AjayaDahal/vtol-plane/README.md

<div align="center">

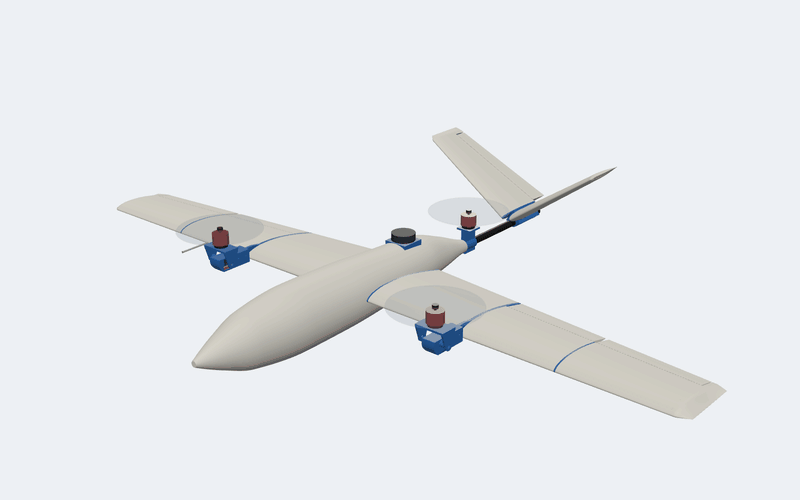
[picture p1: renders/anim_turntable.gif]
The VTOL plane on a turntable: a tilt-rotor tricopter with a V-tail, motors up for hover


# VTOL Plane

### A 3-D printed tilt-rotor tricopter: it takes off like a drone and flies like a plane









**[▶ Open the live 3-D viewer](https://ajayadahal.github.io/vtol-plane/)** ·
[Design](DESIGN.md) · [Bill of materials](BOM.md) · [Print tracker](tracker.md) ·
[PX4 setup](PX4_GUIDE.md) · [Simulation](SIMULATION.md) · [Review report](REPORT.md)

</div>

Two motors on tilting yokes lift the aircraft in hover and swing forward for cruise; a third,
fixed motor at the tail shares the hover load. In forward flight a Clark Y wing and a V-tail carry
it, under PX4 on a Pixhawk 6C. The airframe is a single-wall LW-PLA shell, printed in vase mode,
over PETG ribs and frames and carbon spars and boom.

Every part is generated by Python from one parameter file, laid out and sliced from the command
line, and checked by an automated gate (fits, flush joints, paths, clearances, balance, hover
margin and the G-code itself) before any filament is used. The gate runs on every push.

## At a glance

| | |
|---|---|
| **Configuration** | Tilt-rotor tricopter VTOL: two front motors tilting −20…90°, one fixed rear lift motor, V-tail |
| **Span · length** | 1478 mm · ~1.1 m |
| **All-up weight** | ~2.0 kg with a 4S 5000 mAh pack |
| **Wing** | Clark Y, flat bottom, straight leading edge, 220 → 150 mm chord, 0.27 m², Hoerner tips |
| **Tail** | V-tail, NACA 0012, 110° included angle, ruddervators |
| **Power** | 3 × Emax ECOII 2807 1700 KV, 7 × 4.5 props, 3 × 50 A DShot ESCs |
| **Avionics** | Pixhawk 6C (PX4), M10 GPS on an external saddle, digital airspeed sensor with pitot, ELRS |
| **Speeds** | cruise ~18 m/s, stall 10–11.5 m/s (estimates) |
| **Hover** | ~7 min pure hover (estimate); front motors kept under 60 % of their thrust |
| **Airframe** | LW-PLA vase-mode skins with fused internal webs, PETG structure, carbon tubes |
| **Printers** | Kobra X: every LW-PLA skin (~49 h, one spool) · Kobra S1: the PETG as 7 plates (~16 h) |

Exact numbers (from `scripts/mass_balance.py`): [`DESIGN.md`](DESIGN.md#key-numbers).

## See it move

<table>
<tr>
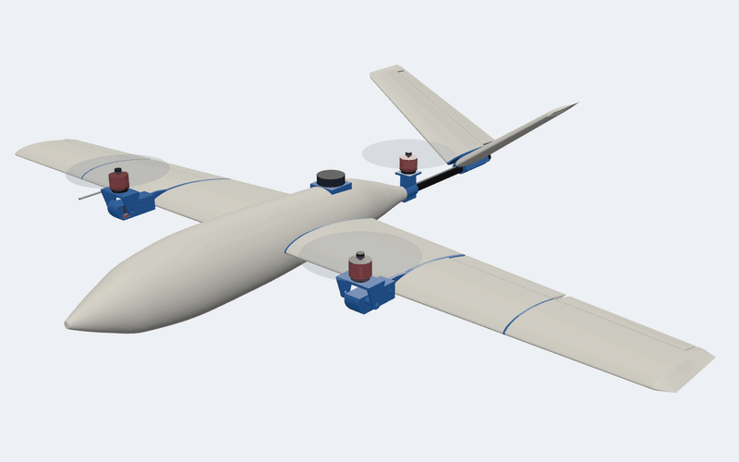
[picture p2: renders/anim_transition.gif]
The front motors tilt from straight up to straight ahead
<td width="50%"><br>
<b>Hover → cruise.</b> The yokes swing the front motors from straight up to straight ahead.</td>
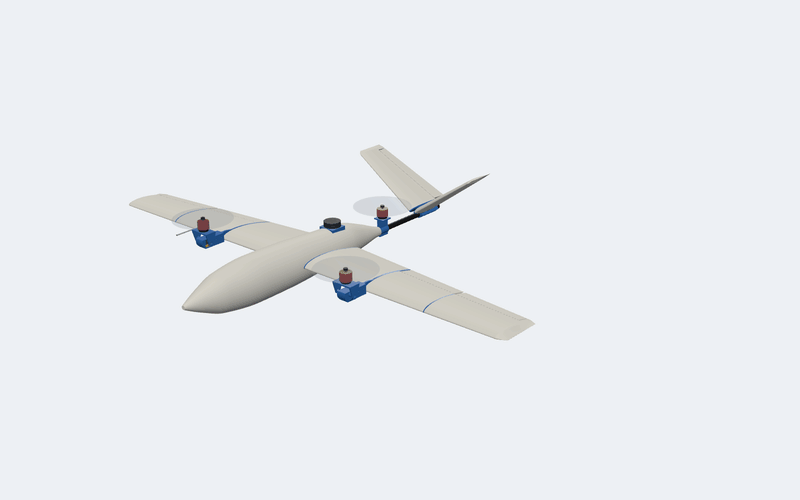
[picture p3: renders/anim_burst.gif]
Burst view: every part moves out along the way it goes together
<td width="50%"><br>
<b>Burst view.</b> Every part moves out along the way it goes together, electronics included.</td>
</tr>
<tr>
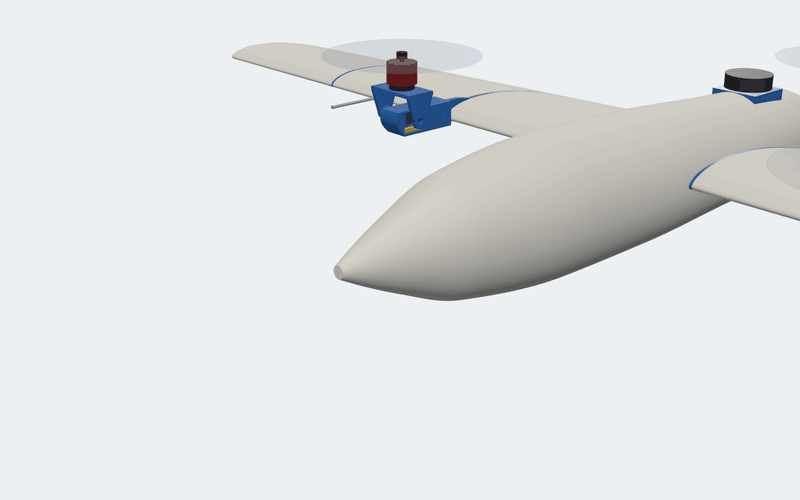
[picture p4: renders/anim_nose_battery.gif]
The nose slides off and the battery comes out forward
<td><br>
<b>Battery change.</b> One nylon screw holds the nose; the pack slides out through the coupler ring.</td>
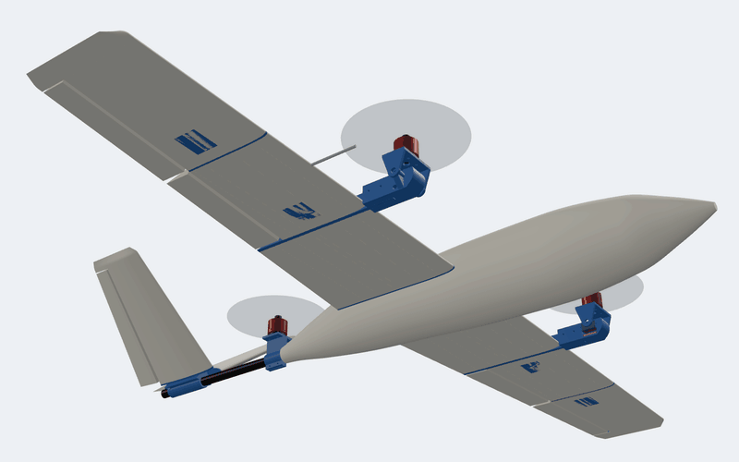
[picture p5: renders/anim_service.gif]
Servo hatches come out, the yokes lift off and the tilt servos slide out
<td><br>
<b>Servicing.</b> Every control servo sits on a screwed hatch, and the yokes lift off their pods.</td>
</tr>
</table>

## See it fly, in simulation

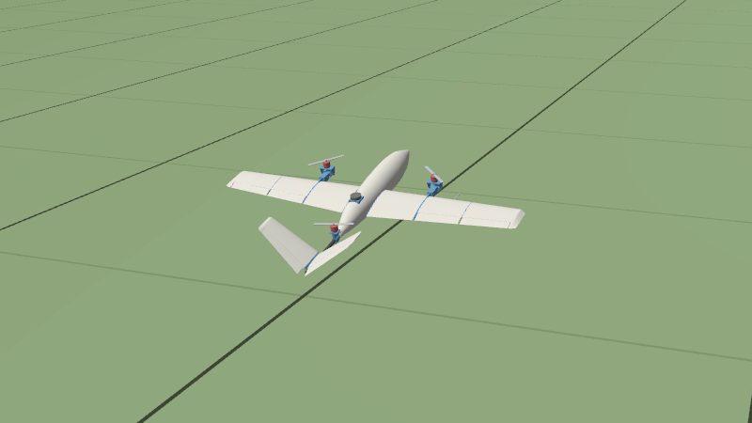
[picture p6: renders/52_sim_flight.png]
The check flight in Gazebo: the back transition, motors swinging up to hover


PX4 v1.17 flies a Gazebo model generated from the design through the whole mission: vertical
takeoff, transition, a circuit at 18 m/s, back transition and a landing on the pad
([video](renders/sim_flight.mp4), 3 min 42 s). It changed the transition: it ends at 14 m/s
and is flown 2° nose-down, because held level the aircraft never reaches 18. Its stress tests
(heavier, a near-empty pack, no airspeed sensor, a wing that lifts more) say to fit the 3S
plan's bigger motors before flying ([`SIMULATION.md`](SIMULATION.md)).

## Explore it in 3-D

| | |
|---|---|
| ✈️ **[Live viewer](https://ajayadahal.github.io/vtol-plane/)** | The full three.js viewer in your browser: orbit, burst view, battery and service animations, tilt slider, x-ray, section cuts, reflection stripes for checking smoothness, and every print file and PETG plate on its printer's bed with its sliced mass and time. |
| 🧊 **[`renders/vtol_plane.stl`](renders/vtol_plane.stl)** | The outside of the whole aircraft in GitHub's own 3-D viewer: drag to spin, scroll to zoom. |
| 💻 **`python scripts/serve_viewer.py`** | The same viewer from your clone, at <http://127.0.0.1:28765/viewer/>. |

The live viewer is this repository served by GitHub Pages (*Settings → Pages → Deploy from a
branch → `main`, `/ (root)`*); the root `index.html` opens `viewer/`.

## Gallery

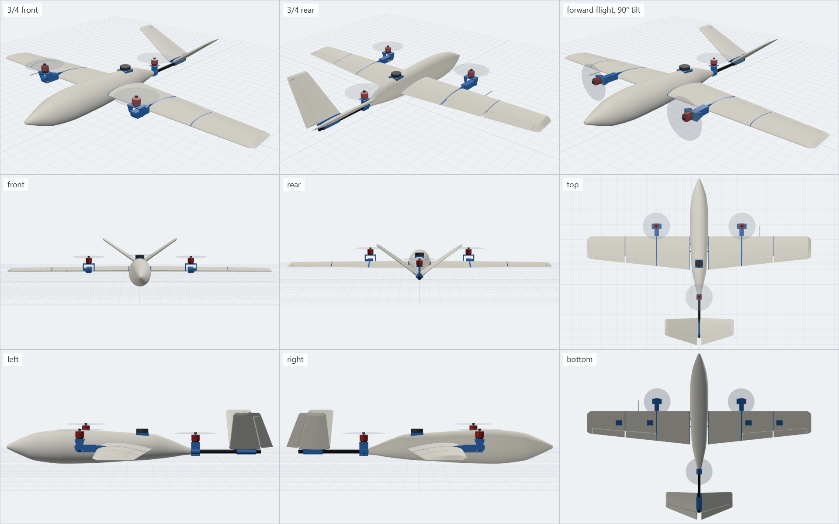
[picture p7: renders/00_all_sides.png]
The aircraft from every side


<details>
<summary><b>Wing smoothness</b>: one colour and reflection stripes across every glued joint</summary>
<br>
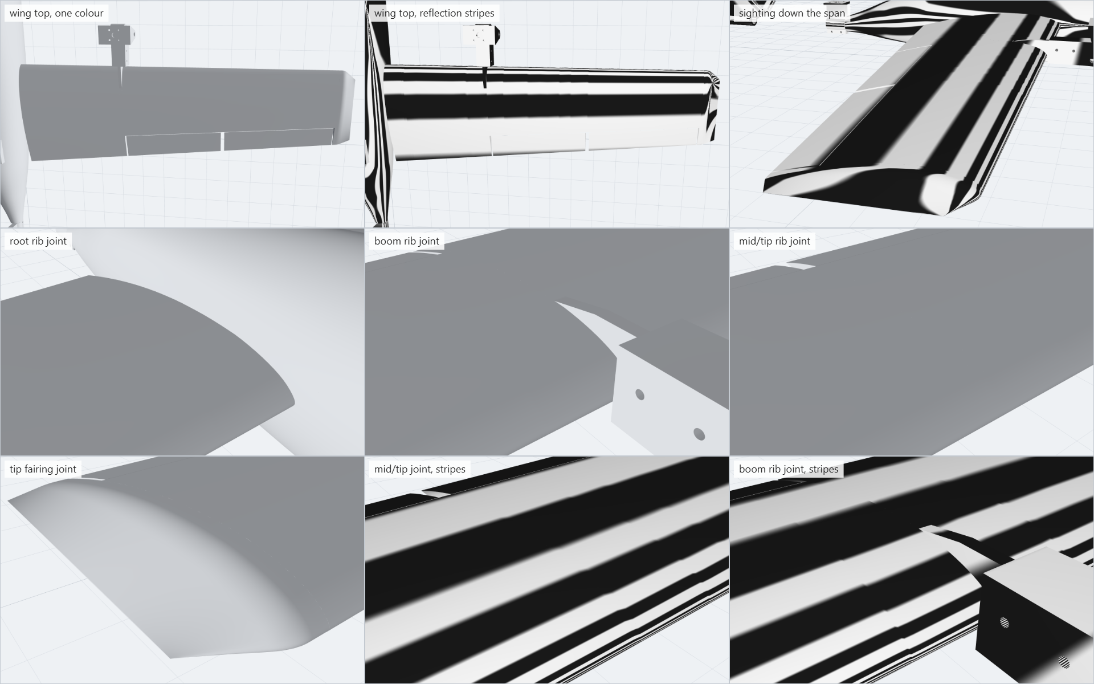
[picture p8: renders/00_wing_smoothness.png]
Wing joints in one colour and with reflection stripes


The stripes run straight across every seam: the rib flanges continue the skin's taper, and the gate
holds every glued joint flush to 0.15 mm ([DESIGN.md](DESIGN.md#finish-making-the-glued-wing-read-as-one-piece)).
</details>

<details>
<summary><b>Inside the airframe</b>: burst view, section cuts and the electronics bay</summary>
<br>
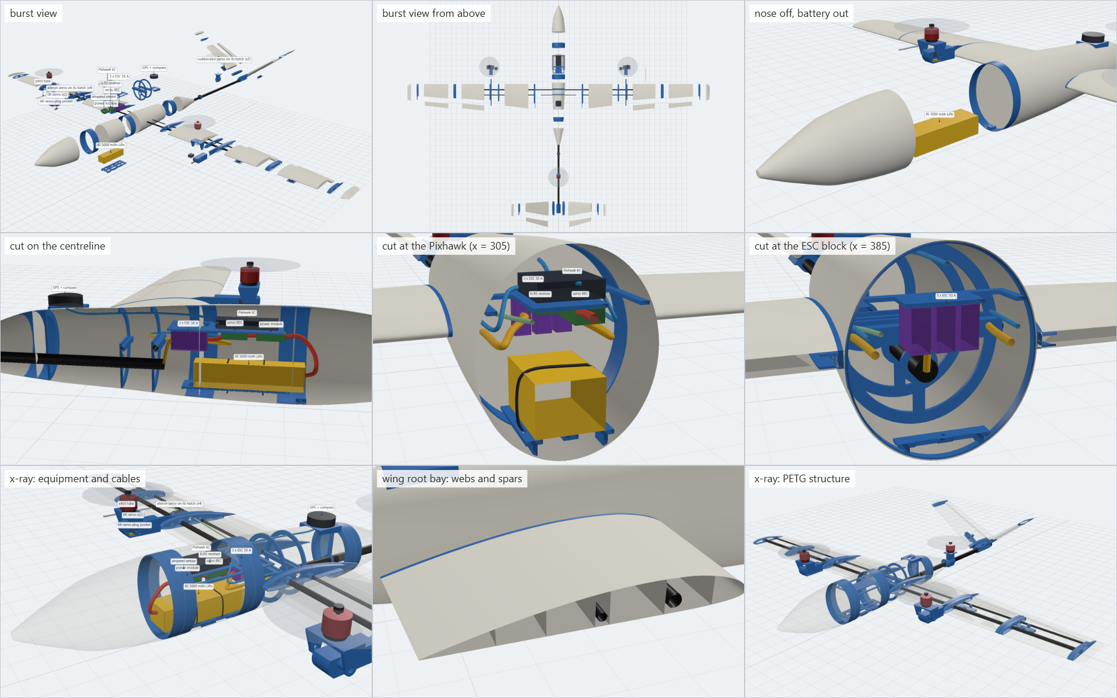
[picture p9: renders/00_inside_and_burst.png]
Burst view, cuts along the centreline, at the Pixhawk and at the ESC block, x-ray

</details>

<details>
<summary><b>Servicing</b>: battery, servo hatches, yokes and tilt servos</summary>
<br>
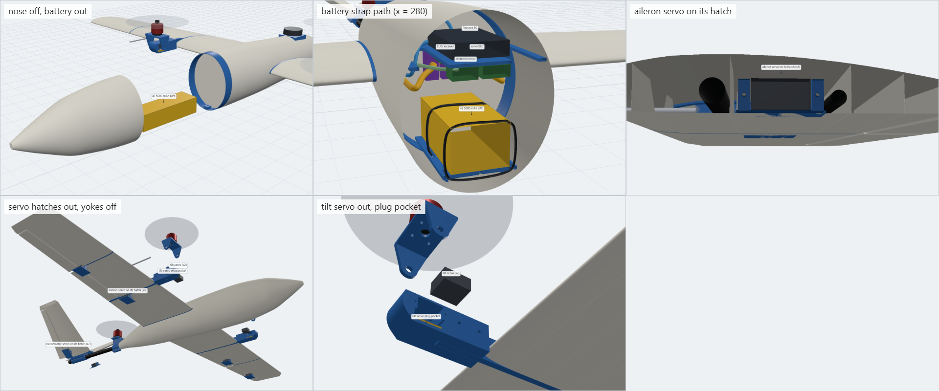
[picture p10: renders/00_servicing.png]
Battery out through the nose, servo hatches out, yokes off

</details>

<details>
<summary><b>Tips</b>: Hoerner wing tips and V-tail tip fairings</summary>
<br>
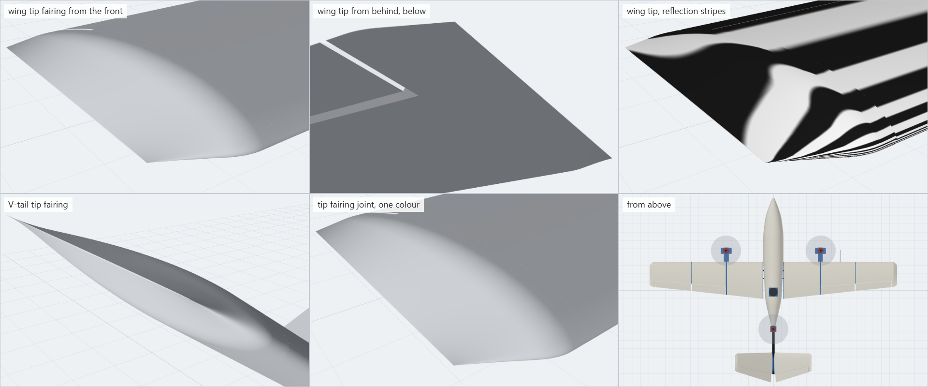
[picture p11: renders/00_tips.png]
Wing and V-tail tip fairings

</details>

<details>
<summary><b>Print files</b>: every part and the seven PETG plates on their beds</summary>
<br>
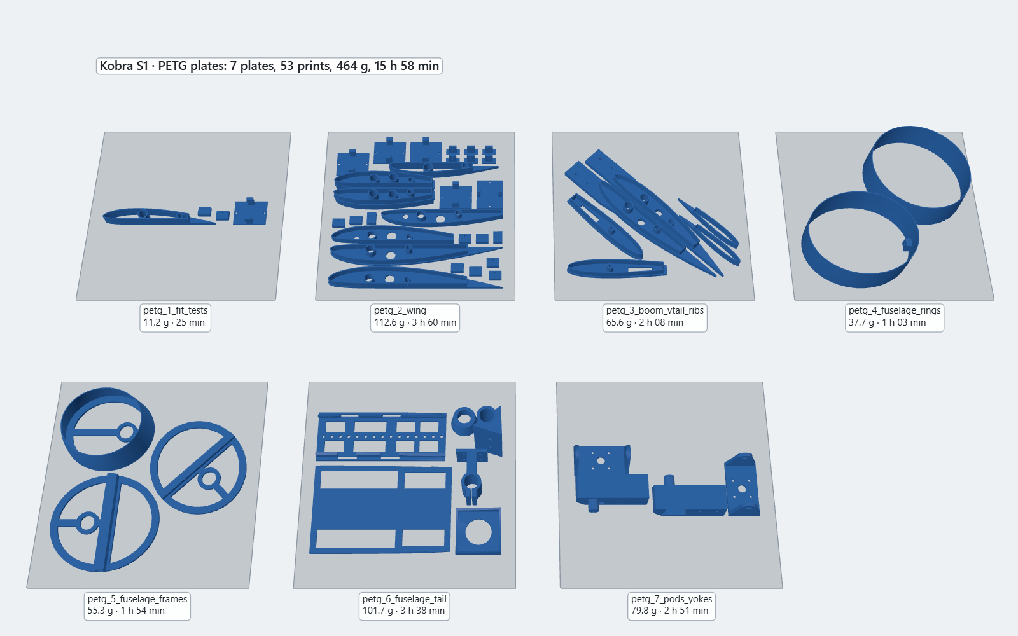
[picture p12: renders/47_print_plates_s1_petg.png]
The seven PETG plates on the Kobra S1

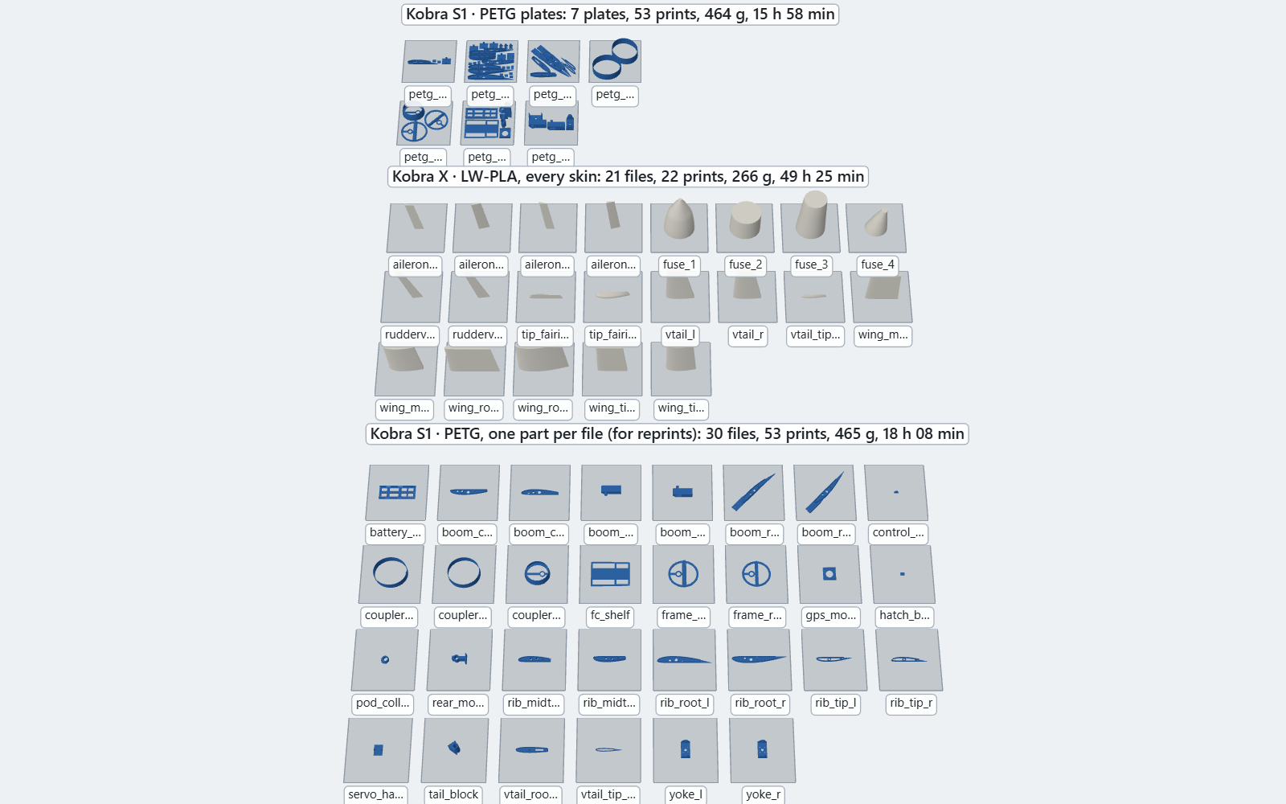
[picture p13: renders/35_print_files_all.png]
Every print file on its bed

</details>

<details>
<summary><b>Sliced</b>: every plate as the slicer prints it, first layers, and where supports would go</summary>
<br>
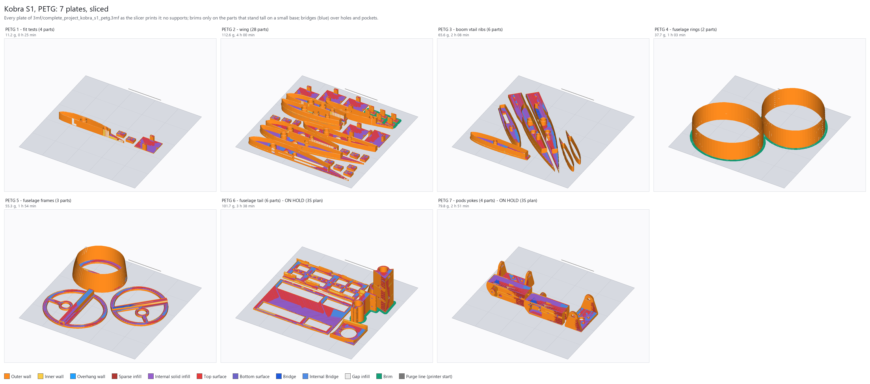
[picture p14: renders/49_sliced_plates_s1_petg.png]
The seven PETG plates sliced: walls, infill, bridges and brims, no supports

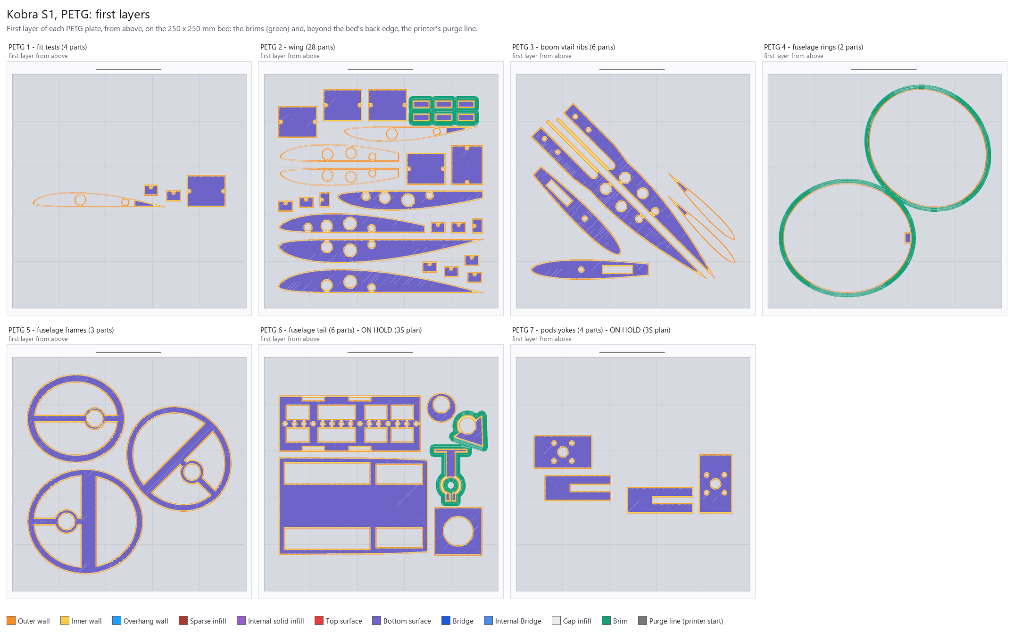
[picture p15: renders/50_first_layers_s1_petg.png]
The PETG plates' first layers from above, with brims and the purge line

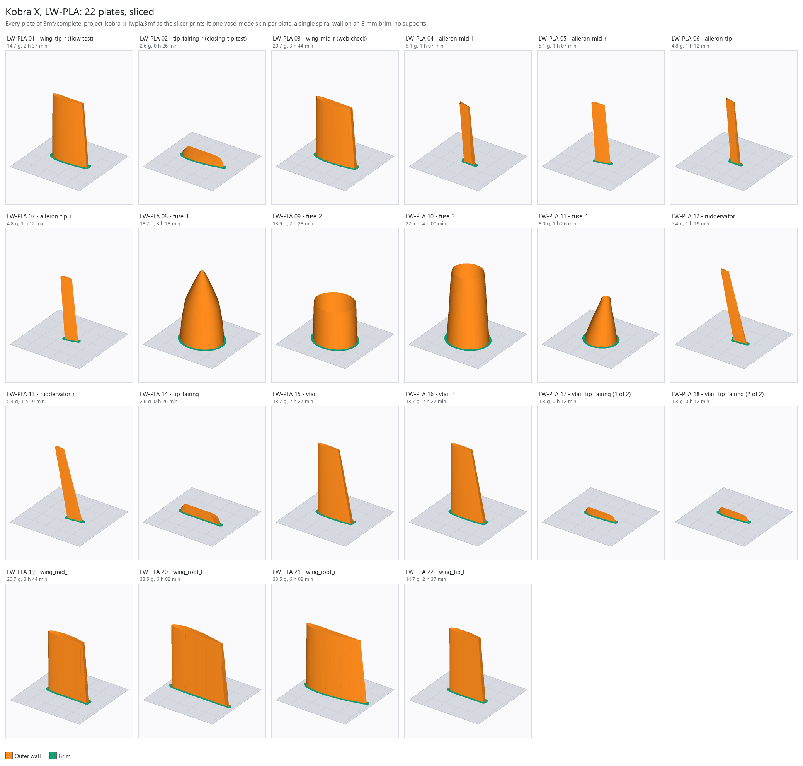
[picture p16: renders/48_sliced_plates_x_lwpla.png]
The Kobra X's 22 LW-PLA plates sliced: one vase skin each on its brim


Drawn from the G-code like the slicer's preview, coloured by feature. No part prints with
supports. Below, where the slicer would add them if it could: all inside holes or under spans
that bridge, which the gate measures in the G-code
([SLICING.md](SLICING.md#slice-previews-and-the-support-audit)).

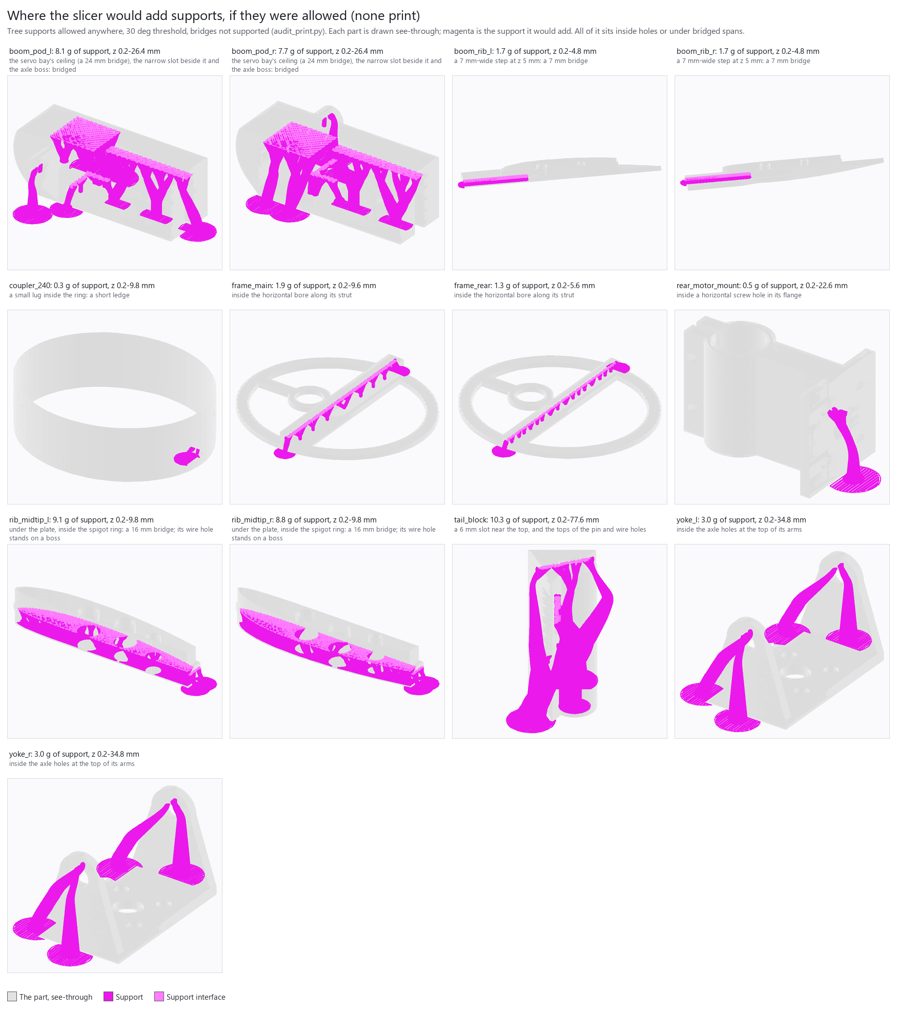
[picture p17: renders/51_support_audit_petg.png]
Where the slicer would add supports, drawn see-through in magenta

</details>

## How it is built

- **Skins** are LW-PLA printed in vase mode: one continuous ~0.5 mm wall, foamed to about half
  the density of PLA. The wing's root and mid sections carry spanwise webs that the single wall
  runs into and fuses to, so the skin does not oil-can
  ([inside the wing](DESIGN.md#inside-the-wing-ribs-spars-and-webs)).
- **Structure** is PETG: ribs whose spigots the skins slide over, fuselage couplers and frames,
  the tilt-servo pods and yokes, the tail block. Carbon tubes do the bending: 10 mm and 6 mm
  wing spars on joiners, a 16 mm tail boom.
- **Joints read as one piece.** Each rib flange continues the skin's taper; the tips close in
  vase-mode fairings over hidden rings ([tips](DESIGN.md#tips)).
- **Nothing replaceable is glued in.** The nose comes off for the battery and the electronics,
  every control servo is on a screwed hatch, and the tilt servos come out with the yokes
  ([servicing](DESIGN.md#servicing-battery-servos-and-motors)).

## From parameters to G-code

```mermaid
flowchart LR
    P["params.py<br/>every dimension"] --> SK["skins.py<br/>LW-PLA vase skins"]
    P --> ST["structure.py<br/>PETG parts, build123d"]
    SK & ST --> AS[("parts/assembly")]
    AS --> PR["make_print_ready.py<br/>print orientation, printer, copies"]
    PR --> PRS[("parts/print_ready")]
    PRS --> SL["slice_all.py + plates.py<br/>Anycubic Slicer Next CLI"]
    SL --> GC[("gcode/")]
    SL --> TM[("3mf/<br/>a project per job")]
    TM --> MP["make_projects.py<br/>a project per printer,<br/>a plate per job"]
    GC --> MV["make_viewer.py<br/>viewer manifest, vtol_plane.stl"]
    MV --> MT["make_tracker.py<br/>tracker tables, schedule chart"]
    GC --> MB["mass_balance.py<br/>mass, CG, hover, PX4 numbers"]
    PL["payload.py<br/>electronics and cable runs"] --> MB
    MB --> SIM["make_sim.py<br/>Gazebo model, PX4 airframe"]
    MT & MB & MP & SIM --> G{{"check_parts.py<br/>verification gate"}}
```

Change a number in `scripts/params.py` and run `python scripts/build_all.py`. It rebuilds every
part, re-slices every file and plate, assembles the two complete slicer projects (and slices each
of their plates again to check it), regenerates the viewer, the tracker, the schedule chart and
the flight simulation's model, and runs the gate.

<details>
<summary><b>What the gate checks</b></summary>
<br>

- **Meshes:** watertight, left and right parts true mirror images, parts printed from one file for
  both sides truly symmetric.
- **Fits:** every spigot, coupler, frame, ring and hatch, with its glue gap.
- **Finish:** every glued skin joint flush and crease-free.
- **Paths:** spars, joiners, the tail boom and every wire route are clear.
- **Mechanism:** motor screw holes with hex-key room, the tilt sweep, and the prop clearances.
- **Balance:** thrust split, CG band, static margin, and the hover margin (front motors at most
  60 % of their near-empty thrust).
- **Printability:** no part needs supports (overhangs are bridges or short ledges), and no vase
  wall leans more than 45°.
- **Equipment:** every item fits clear of the skin and the inserts, the battery slides out
  through the nose, the straps loop round it, and every servo comes out through its hatch.
- **G-code:**
  - every part and plate is present and sliced from the current STL (hash stamps), with no stray
    files;
  - every move is inside the printer's height and every extrusion inside its bed;
  - there are no support moves, and the vase walls print in one speed band;
  - the wing webs print fused, and every part is its own object where the script placed it;
  - brims only where the print table puts them: every vase skin, and the PETG parts that stand
    taller than the root of their first-layer contact area;
  - nothing far over air: every PETG bridge spans at most 30 mm, every wall lies within 3 mm of
    the layer below.
- **Slicer projects:** each job's 3MF carries the G-code's stamp and the right presets, and the
  two complete projects are what `make_projects.py` builds from them.
- **Docs:** the viewer manifest, `tracker.md`, the schedule chart and the slice previews match the
  sliced files.
- **Simulation:** the Gazebo model, world and PX4 airframe in `sim/` are what `make_sim.py` builds
  from the current design, and the model's static margin agrees with the mass balance.

The results and the reasoning behind every check: [`REPORT.md`](REPORT.md).
</details>

## Printing it

Print queue: the Kobra X prints every LW-PLA skin, the Kobra S1 seven PETG plates

One material per printer. The **Kobra X** prints every LW-PLA skin, from one spool with one flow
calibration. The skins print one per job: vase-mode parts can share a bed only by printing one
after another, and the skins stand taller than the print head's gantry clearance. The
**Kobra S1** prints all the PETG, laid out as seven plates in build order. Start with the test
prints (orange above): `wing_tip_r` checks the LW-PLA flow, and plate `petg_1_fit_tests` checks
the spigot and servo-hatch fits. The files are sliced for **active-foaming** LW-PLA
([`BOM.md`](BOM.md#filament)). Then work down [`tracker.md`](tracker.md), which also
carries the [reminders](tracker.md#reminders-for-print-time-agents-raise-these-with-the-user-when-printing-starts)
to tick off along the way. The chart is redrawn from the sliced files on every build.

Every job comes three ways:
- **a complete project per printer**, the easiest:
  [`3mf/complete_project_kobra_x_lwpla.3mf`](3mf/complete_project_kobra_x_lwpla.3mf) (22 plates)
  and [`3mf/complete_project_kobra_s1_petg.3mf`](3mf/complete_project_kobra_s1_petg.3mf)
  (7 plates). Each job is a named plate, in print order (`LW-PLA 01 - wing_tip_r (flow test)`,
  `PETG 6 - fuselage tail (6 parts) - ON HOLD (3S plan)`). Open it in Anycubic Slicer Next, pick
  a plate, slice it, check the preview and send it;
- a **3MF project per job** in [`3mf/`](3mf), in the same folders and under the same names as
  the G-code;
- **G-code** in [`gcode/`](gcode), the same job already sliced.

The projects hold the parts in place and every setting, and the G-code is sliced from them
([`SLICING.md`](SLICING.md#3mf-projects-sending-a-job-from-the-slicer)).

## Flight setup

```mermaid
flowchart LR
    BAT["4S 5000 mAh LiPo"] -- XT60 --> PM["Power module<br/>voltage + current"]
    PM -- power --> FC(["Pixhawk 6C · PX4"])
    PM --> ESC["3 × 50 A ESC block"]
    PM --> BEC["Servo BEC 5–6 V"]
    FC -- "AUX1–3 · DShot600" --> ESC
    ESC --> MR["Front right motor · CW"] & ML["Front left motor · CCW"] & MRR["Rear motor · CCW"]
    FC -- "MAIN1–2" --> TS["2 tilt servos"]
    FC -- "MAIN3–6" --> AI["4 aileron servos"]
    FC -- "MAIN7–8" --> RV["2 ruddervator servos"]
    BEC -. servo rail .-> TS & AI & RV
    GPS["M10 GPS + compass<br/>on the saddle"] --> FC
    ASP["Airspeed sensor<br/>pitot in the right wing"] --> FC
    RX["ELRS receiver"] --> FC
```

PX4 runs it as a *Generic Tiltrotor VTOL* with three rotors and two tilt servos.
[`PX4_GUIDE.md`](PX4_GUIDE.md) has:

- the rotor geometry and the [output mapping](PX4_GUIDE.md#output-mapping);
- tilt calibration, transition airspeeds and failsafes;
- the [first-flight sequence](PX4_GUIDE.md#first-flight-sequence).

[`SIMULATION.md`](SIMULATION.md) flies these settings in PX4's simulator, on a Gazebo model
generated from the design.

## Quick start

```bash
python -m venv .venv
.venv\Scripts\activate             # Windows; elsewhere: source .venv/bin/activate
pip install -r requirements.txt

python scripts/check_parts.py      # run the gate on the committed files
python scripts/serve_viewer.py     # the 3-D viewer at http://127.0.0.1:28765/viewer/
python scripts/build_all.py        # rebuild, re-slice and verify everything
```

`build_all.py` needs Anycubic Slicer Next 2.0.0.3: set `VTOL_SLICER` if it is not at the default
Windows path, or pass `--no-slice` to rebuild without slicing ([`SLICING.md`](SLICING.md)). To
re-render the pictures and animations after a change, open the viewer with `?capture=1` (or
`?capture=gif` for the animations only) while `serve_viewer.py` runs.

## Repository map

```text
scripts/            Python: generators, slicing pipeline, mass balance and the gate
  params.py           every dimension
  skins.py            LW-PLA vase skins: wing, fuselage, V-tail, control surfaces, tip fairings
  structure.py        PETG parts (build123d)
  payload.py          electronics: size, position and cable runs
  make_print_ready.py the print table: printer, orientation, copies
  plates.py           PETG plate layouts
  slice_all.py        slices every part and plate
  make_projects.py    the two complete slicer projects, a plate per job
  preview_slices.py   slice previews: every plate drawn from its G-code (renders/48-50)
  audit_print.py      support and stability audit in the slicer (not part of the gate; renders/51)
  mass_balance.py     mass, CG, hover thrust, PX4 numbers
  make_viewer.py      viewer manifest and renders/vtol_plane.stl
  make_tracker.py     tracker tables and renders/print_schedule.svg
  make_sim.py         the PX4 SITL model: Gazebo model, world and airframe in sim/
  check_parts.py      the verification gate
  build_all.py        all of the above, in order
  serve_viewer.py     local server for the viewer and its capture mode
sim/                PX4 + Gazebo flight simulation: install script, check flight, chase camera,
                      stress variants, and the generated model, world and airframe (SIMULATION.md)
parts/assembly/     every part where it sits in the aircraft (STL)
parts/print_ready/  every part as it lies on the bed (STL)
gcode/              x_lwpla, s1_petg (one part per file), s1_petg_plates
3mf/                slicer projects: complete_project_kobra_x_lwpla.3mf and complete_project_kobra_s1_petg.3mf
                      (a named plate per job), and one per job in the same folders as gcode/
slicer_profiles/    printer, process and filament profiles
viewer/             the three.js viewer and its manifest
renders/            pictures, animations, the exterior model and the print schedule
```

## Status

**v0.2: designed, sliced and verified; the test prints are next.** On the way to first flight
([`REPORT.md`](REPORT.md#current-status-v02-nov-5-2026)):

1. Test prints: LW-PLA flow, spigot and servo-hatch fit, the closing tips, the wing webs.
2. Measure the tilt servos against the pod bay before printing the pods and yokes.
3. Weigh the real parts and re-run the mass balance. The hover margin is thin.
4. Balance at the design CG, then glide-test.
5. Bench tests with the props off, then the first hover, then transitions at altitude.

**Simulated:** the whole mission flies in PX4 + Gazebo on `PX4_GUIDE.md`'s settings, which the
simulation and a premortem changed: the transition ends at 14 m/s and is flown 2° nose-down,
and the failsafes are set ([`SIMULATION.md`](SIMULATION.md)). The premortem's verdict: no
printed part changes, but fit the 3S plan's motors before flying (`REPORT.md`, round 13).

**Next design change: the 3S build** ([`PLAN_3S.md`](PLAN_3S.md), not built in yet). The
owner flies his own 3S packs and a Cube Black, with SunnySky X2814 900KV motors on 12 in
props. Modelled, the front motors hover at about half their thrust instead of ~59 %, for about
18 min of pure hover. Only PETG plates 6 and 7 change, so everything else prints now.

## Documentation

| File | What is in it |
|---|---|
| [`DESIGN.md`](DESIGN.md) | configuration, key numbers, parts map, assembly, servicing, hand-drilled holes |
| [`BOM.md`](BOM.md) | everything to buy, and every printed part |
| [`tracker.md`](tracker.md) | every print job and plate, print-time reminders, status |
| [`SLICING.md`](SLICING.md) | slicer profiles, the pipeline and the G-code checks |
| [`PX4_GUIDE.md`](PX4_GUIDE.md) | PX4 setup: geometry, outputs, tilt calibration, airspeeds, first flight |
| [`SIMULATION.md`](SIMULATION.md) | the PX4 + Gazebo flight simulation: the model, the results, how to run and film it |
| [`PLAN_3S.md`](PLAN_3S.md) | the planned 3S build with the owner's parts: motor choice, changes, what to buy |
| [`BOM_3S.csv`](BOM_3S.csv) | the 3S build's shopping list: every item, from the owner's parts or to buy (opens in Excel) |
| [`REPORT.md`](REPORT.md) | every design review and premortem, and the current status |
| [`AGENTS.md`](AGENTS.md) | working notes for AI coding agents on this repository |
