AjayaDahal/vtol-plane/renders/03_front.png

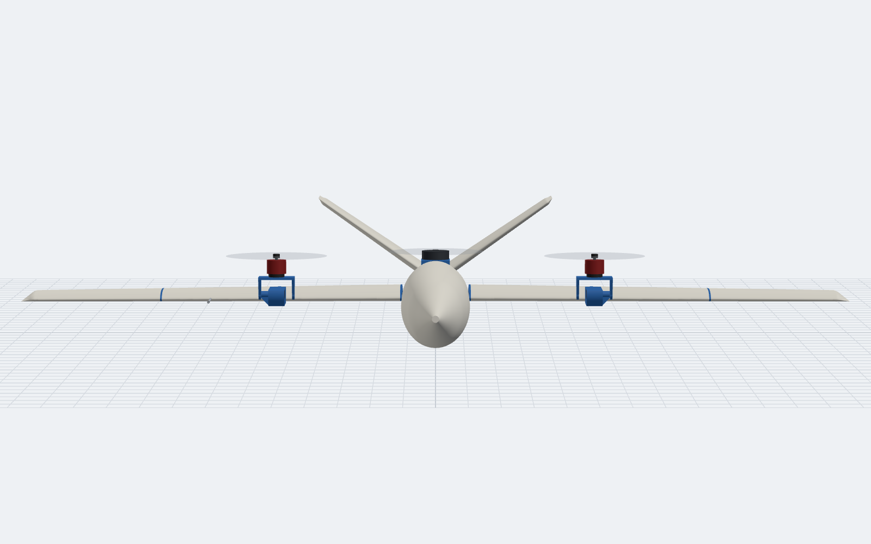
renders/03_front.png
