AjayaDahal/vtol-plane/renders/04_rear.png

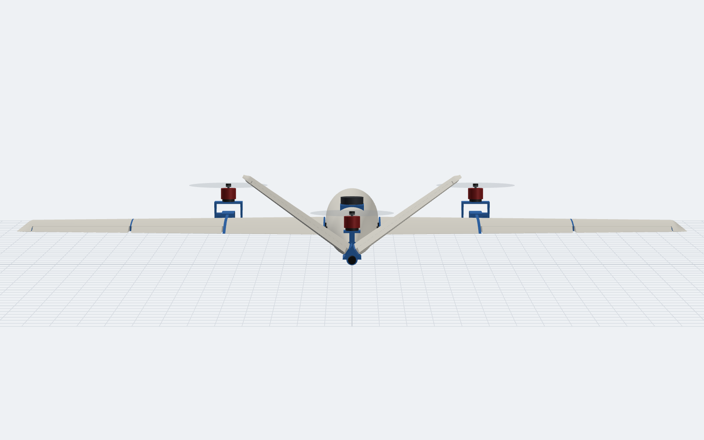
renders/04_rear.png
