AjayaDahal/vtol-plane/renders/05_left.png

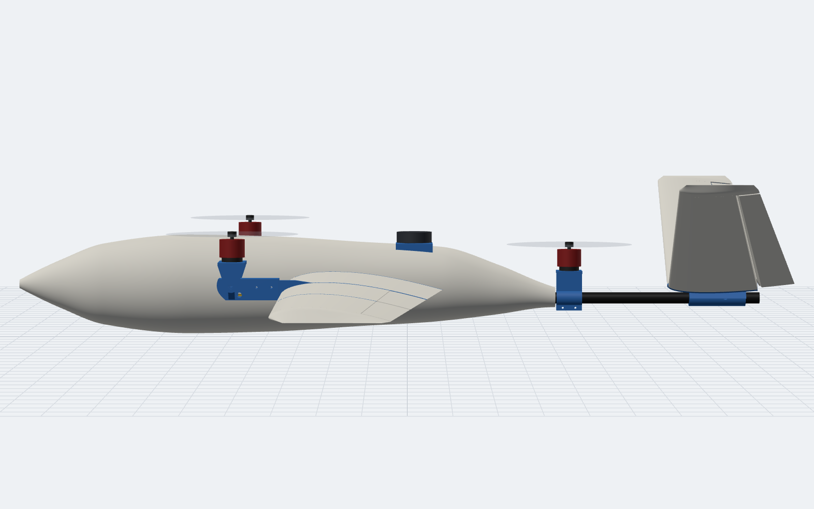
renders/05_left.png
