AjayaDahal/vtol-plane/renders/06_right.png

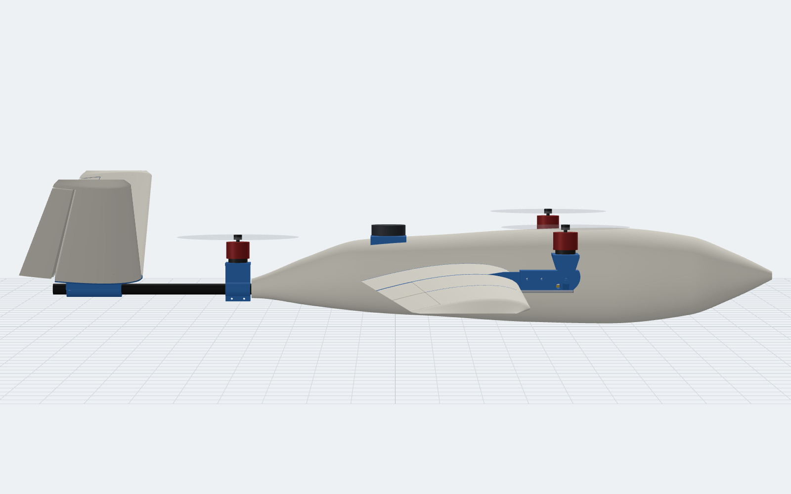
renders/06_right.png
