AjayaDahal/vtol-plane/renders/07_top.png

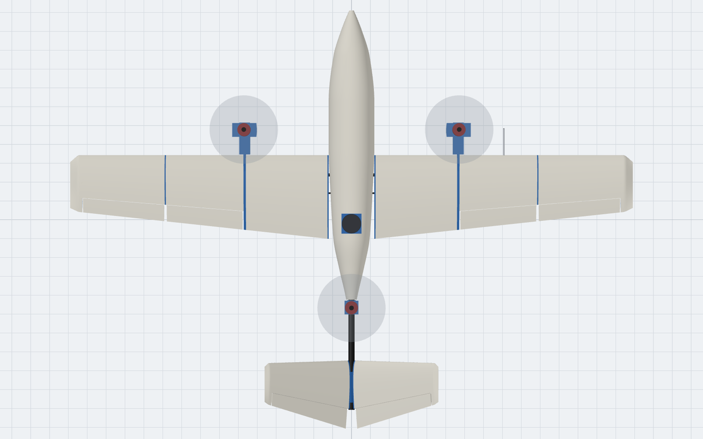
renders/07_top.png
