AjayaDahal/vtol-plane/renders/08_bottom.png

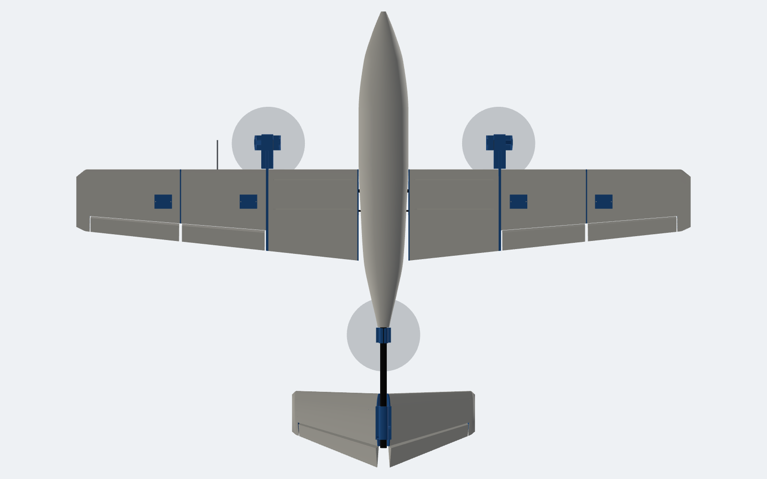
renders/08_bottom.png
