AjayaDahal/vtol-plane/renders/09_forward_flight.png

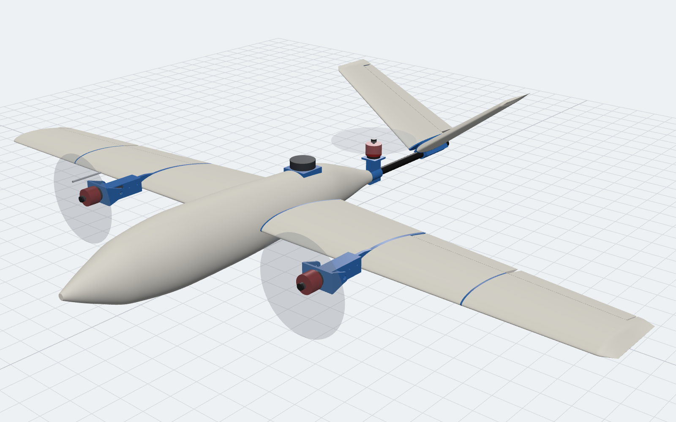
renders/09_forward_flight.png
