AjayaDahal/vtol-plane/renders/10_xray_structure.png

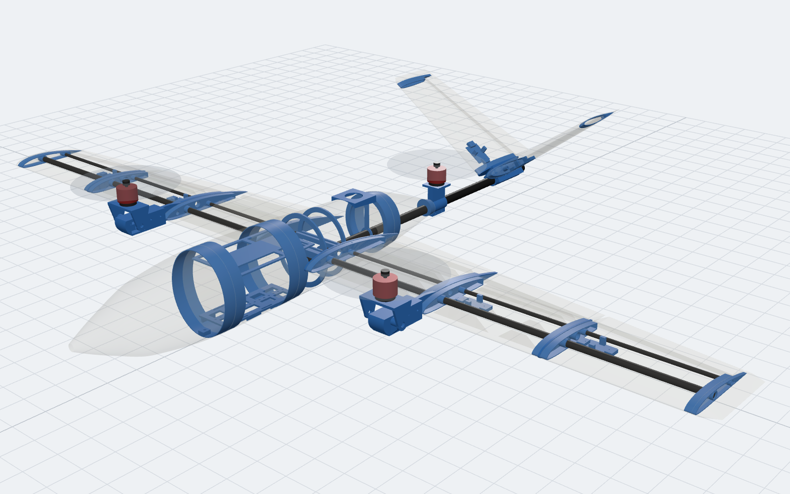
renders/10_xray_structure.png
