AjayaDahal/vtol-plane/renders/12_wing_top_one_colour.png

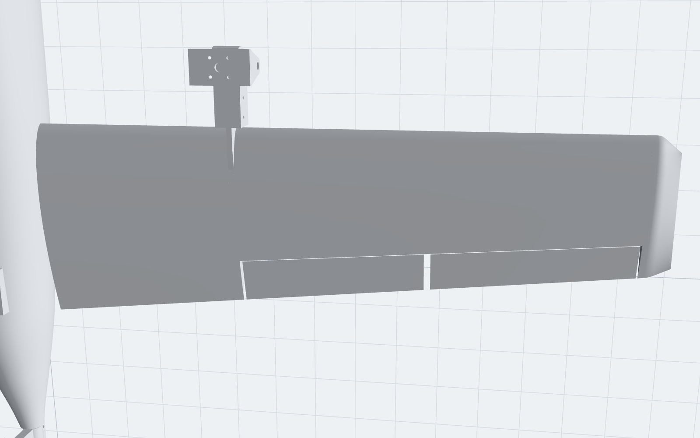
renders/12_wing_top_one_colour.png
