AjayaDahal/vtol-plane/renders/13_wing_leading_edge_one_colour.png

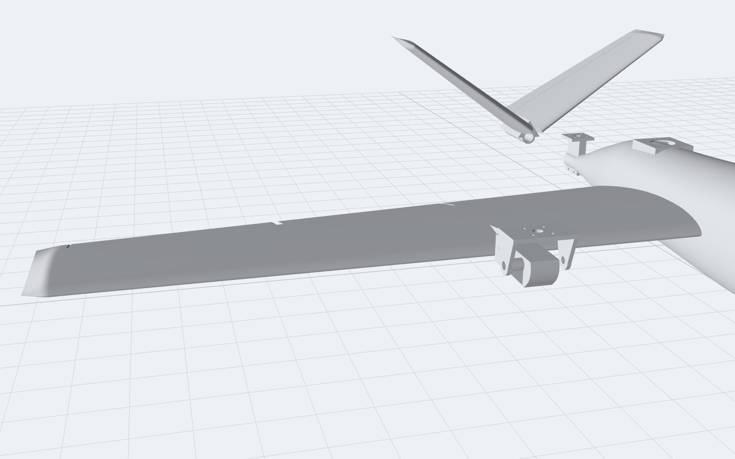
renders/13_wing_leading_edge_one_colour.png
