AjayaDahal/vtol-plane/renders/14_wing_sight_down_span_one_colour.png

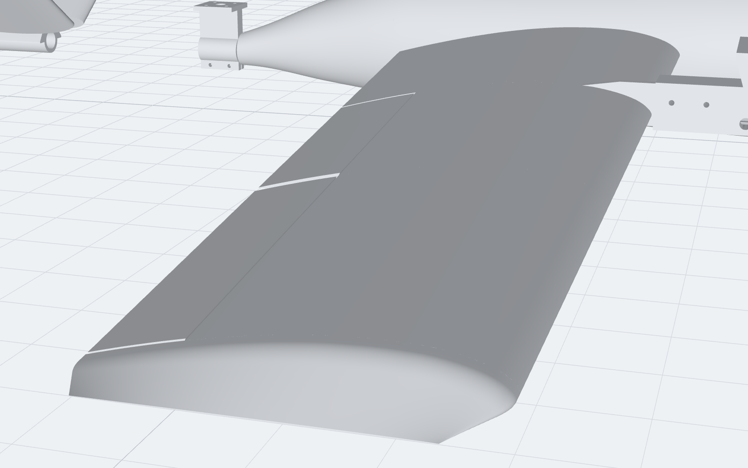
renders/14_wing_sight_down_span_one_colour.png
