AjayaDahal/vtol-plane/renders/15_wing_underside_one_colour.png

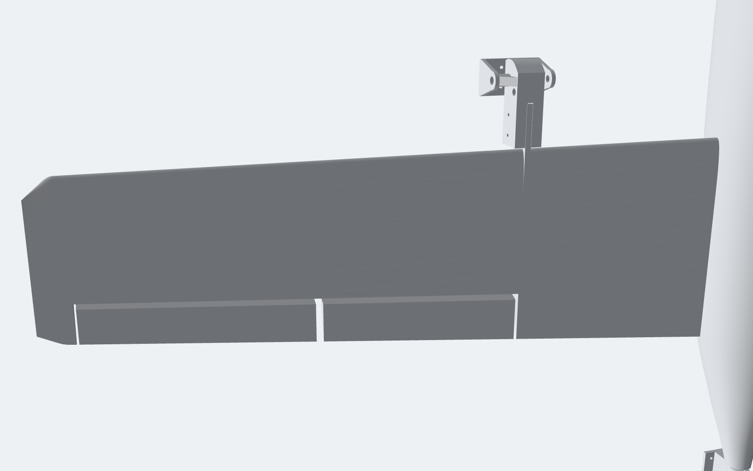
renders/15_wing_underside_one_colour.png
