AjayaDahal/vtol-plane/renders/16_wing_by_part.png

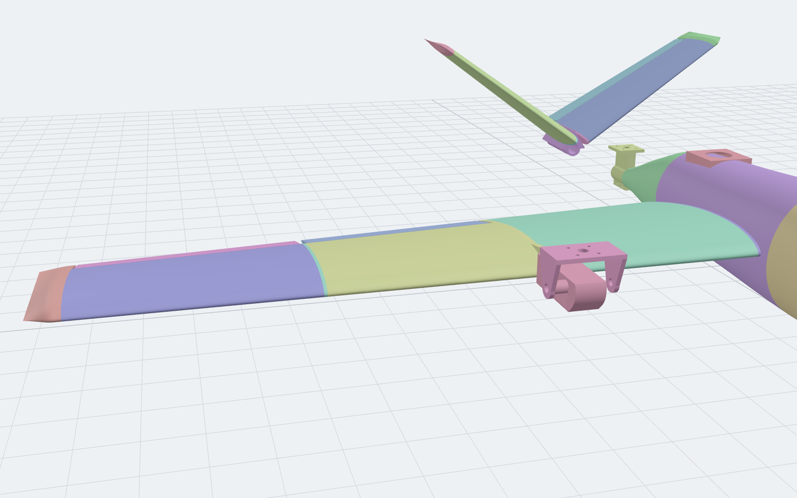
renders/16_wing_by_part.png
