AjayaDahal/vtol-plane/renders/17_joint_root.png

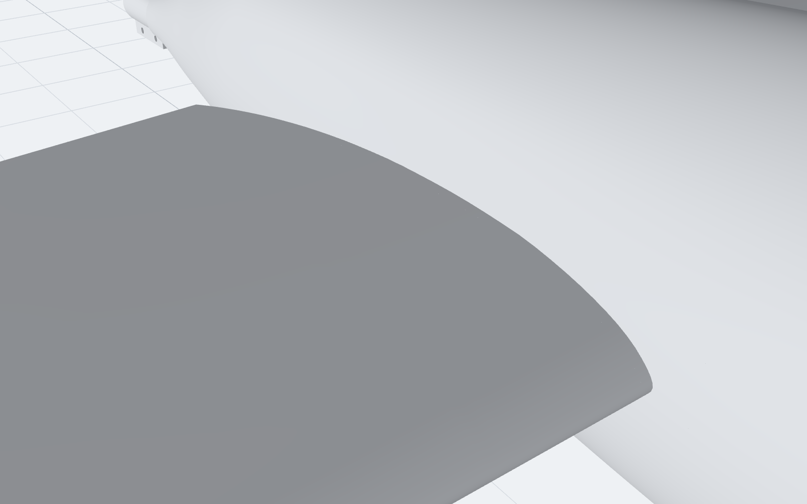
renders/17_joint_root.png
