AjayaDahal/vtol-plane/renders/18_joint_boom_rib.png

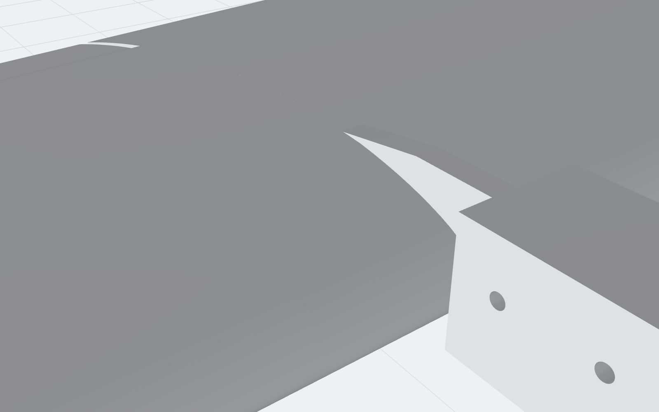
renders/18_joint_boom_rib.png
