AjayaDahal/vtol-plane/renders/19_joint_mid_tip.png

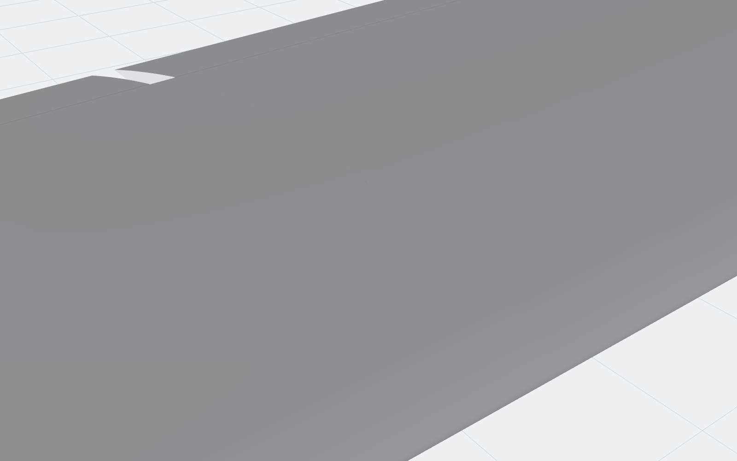
renders/19_joint_mid_tip.png
