AjayaDahal/vtol-plane/renders/20_joint_tip.png

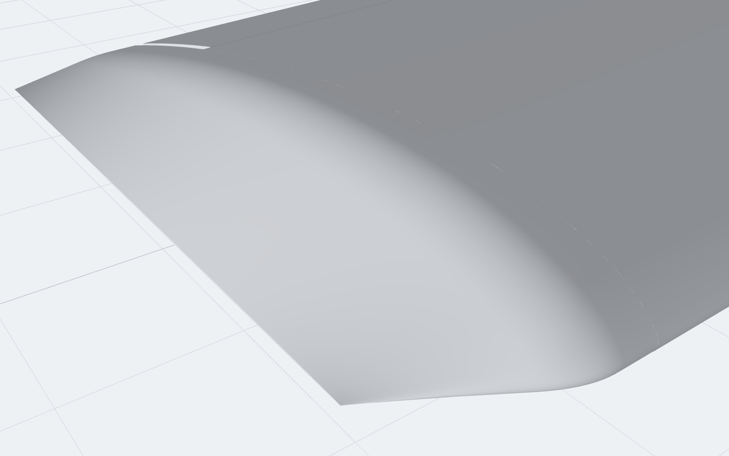
renders/20_joint_tip.png
