AjayaDahal/vtol-plane/renders/22_wing_top_reflection_stripes.png

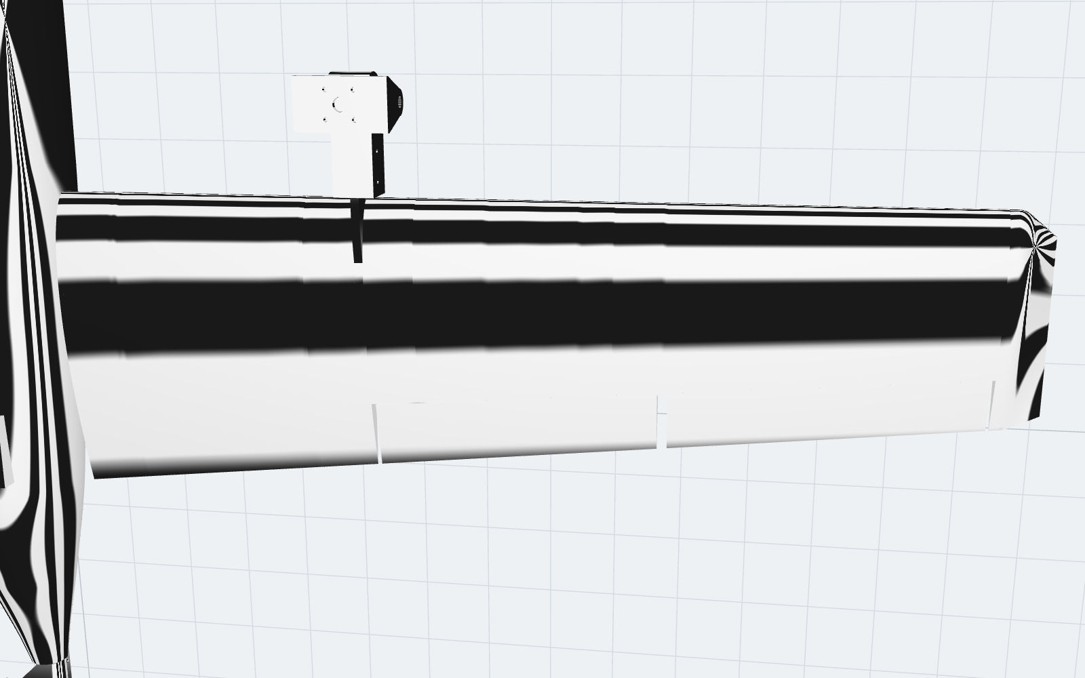
renders/22_wing_top_reflection_stripes.png
