AjayaDahal/vtol-plane/renders/23_wing_sight_down_span_reflection_stripes.png

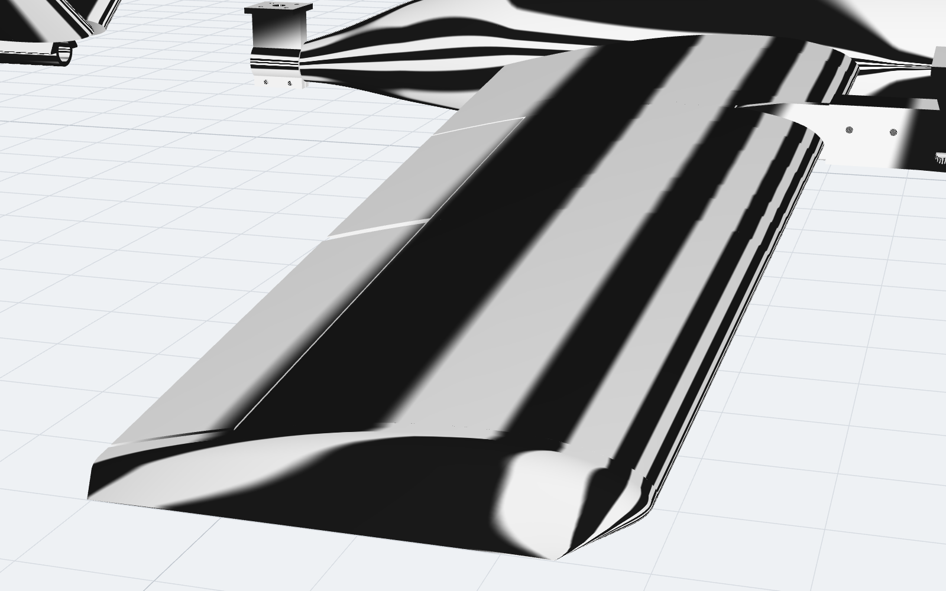
renders/23_wing_sight_down_span_reflection_stripes.png
