AjayaDahal/vtol-plane/renders/24_joint_mid_tip_reflection_stripes.png

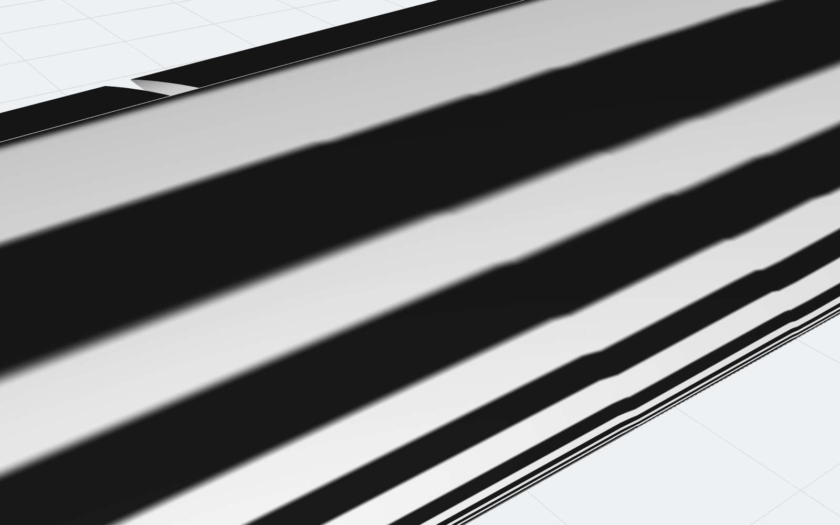
renders/24_joint_mid_tip_reflection_stripes.png
