AjayaDahal/vtol-plane/renders/25_joint_boom_rib_reflection_stripes.png

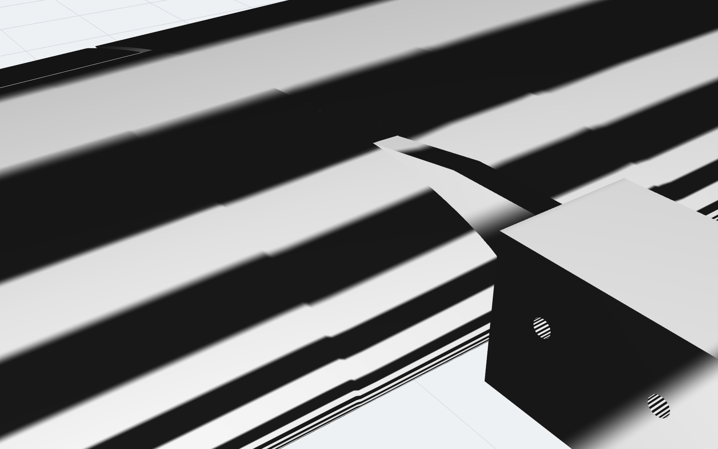
renders/25_joint_boom_rib_reflection_stripes.png
