AjayaDahal/vtol-plane/renders/27_burst_view.png

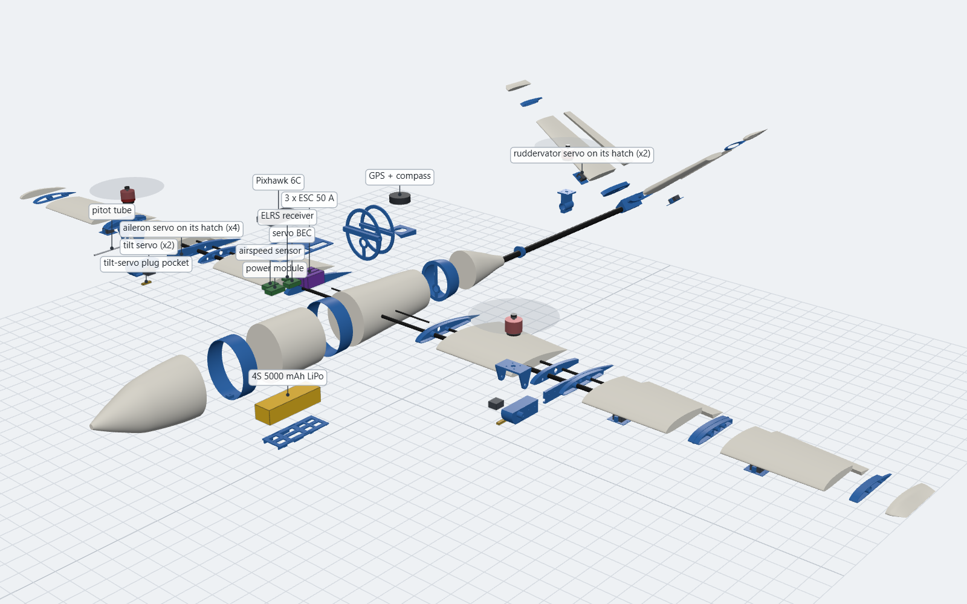
renders/27_burst_view.png
