AjayaDahal/vtol-plane/renders/28_burst_view_top.png

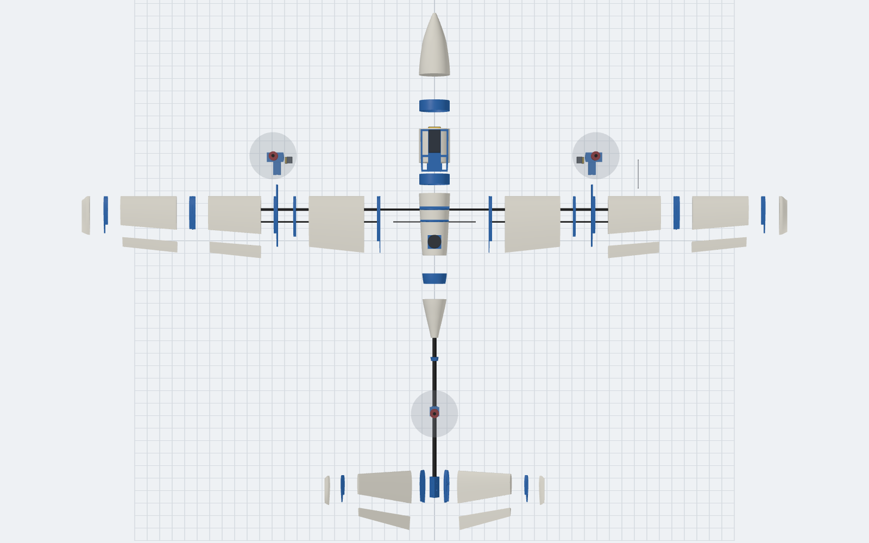
renders/28_burst_view_top.png
