AjayaDahal/vtol-plane/renders/29_cut_centreline.png

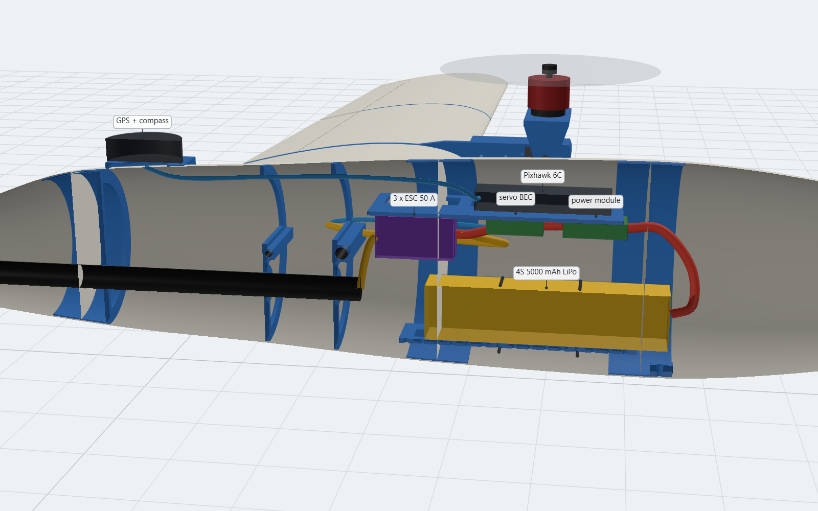
renders/29_cut_centreline.png
