AjayaDahal/vtol-plane/renders/30_cut_at_pixhawk.png

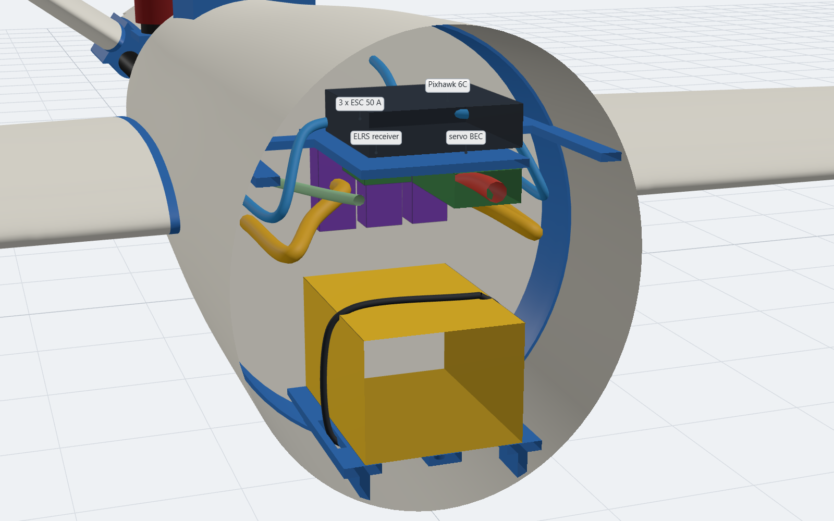
renders/30_cut_at_pixhawk.png
