AjayaDahal/vtol-plane/renders/31_cut_at_esc_block.png

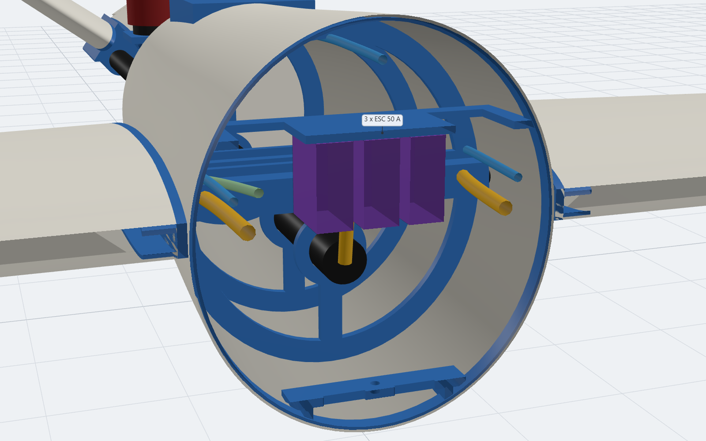
renders/31_cut_at_esc_block.png
