AjayaDahal/vtol-plane/renders/32_nose_open_battery_out.png

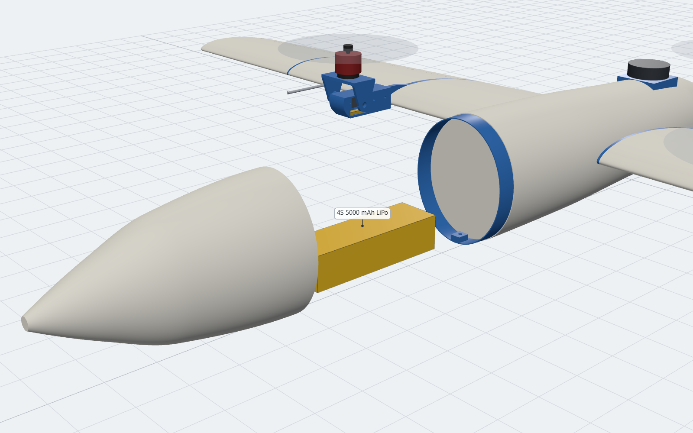
renders/32_nose_open_battery_out.png
