AjayaDahal/vtol-plane/renders/33_xray_equipment_and_cables.png

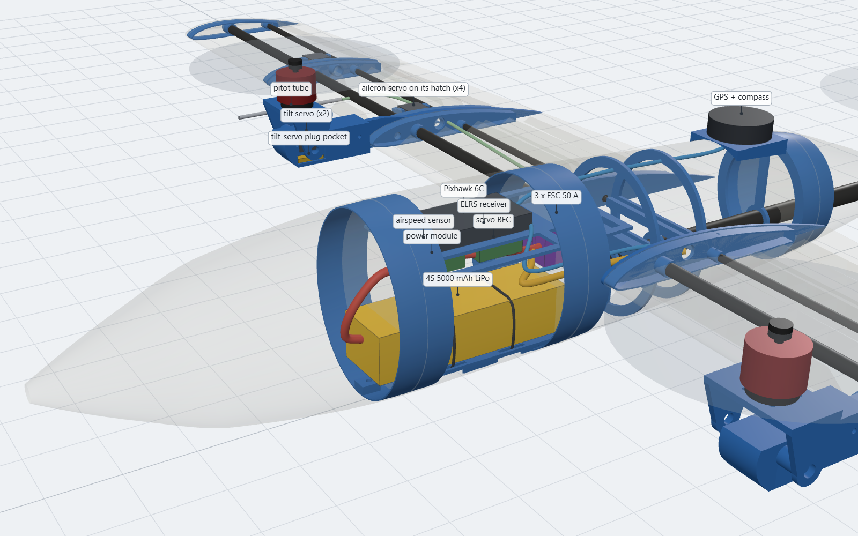
renders/33_xray_equipment_and_cables.png
