AjayaDahal/vtol-plane/renders/34_cut_wing_root_webs_and_spars.png

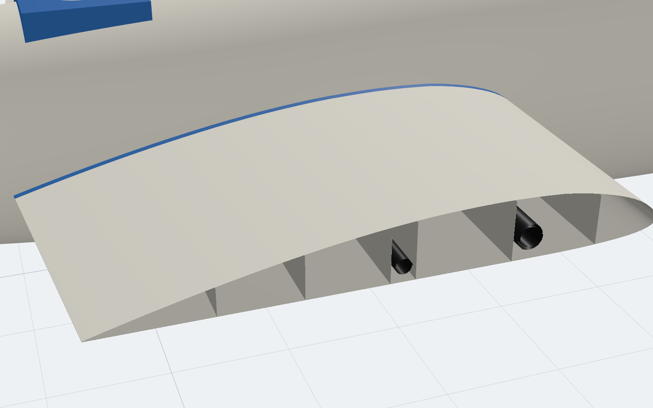
renders/34_cut_wing_root_webs_and_spars.png
