AjayaDahal/vtol-plane/renders/39_service_hatches_open_yokes_off.png

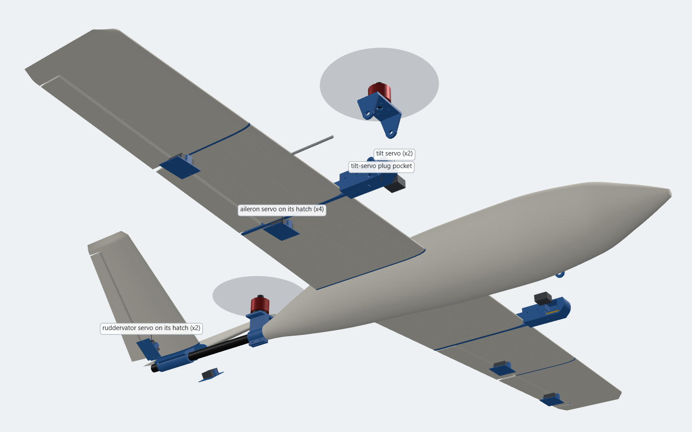
renders/39_service_hatches_open_yokes_off.png
