AjayaDahal/vtol-plane/renders/40_service_tilt_servo_and_plug_pocket.png

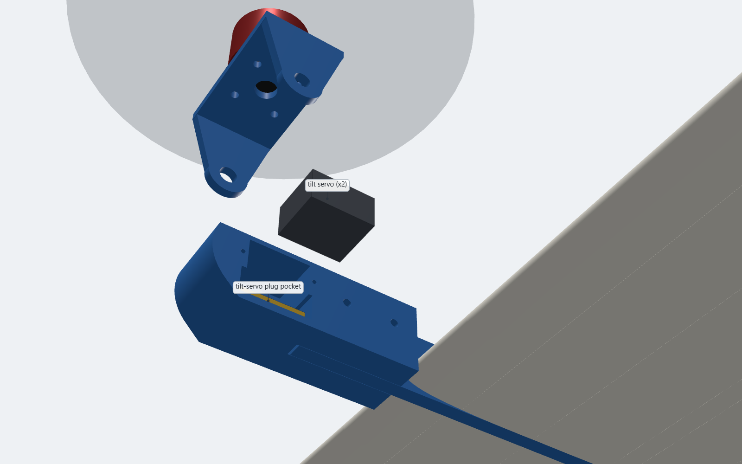
renders/40_service_tilt_servo_and_plug_pocket.png
