AjayaDahal/vtol-plane/renders/41_cut_at_battery_strap.png

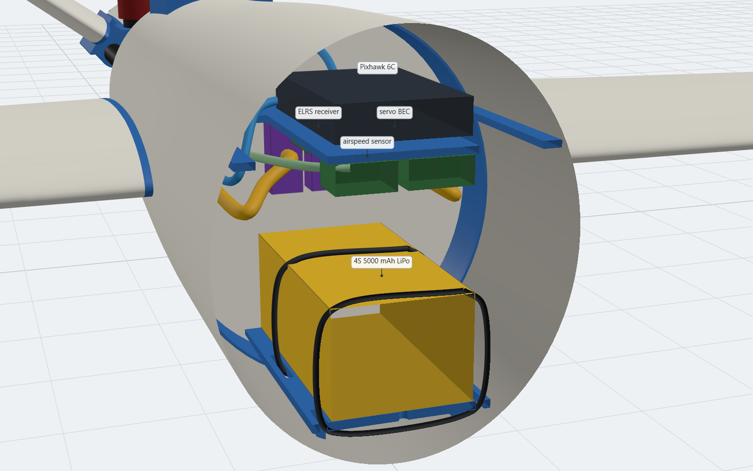
renders/41_cut_at_battery_strap.png
