AjayaDahal/vtol-plane/renders/42_cut_through_aileron_hatch.png

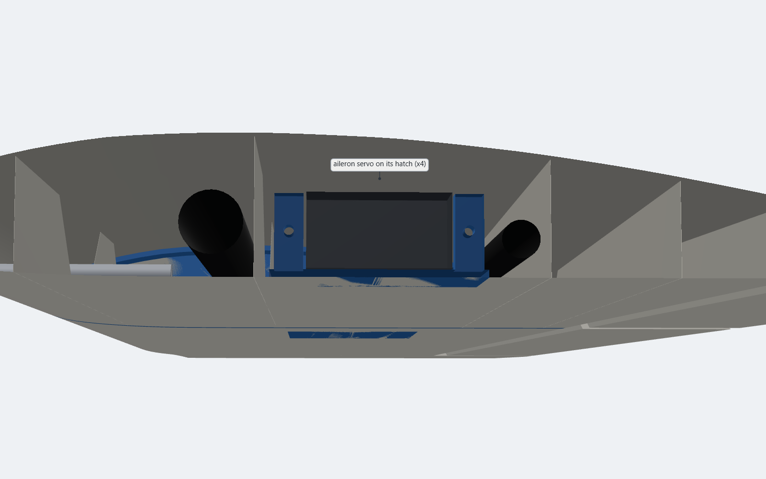
renders/42_cut_through_aileron_hatch.png
