AjayaDahal/vtol-plane/renders/43_wing_tip_fairing_front.png

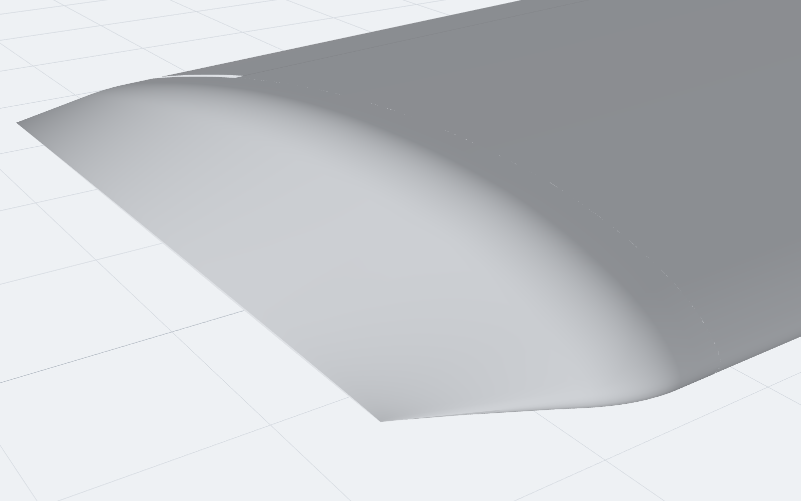
renders/43_wing_tip_fairing_front.png
