AjayaDahal/vtol-plane/renders/44_wing_tip_fairing_rear_below.png

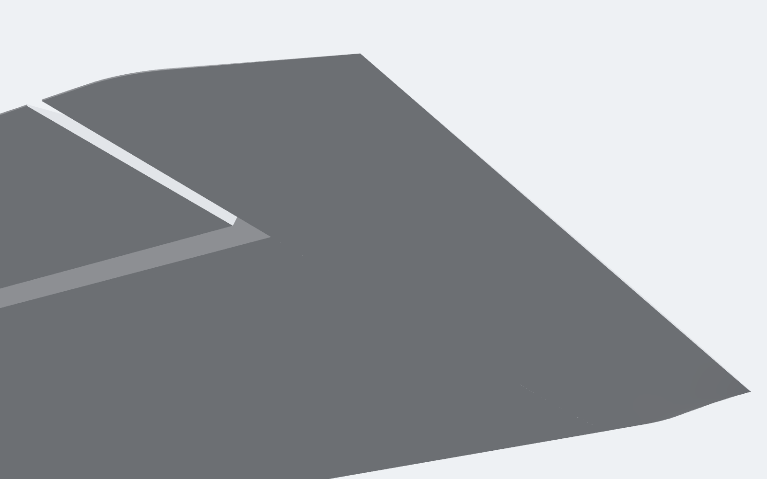
renders/44_wing_tip_fairing_rear_below.png
