AjayaDahal/vtol-plane/renders/45_wing_tip_fairing_reflection_stripes.png

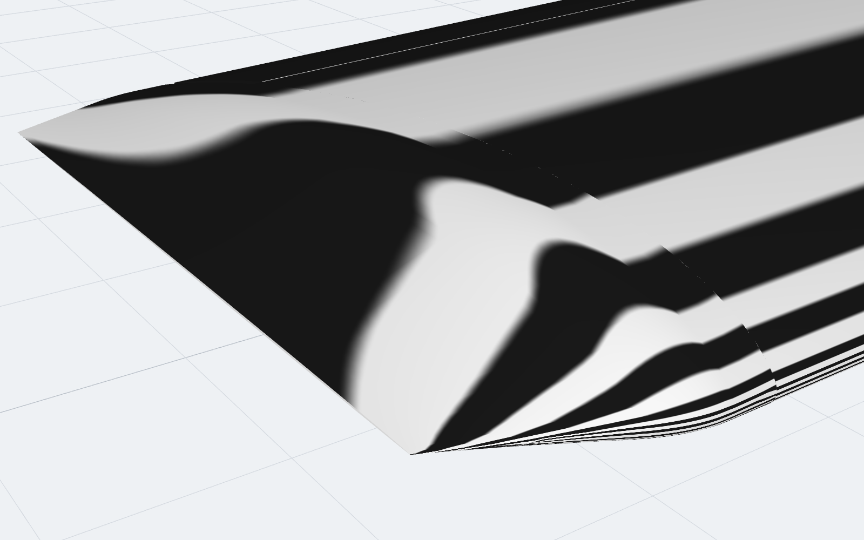
renders/45_wing_tip_fairing_reflection_stripes.png
