AjayaDahal/vtol-plane/renders/46_vtail_tip_fairing.png

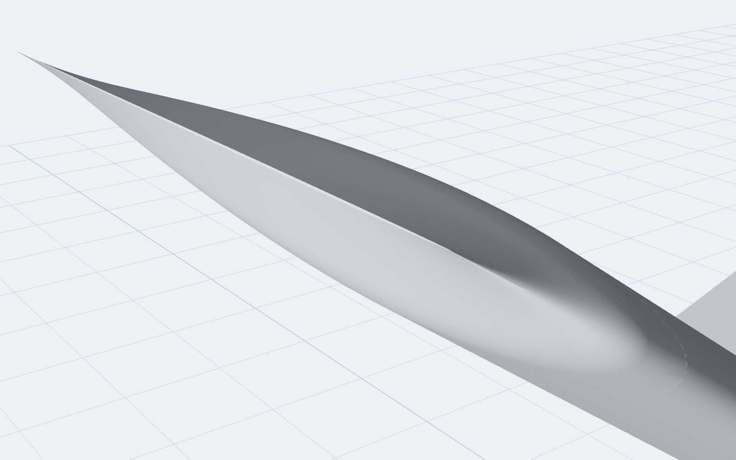
renders/46_vtail_tip_fairing.png
