AjayaDahal/vtol-plane/BOM_3S.csv

Category | Item | Qty | Source | Your part / what to buy | Notes | Price each (USD) | Total (USD) | Link
Propulsion | Motor | 4 | BUY | SunnySky X2814 900KV, standard version (NOT the 1000 or 1100KV) | 3 + 1 spare. 1880 g at 11.0 V on an APC 12x6 (SunnySky's table). Thrust-test one first: it must reach 1.5 kg at 10.6 V. Measure its mounting holes before PETG plates 6-7 are re-made. | 29.99 | 119.96 | https://sunnyskyusa.com/products/sunnysky-x2814-brushless-motors
Propulsion | Propeller, counter-clockwise | 6 | BUY | APC 12x6E (LP12060E) | 2 + 4 spares: front left and rear (counter-clockwise seen from above) | 4.87 | 29.22 | https://www.apcprop.com/product/12x6e/
Propulsion | Propeller, clockwise (reverse rotation) | 3 | BUY | APC 12x6EP (LP12060EP) | 1 + 2 spares: front right (clockwise seen from above). Use the APC adapter ring that fits the motor's prop adapter | 4.87 | 14.61 | https://www.apcprop.com/product/12x6ep/
Propulsion | Prop nut lock | 1 | BUY | Nyloc nut for the prop adapter's thread, or medium thread-lock | front right motor: its rotation tends to undo a right-hand nut
Propulsion | ESC | 4 | HAVE | Your Readytosky 40A 2-4S ESCs (5V/3A BEC) | 3 + 1 spare: confirm you have 4. ~31 A at full throttle per motor on a full pack. PWM only: calibrate in QGC with the props off. Pull the red wire out of each signal plug (the servo rail has its own BEC).
Propulsion | Motor wire | 1 | BUY | Silicone wire 16 AWG, 3 colours, ~5 m | front motor leads extended ~550 mm to the fuselage plugs, rear ~450 mm inside the boom
Propulsion | Bullet connectors | 1 | BUY | 3.5 mm bullet connectors, 6 pairs + spares | the wing motor-lead plugs, reachable through the nose
Power | Main battery | 1 | HAVE | Your Zeee 3S 8000 mAh 100C hard case | 138 x 47 x 36 mm, 493 g: fits the tray and its straps. ~18 min of pure hover (model). Re-terminate EC5 to XT60.
Power | Second battery | 1 | HAVE | Your IPO Power 3S 6200 mAh | measure its size and mass (estimated 150 x 45 x 32 mm, 450 g). ~14 min of pure hover; its stop-pin hole is one forward (x = 370)
Power | XT60 connectors | 2 | BUY | XT60 pairs | re-terminate the Zeee pack (it ships with EC5)
Power | Power module | 1 | HAVE | Your Hex/CubePilot Power Brick Mini | 30 A continuous, 100 A burst; hover draws ~22 A. Plugs straight into the Cube's POWER1. Calibrate voltage and current in QGC against a meter.
Power | ESC power harness | 1 | BUY | 1 x XT60 to 3 ESCs (or make one: 14 AWG wire + XT60) | replaces the PDB: lighter, and fits where the ESC block is
Power | Servo BEC | 1 | BUY | 5-6 V, at least 5 A | powers the servo rail (8 servos incl. two 20 g tilt servos); the Cube does not power it
Power | LiPo charger | 1 | HAVE? | Your charger | confirm it charges 3S packs
Avionics | Flight controller | 1 | HAVE | Your CubePilot Cube Black on the standard carrier | PX4 firmware px4_fmu-v3. The front of fc_shelf steps down 13 mm for it (PLAN_3S.md). Disable its internal compasses.
Avionics | GPS + compass | 1 | HAVE | Your 3DR uBlox LEA-6H + HMC5883L | on the GPS saddle (38 mm puck on the 52 mm pad). GPS only: fine to start; an M10 holds position better later
Avionics | GPS adapter cable | 1 | BUY | DF13 6-pin GPS + 4-pin I2C to JST-GH 8-pin (Cube GPS1) | check the pinout against the Cube carrier before plugging in
Avionics | Airspeed sensor | 1 | BUY | Digital airspeed sensor, MS4525DO class, I2C with a JST-GH lead | PX4 uses airspeed to end the transition
Avionics | Pitot tube and tubing | 1 | BUY | Pitot tube + silicone tubing (often in the sensor kit) | in the right wing tip section at y ~ 505 mm, out of the 12 in props' wash (hand-drilled hole)
Avionics | RC receiver | 1 | BUY | ELRS 2.4 GHz receiver | skip if you already have one for your radio
Avionics | Radio transmitter | 1 | HAVE? | Your ELRS-compatible radio | confirm the model
Servos | Tilt servo | 3 | BUY | Kingmax KM1203MD (12 mm mini, 20 g, ~9 kg-cm, metal gear) | 2 + 1 spare. Pod bay: 24 x 13 mm body, 21 mm deep, tab holes 28 mm apart. Measure before printing plate 7
Servos | Aileron and ruddervator servo | 7 | BUY | 9 g metal-gear servo (MG90S class) | 6 + 1 spare (4 ailerons, 2 ruddervators). Body up to 23 x 12.2 mm, tab holes 28 mm apart
Servos | Servo extension leads | 1 | BUY | 500 mm x2, 600 mm x2, 650 mm x2, 800 mm x2 | mid ailerons, tilt servos, ruddervators (through the boom), tip ailerons
Servos | Pushrods | 6 | BUY | 1.2 mm steel, with snap clevis or EZ connector | ailerons and ruddervators
Airframe | Carbon tube 10 x 8 mm (main spar) | 2 | BUY | 650 mm each | sand and epoxy into every rib
Airframe | Carbon tube 6 x 4 mm (rear spar) | 2 | BUY | 650 mm each
Airframe | Carbon tube 8 x 6 mm (main joiner) | 1 | BUY | 420 mm | slides 150 mm into both main spars
Airframe | Carbon rod 4 mm | 1 | BUY | 360 mm or longer | rear joiner (320 mm) and the two V-tail pins (20 mm each)
Airframe | Carbon tube 16 x 14 mm (tail boom) | 1 | BUY | 630 mm | the motor and servo wires run inside it
Airframe | Carbon rod 3 mm (battery stop pin) | 1 | BUY | 25 mm
Airframe | Flanged bearing | 2 | BUY | F693ZZ, 3 x 8 x 4 mm | one per tilt yoke
Airframe | M3 shim washer | 4 | BUY | 0.5 mm thick, OD up to 5 mm | 2 + spares: between each bearing and its axle boss (without it the yoke binds)
Airframe | M3 heat-set insert | 4 | BUY | M3 | 2 tilt axles, 1 nose screw, 1 spare
Airframe | M3 x 12 socket screw + washer | 2 | BUY |  | tilt axles
Airframe | M3 x 35 bolt + nyloc nut | 4 | BUY |  | boom pods to the boom-rib tongues (with epoxy)
Airframe | Motor screws | 12 | BUY | M3, long enough for a 4 mm plate plus the X2814's thread | check by hand that none touches the windings; the screws that come with the motor may do
Airframe | M3 x 16 bolt + nut + washer | 2 | BUY |  | rear motor clamp
Airframe | M3 x 12 nylon screw + 12 mm nylon washer | 2 | BUY |  | 1 + spare: holds the removable nose (a nylon thumb screw makes battery changes tool-free)
Airframe | M2.5 nylon screw or pin | 2 | BUY |  | locks each rear spar to the rear joiner
Airframe | M2 x 6 screw | 16 | BUY |  | 12 + spares: two per servo hatch
Airframe | M2 x 6 self-tapping screw | 4 | BUY |  | two per tilt yoke, into the servo's disc horn
Airframe | Hinge tape | 1 | BUY | Blenderm or similar, 1 roll | top-surface hinges
Airframe | Velcro one-wrap strap, 20 mm | 1 | BUY | 2 x 300 mm + 2 x 200 mm | the battery (thread it through the tray before gluing the tray in) and the ESC block
Airframe | Epoxy and CA | 1 | BUY | 30 min epoxy + microballoons, CA | epoxy for every carbon bond
Airframe | Foam | 1 | BUY | 3 mm foam sheet, 1 mm double-sided foam tape | between the ESCs, under the Cube and the GPS
Airframe | EVA foam strip | 1 | BUY | 5-10 mm thick, ~250 x 40 mm | belly landing pad
Airframe | Heat shrink / braid | 1 | BUY |  | wherever wires cross carbon (carbon conducts)
Airframe | Fish tape and pull cord | 1 | BUY | 1 mm stiff wire ~1 m, thin nylon cord ~1 m | pull the leads through the boom; lay the GPS cable through fuse_3
Airframe | Nylon mesh (optional) | 1 | BUY | scrap | inside the nose-tip air inlet
Filament | LW-PLA, ACTIVE-FOAMING, 1.75 mm | 1 | BUY | SainSmart LW-PLA (active foaming), White, 1 kg | the Kobra X prints every skin: 266 g, plus the test prints and reprints. Free delivery on Amazon, no Prime needed. Foams above 210 C, down to 0.54 g/cm3. Cheaper: Bambu Lab PLA Aero, 1 kg, white or grey, $26.99 at us.store.bambulab.com ($6.99 shipping under $59; with the PETG in the same order both cost ~$48 delivered). NOT pre-foamed LW-PLA (Polymaker PolyLite LW-PLA, SUNLU LW-PLA, Overture Air PLA): these files would under-extrude it. Light colour: LW-PLA softens at 55-60 C and dark skins get that hot in summer sun | 47.49 | 47.49 | https://www.amazon.com/dp/B0B1PS6MMP
Filament | PETG, 1.75 mm | 1 | BUY | any brand, 1 kg spool | the Kobra S1 prints every PETG part as 7 plates: 464 g. Normal PETG, not a foaming PETG
Printed | LW-PLA skins | 22 | PRINT | 21 files on the Kobra X (22 prints) | 266 g, ~49 h: wings, ailerons, tip fairings, fuselage, V-tail, ruddervators (tracker.md)
Printed | PETG parts | 53 | PRINT | 7 plates on the Kobra S1 | 464 g, ~16 h. Hold plates 6 and 7 until the 3S changes are built in (PLAN_3S.md)
Tools | Watt meter, XT60 inline | 1 | BUY |  | for the motor thrust test and current checks; skip if you have one
Tools | Kitchen scale and luggage scale | 1 | HAVE? |  | motor thrust test (kitchen scale) and yoke load test (4.5 kg pull)
Tools | Soldering iron with a heat-set insert tip | 1 | HAVE? |  | inserts, motor leads, XT60s
Tools | 3D printers | 2 | HAVE | Your Anycubic Kobra X and Kobra S1 | X: every LW-PLA skin; S1: all the PETG
Your parts not used | Flight controller (spare) | 1 | SPARE | Your cased Pixhawk 1 | use only if QGC shows 2 MB of flash (then it runs fmu-v3); it fits the shelf; DF13 plugs
Your parts not used | Flight controller board | 1 | NOT USED | Your bare YKRC PX4FMU v2.4.8
Your parts not used | Motors | 2 | NOT USED | Your Readytosky RS2212 920KV | about 1 kg at most each: too weak for this plane on 3S
Your parts not used | Motor | 1 | NOT USED | Your 4108 380KV | made for 15 in props on 4-6S; a 15 in prop does not fit
Your parts not used | Power distribution board | 1 | NOT USED | Your blue multirotor PDB | a 1-to-3 harness is lighter and fits where the ESC block is
Not needed for 3S | 4S design items | 0 | DO NOT BUY | Emax ECOII 2807 1700KV motors, 50 A DShot ESCs, Pixhawk 6C, 4S 5000 mAh pack, M10 GPS, PM02, 7x4.5 props | BOM.md lists them for the 4S design; the 3S build uses the motors above and your parts
Total | Priced rows only |  |  | motors, props, LW-PLA | the other BUY rows are not priced here: check prices when ordering |  | 211.28
