AjayaDahal/vtol-plane/3mf/complete_project_kobra_s1_petg.3mf

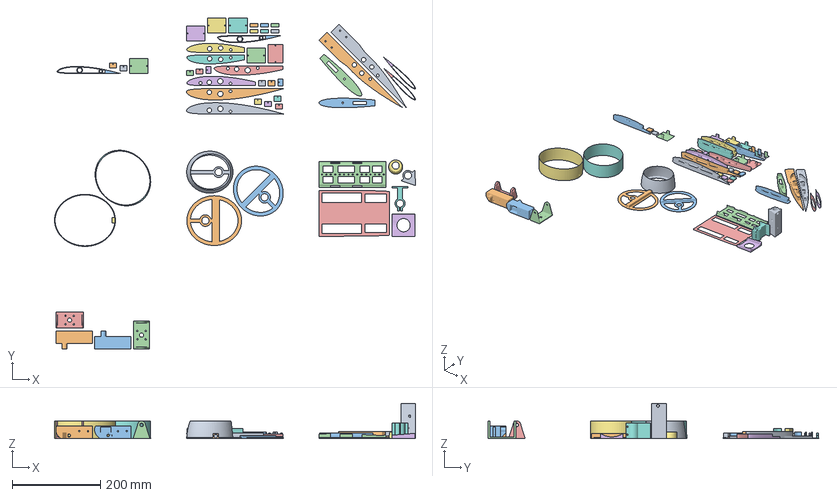
[picture p57: CAD file, 2026-11-04]
3mf/complete_project_kobra_s1_petg.3mf
818.7 x 750.7 x 80.0 mm
hatch_block_1.stl x 2
hatch_block_2.stl x 2
rib_tip_r.stl
servo_hatch.stl
boom_cup_l.stl
boom_cup_r.stl
control_horn_1.stl
control_horn_2.stl
control_horn_3.stl
control_horn_4.stl
control_horn_5.stl
control_horn_6.stl
hatch_block_3.stl
hatch_block_4.stl
hatch_block_5.stl
hatch_block_6.stl
hatch_block_7.stl
hatch_block_8.stl
hatch_block_9.stl
hatch_block_10.stl
rib_midtip_l.stl
rib_midtip_r.stl
rib_root_l.stl
rib_root_r.stl
rib_tip_l.stl
servo_hatch_1.stl
servo_hatch_2.stl
servo_hatch_3.stl
servo_hatch_4.stl
servo_hatch_5.stl
boom_rib_l.stl
boom_rib_r.stl
vtail_root_rib_1.stl
vtail_root_rib_2.stl
vtail_tip_cap_1.stl
vtail_tip_cap_2.stl
coupler_240.stl
coupler_370.stl
coupler_610.stl
frame_main.stl
frame_rear.stl
battery_tray.stl
fc_shelf.stl
gps_mount.stl
pod_collar.stl
rear_motor_mount.stl
tail_block.stl
boom_pod_l.stl
boom_pod_r.stl
yoke_l.stl
yoke_r.stl
