AjayaDahal/vtol-plane/3mf/complete_project_kobra_x_lwpla.3mf

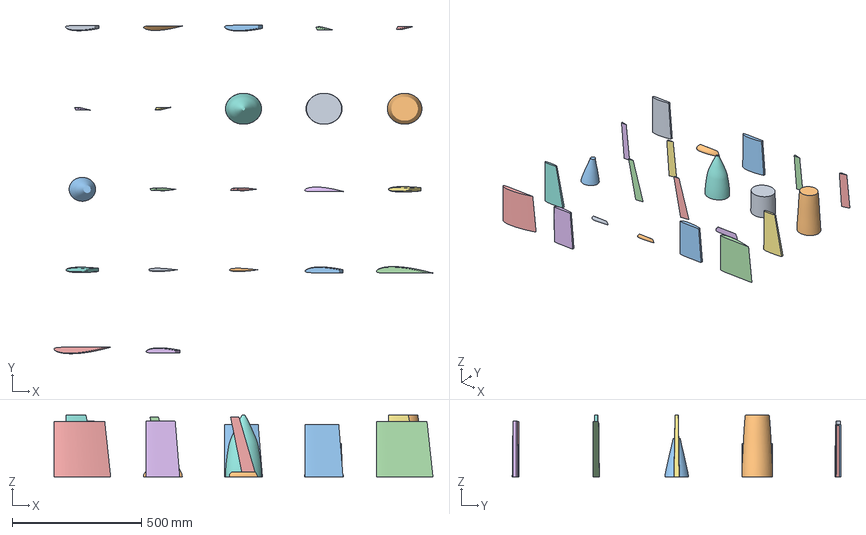
[picture p58: CAD file, 2026-11-04]
3mf/complete_project_kobra_x_lwpla.3mf
1467.7 x 1272.3 x 240.0 mm
wing_tip_r.stl
tip_fairing_r.stl
wing_mid_r.stl
aileron_mid_l.stl
aileron_mid_r.stl
aileron_tip_l.stl
aileron_tip_r.stl
fuse_1.stl
fuse_2.stl
fuse_3.stl
fuse_4.stl
ruddervator_l.stl
ruddervator_r.stl
tip_fairing_l.stl
vtail_l.stl
vtail_r.stl
vtail_tip_fairing.stl x 2
wing_mid_l.stl
wing_root_l.stl
wing_root_r.stl
wing_tip_l.stl
