AjayaDahal/vtol-plane/3mf/s1_petg/frame_main.3mf

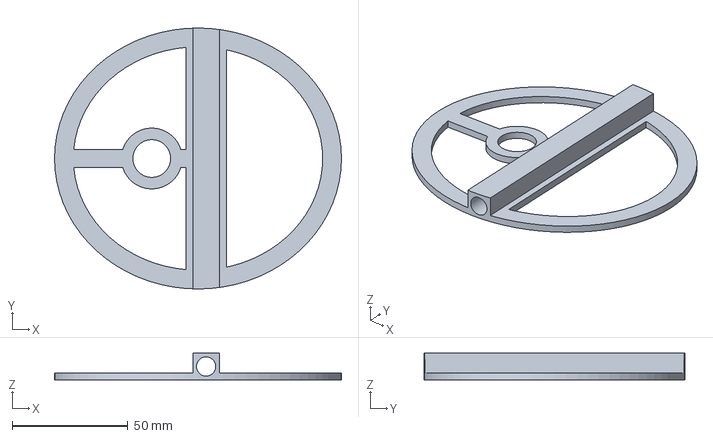
[picture p59: CAD file, 2026-11-04]
3mf/s1_petg/frame_main.3mf
124.2 x 112.9 x 11.5 mm
