AjayaDahal/vtol-plane/3mf/s1_petg/rib_root_r.3mf

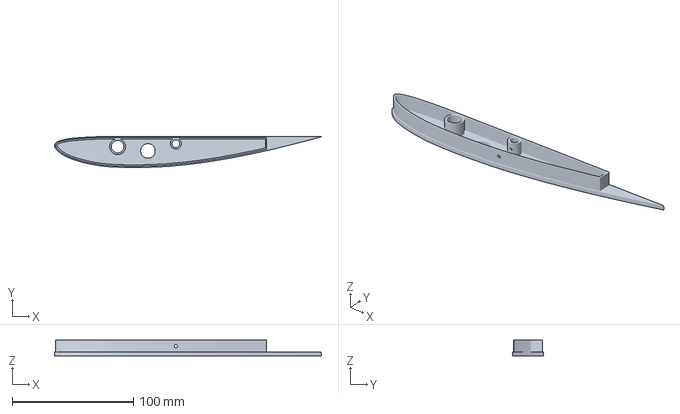
[picture p60: CAD file, 2026-11-04]
3mf/s1_petg/rib_root_r.3mf
220.0 x 25.7 x 13.0 mm
