AjayaDahal/vtol-plane/3mf/s1_petg_plates/petg_3_boom_vtail_ribs.3mf

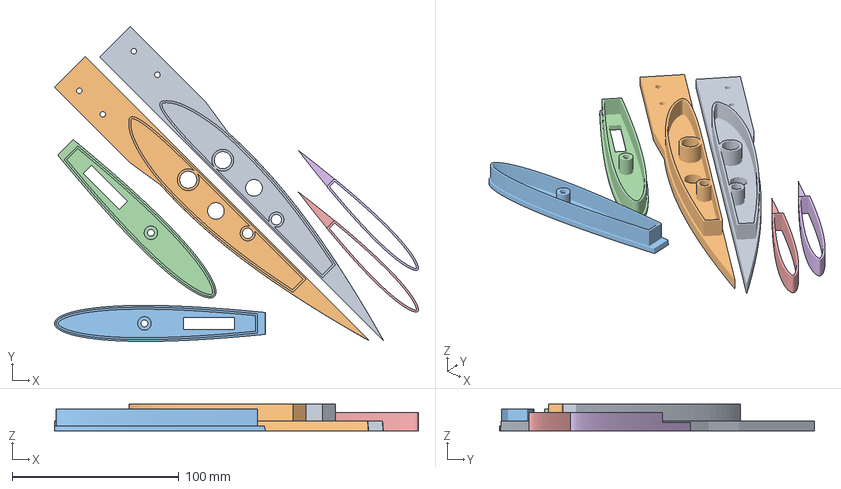
[picture p61: CAD file, 2026-11-04]
3mf/s1_petg_plates/petg_3_boom_vtail_ribs.3mf
218.5 x 189.1 x 16.0 mm
boom_rib_l.stl
boom_rib_r.stl
vtail_root_rib_1.stl
vtail_root_rib_2.stl
vtail_tip_cap_1.stl
vtail_tip_cap_2.stl
