AjayaDahal/vtol-plane/3mf/x_lwpla/tip_fairing_r.3mf

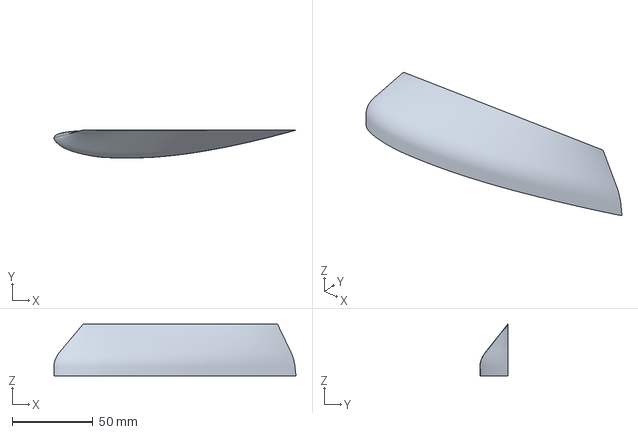
[picture p62: CAD file, 2026-11-04]
3mf/x_lwpla/tip_fairing_r.3mf
150.3 x 17.6 x 32.0 mm
