AjayaDahal/vtol-plane/parts/assembly/rib_midtip_r.stl

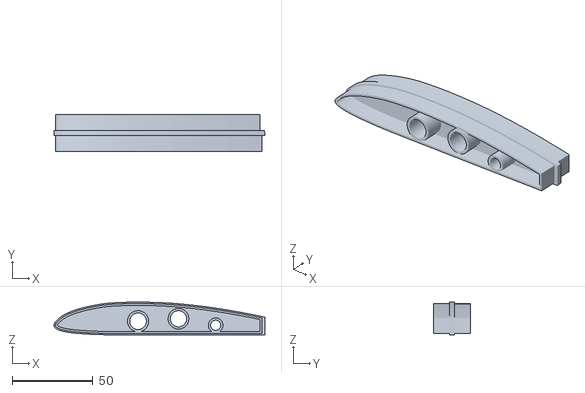
[picture p63: CAD file, 2026-11-04]
parts/assembly/rib_midtip_r.stl
130.5 x 23.0 x 20.4
