AjayaDahal/vtol-plane/renders/vtol_plane.stl

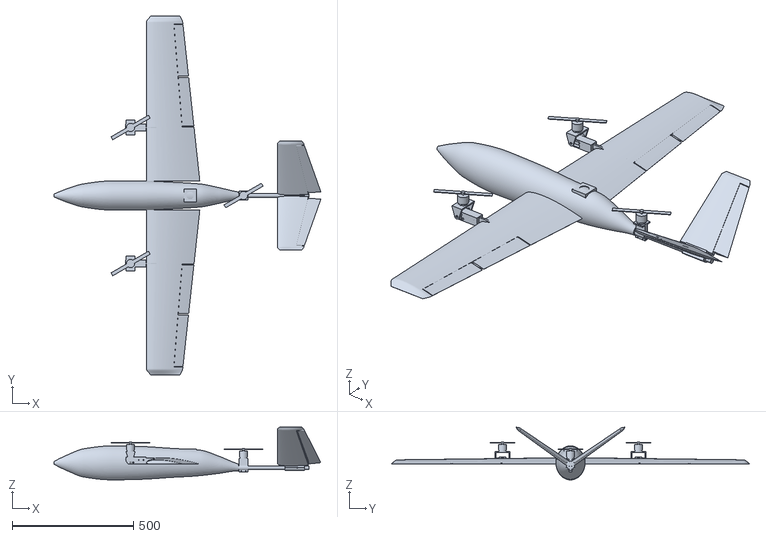
[picture p64: CAD file, 2026-11-04]
renders/vtol_plane.stl
1098.5 x 1478.0 x 217.2
