AjayaDahal/vtol-plane/sim/models/vtol_plane/meshes/aileron_tip_r_lwpla.stl

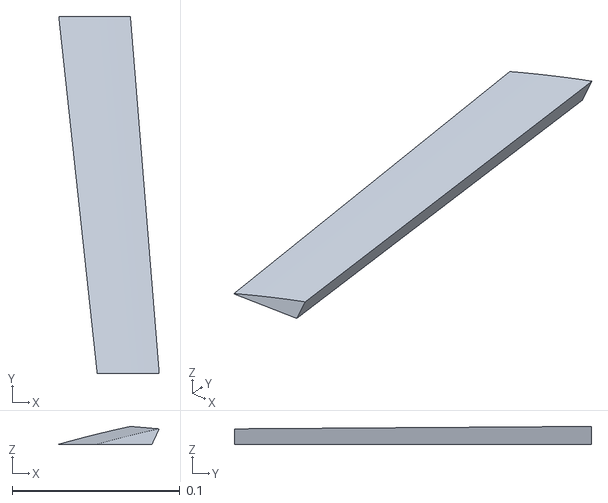
[picture p65: CAD file, 2026-11-05]
sim/models/vtol_plane/meshes/aileron_tip_r_lwpla.stl
0.06 x 0.213 x 0.0108
