AjayaDahal/vtol-plane/3mf/s1_petg/hatch_block.3mf

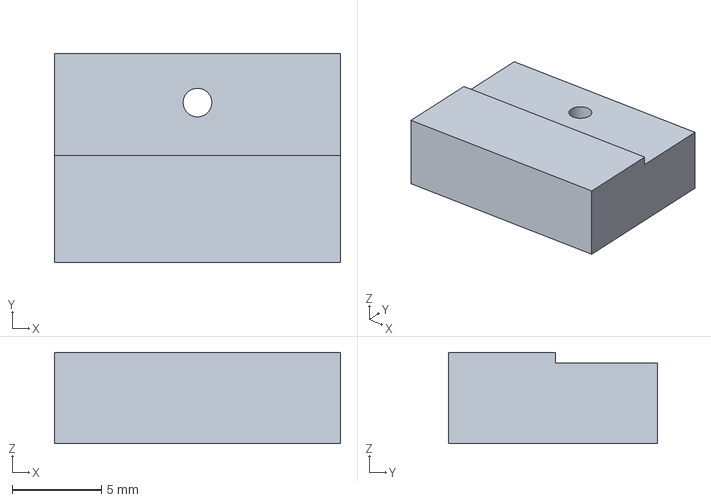
[picture p66: CAD file, 2026-11-04]
3mf/s1_petg/hatch_block.3mf
16.0 x 11.7 x 5.10 mm
