AjayaDahal/vtol-plane/3mf/s1_petg_plates/petg_1_fit_tests.3mf

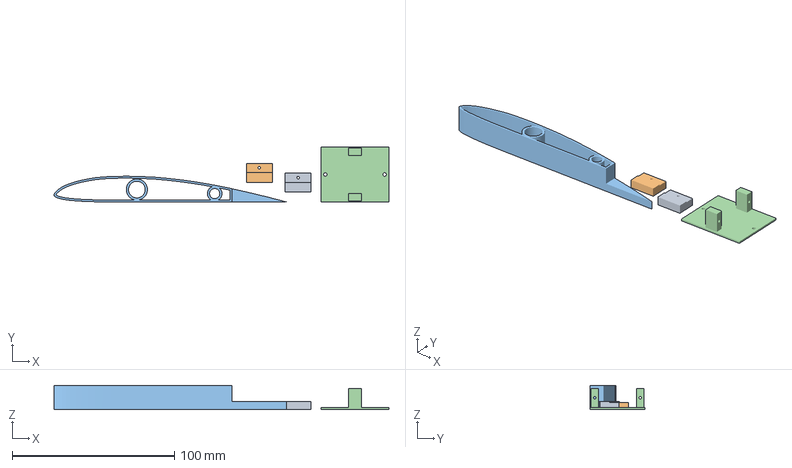
[picture p67: CAD file, 2026-11-04]
3mf/s1_petg_plates/petg_1_fit_tests.3mf
206.6 x 34.0 x 15.0 mm
hatch_block_1.stl
hatch_block_2.stl
rib_tip_r.stl
servo_hatch.stl
