AjayaDahal/vtol-plane/3mf/x_lwpla/fuse_4.3mf

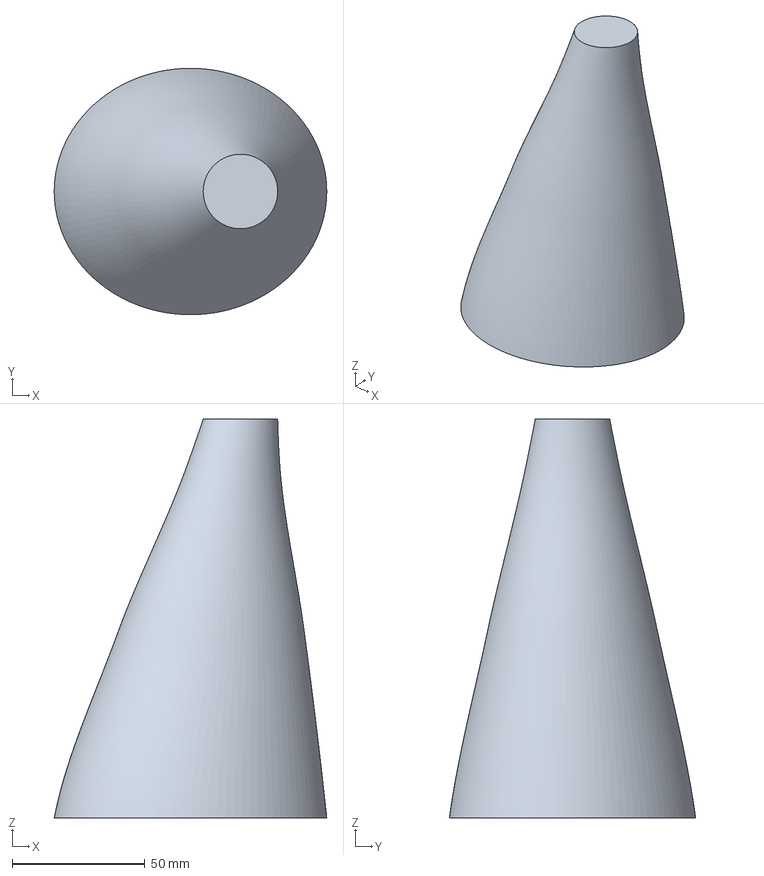
[picture p68: CAD file, 2026-11-04]
3mf/x_lwpla/fuse_4.3mf
102.5 x 92.6 x 150.0 mm
