AjayaDahal/vtol-plane/sim/models/vtol_plane/meshes/rotor_0_prop.stl

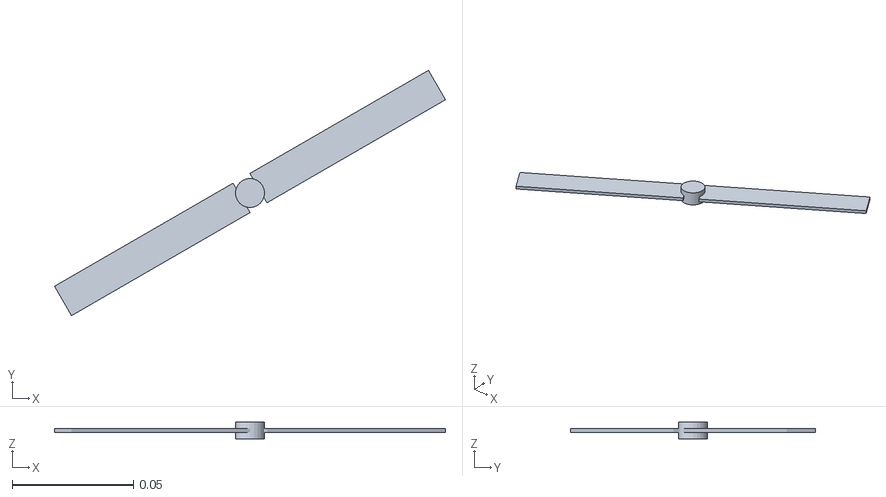
[picture p69: CAD file, 2026-11-05]
sim/models/vtol_plane/meshes/rotor_0_prop.stl
0.161 x 0.101 x 0.007
