AjayaDahal/vtol-plane/3mf/s1_petg/vtail_root_rib.3mf

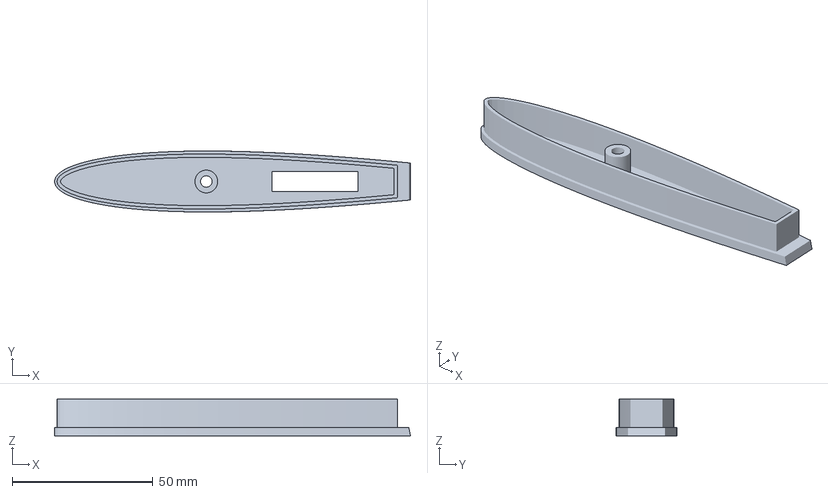
[picture p70: CAD file, 2026-11-04]
3mf/s1_petg/vtail_root_rib.3mf
126.6 x 21.7 x 13.0 mm
