AjayaDahal/vtol-plane/3mf/s1_petg_plates/petg_5_fuselage_frames.3mf

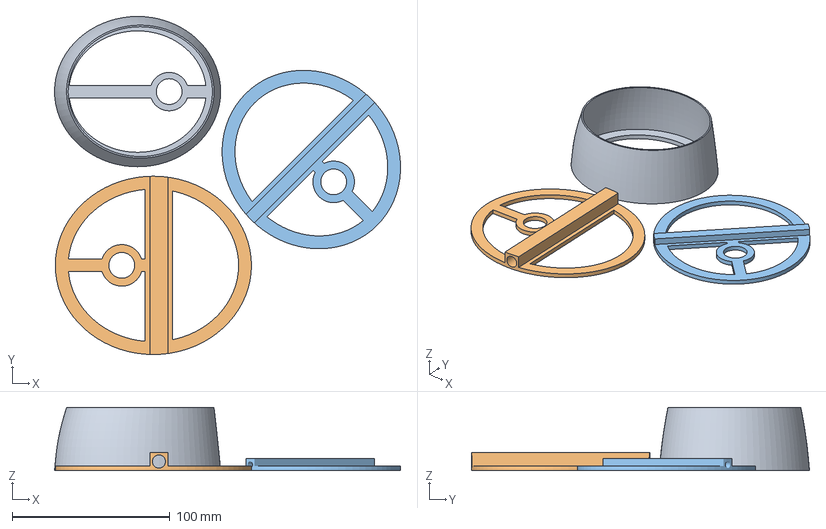
[picture p71: CAD file, 2026-11-04]
3mf/s1_petg_plates/petg_5_fuselage_frames.3mf
219.0 x 214.0 x 40.0 mm
coupler_610.stl
frame_main.stl
frame_rear.stl
