AjayaDahal/vtol-plane/3mf/x_lwpla/aileron_mid_r.3mf

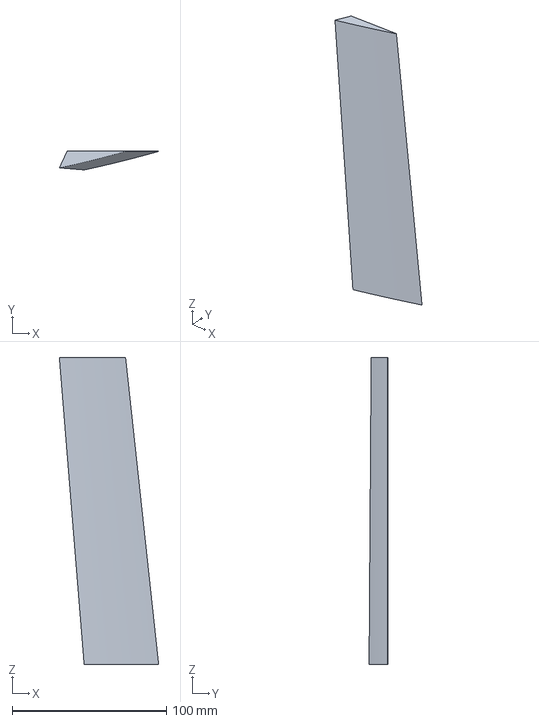
[picture p72: CAD file, 2026-11-04]
3mf/x_lwpla/aileron_mid_r.3mf
64.4 x 12.2 x 199.0 mm
