AjayaDahal/vtol-plane/parts/assembly/vtail_tip_cap_l.stl

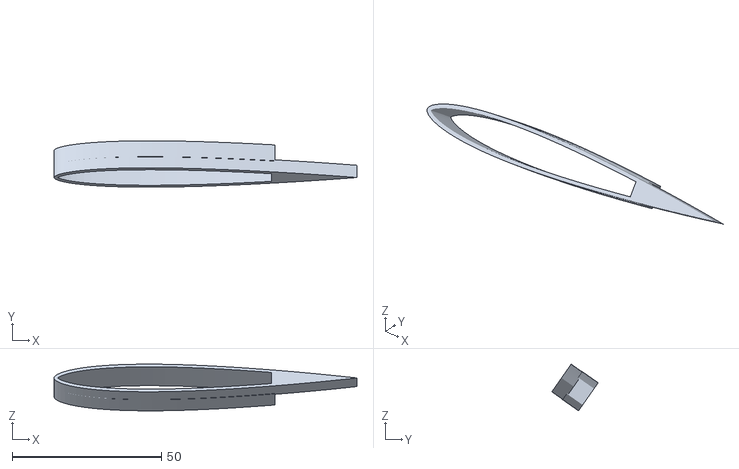
[picture p73: CAD file, 2026-11-02]
parts/assembly/vtail_tip_cap_l.stl
101.6 x 15.6 x 15.7
