AjayaDahal/vtol-plane/sim/models/vtol_plane/meshes/ruddervator_r_lwpla.stl

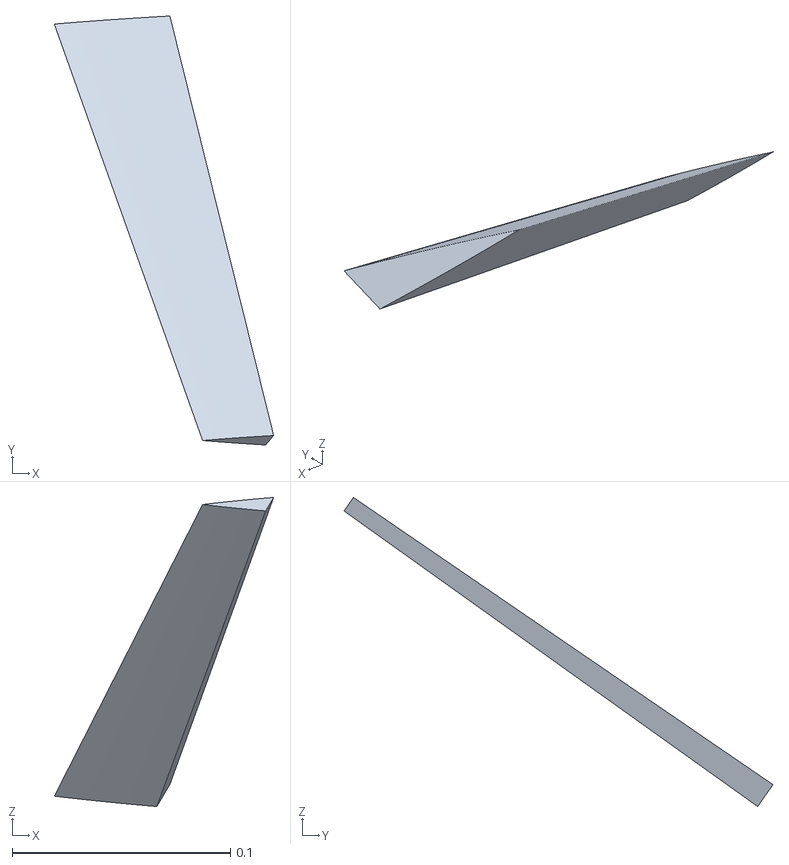
[picture p74: CAD file, 2026-11-05]
sim/models/vtol_plane/meshes/ruddervator_r_lwpla.stl
0.101 x 0.197 x 0.142
