AjayaDahal/vtol-plane/3mf/s1_petg_plates/petg_6_fuselage_tail.3mf

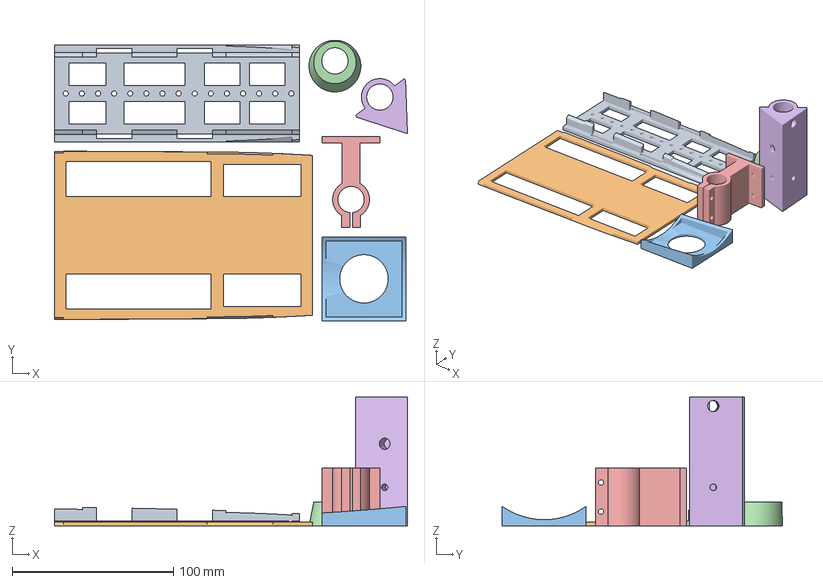
[picture p75: CAD file, 2026-11-04]
3mf/s1_petg_plates/petg_6_fuselage_tail.3mf
219.0 x 174.1 x 80.0 mm
battery_tray.stl
fc_shelf.stl
gps_mount.stl
pod_collar.stl
rear_motor_mount.stl
tail_block.stl
