AjayaDahal/vtol-plane/parts/assembly/rib_tip_r.stl

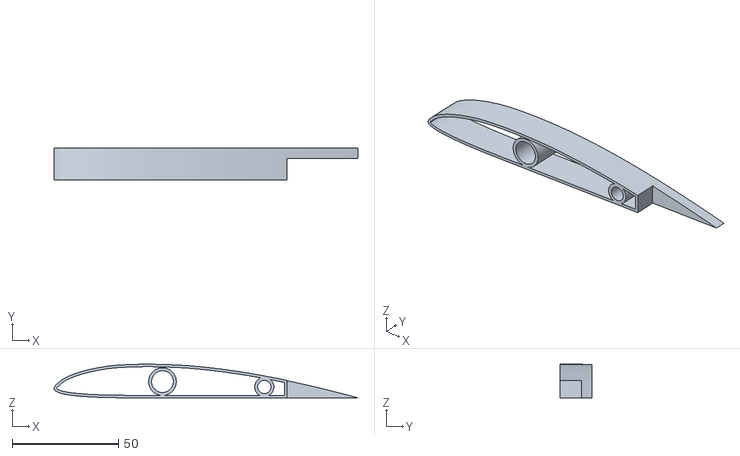
[picture p76: CAD file, 2026-11-02]
parts/assembly/rib_tip_r.stl
143.3 x 15.0 x 15.9
