AjayaDahal/vtol-plane/parts/print_ready/ruddervator_l.stl

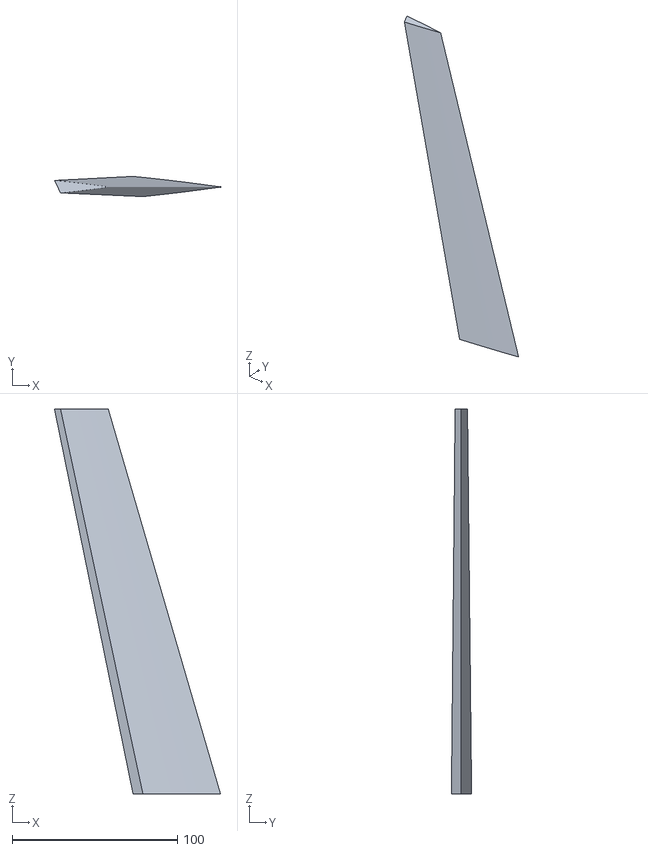
[picture p77: CAD file, 2026-11-02]
parts/print_ready/ruddervator_l.stl
100.5 x 12.2 x 233.0
