AjayaDahal/vtol-plane/sim/models/vtol_plane/meshes/tilt_r_motor.stl

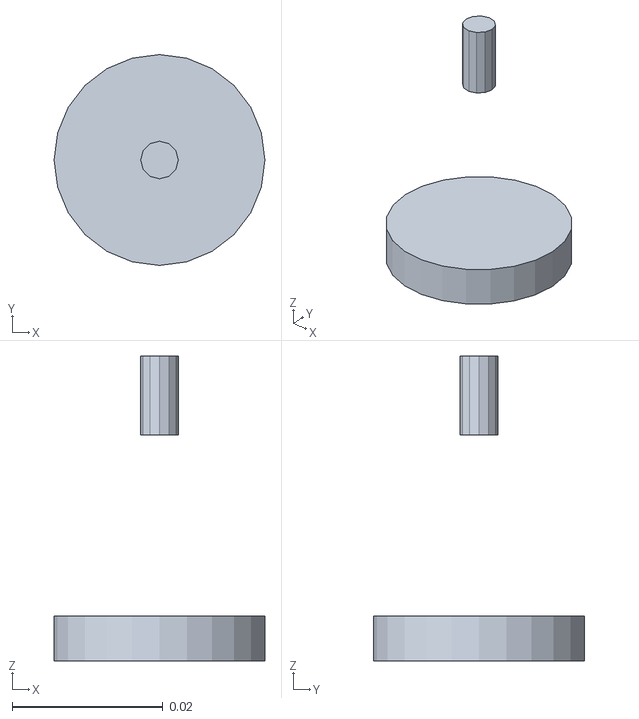
[picture p78: CAD file, 2026-11-05]
sim/models/vtol_plane/meshes/tilt_r_motor.stl
0.028 x 0.028 x 0.0405
