AjayaDahal/vtol-plane/3mf/s1_petg/yoke_l.3mf

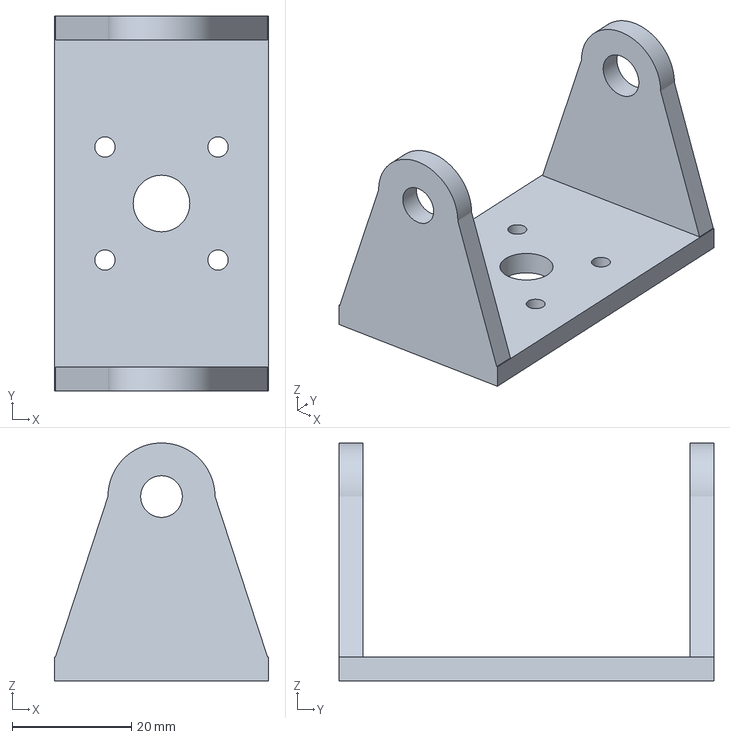
[picture p79: CAD file, 2026-11-04]
3mf/s1_petg/yoke_l.3mf
36.0 x 63.0 x 40.0 mm
