AjayaDahal/vtol-plane/3mf/s1_petg_plates/petg_2_wing.3mf

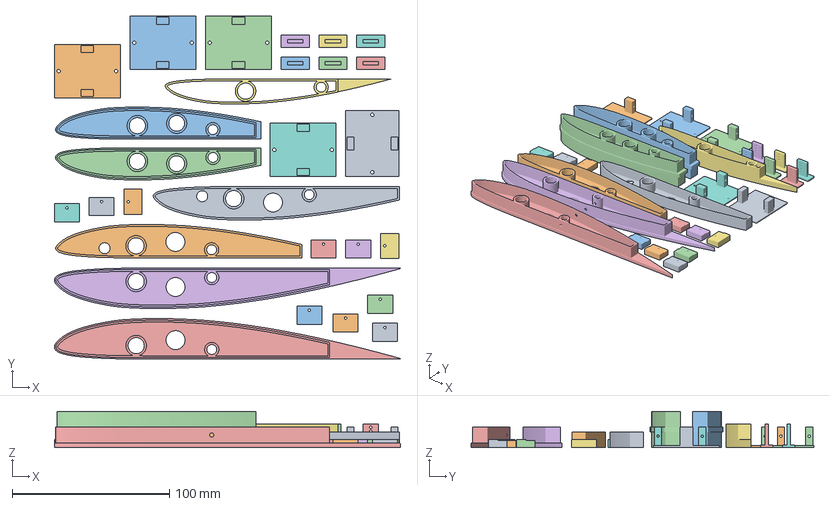
[picture p80: CAD file, 2026-11-04]
3mf/s1_petg_plates/petg_2_wing.3mf
220.0 x 217.9 x 23.0 mm
boom_cup_l.stl
boom_cup_r.stl
control_horn_1.stl
control_horn_2.stl
control_horn_3.stl
control_horn_4.stl
control_horn_5.stl
control_horn_6.stl
hatch_block_1.stl
hatch_block_2.stl
hatch_block_3.stl
hatch_block_4.stl
hatch_block_5.stl
hatch_block_6.stl
hatch_block_7.stl
hatch_block_8.stl
hatch_block_9.stl
hatch_block_10.stl
rib_midtip_l.stl
rib_midtip_r.stl
rib_root_l.stl
rib_root_r.stl
rib_tip_l.stl
servo_hatch_1.stl
servo_hatch_2.stl
servo_hatch_3.stl
servo_hatch_4.stl
servo_hatch_5.stl
