AjayaDahal/vtol-plane/3mf/x_lwpla/aileron_tip_r.3mf

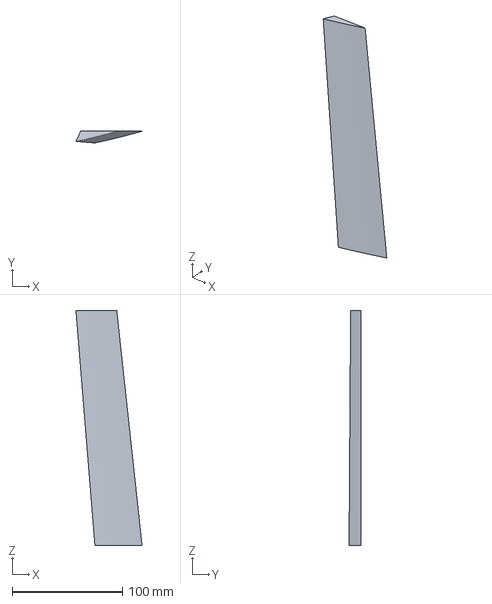
[picture p81: CAD file, 2026-11-04]
3mf/x_lwpla/aileron_tip_r.3mf
60.0 x 10.8 x 213.0 mm
