AjayaDahal/vtol-plane/parts/assembly/ruddervator_l.stl

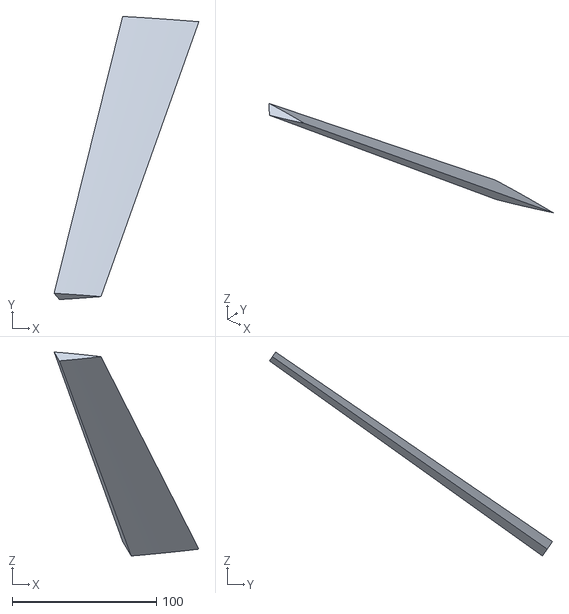
[picture p82: CAD file, 2026-11-02]
parts/assembly/ruddervator_l.stl
100.5 x 196.6 x 141.7
