AjayaDahal/vtol-plane/sim/models/vtol_plane/meshes/tilt_l_bell.stl

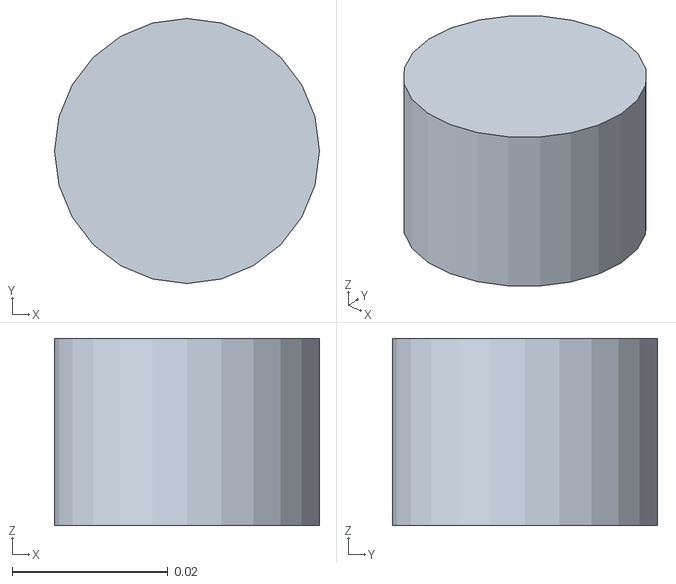
[picture p83: CAD file, 2026-11-05]
sim/models/vtol_plane/meshes/tilt_l_bell.stl
0.034 x 0.034 x 0.024
