AjayaDahal/vtol-plane/3mf/s1_petg/frame_rear.3mf

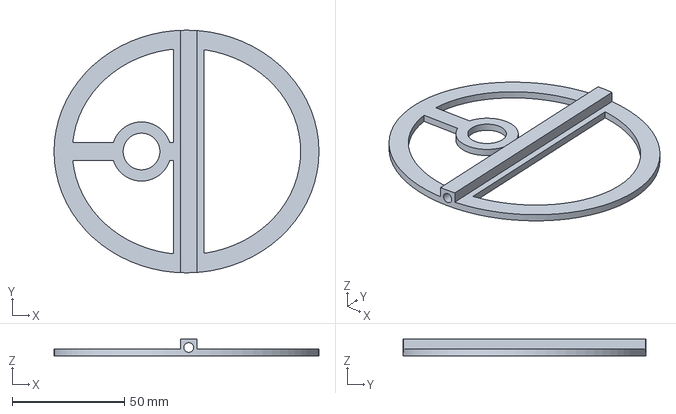
[picture p84: CAD file, 2026-11-04]
3mf/s1_petg/frame_rear.3mf
117.8 x 107.9 x 7.50 mm
