AjayaDahal/vtol-plane/3mf/s1_petg_plates/petg_4_fuselage_rings.3mf

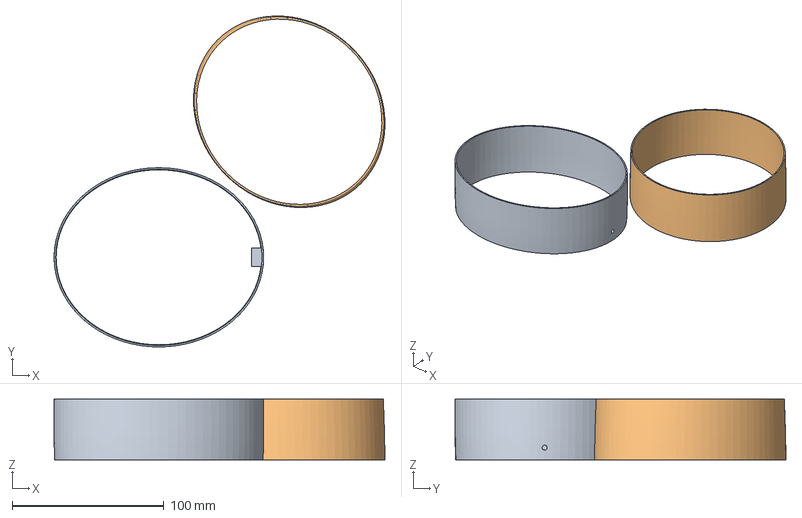
[picture p85: CAD file, 2026-11-04]
3mf/s1_petg_plates/petg_4_fuselage_rings.3mf
218.3 x 218.3 x 40.0 mm
coupler_240.stl
coupler_370.stl
