AjayaDahal/vtol-plane/3mf/x_lwpla/fuse_3.3mf

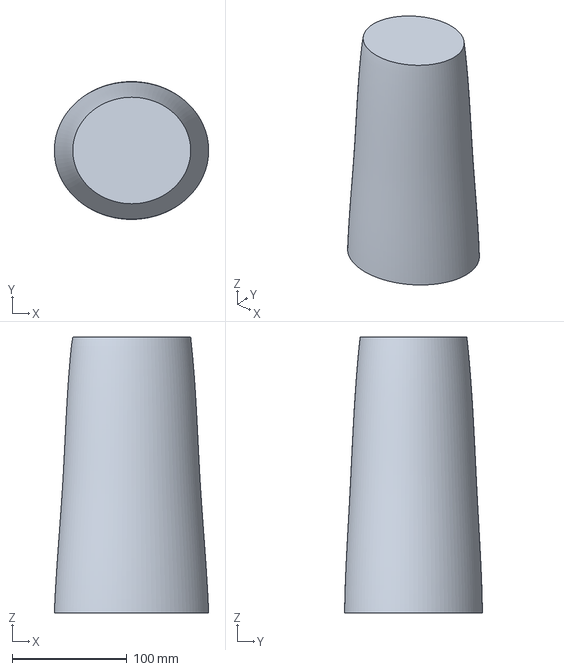
[picture p86: CAD file, 2026-11-04]
3mf/x_lwpla/fuse_3.3mf
134.3 x 119.9 x 240.0 mm
