AjayaDahal/vtol-plane/parts/assembly/vtail_tip_fairing_r.stl

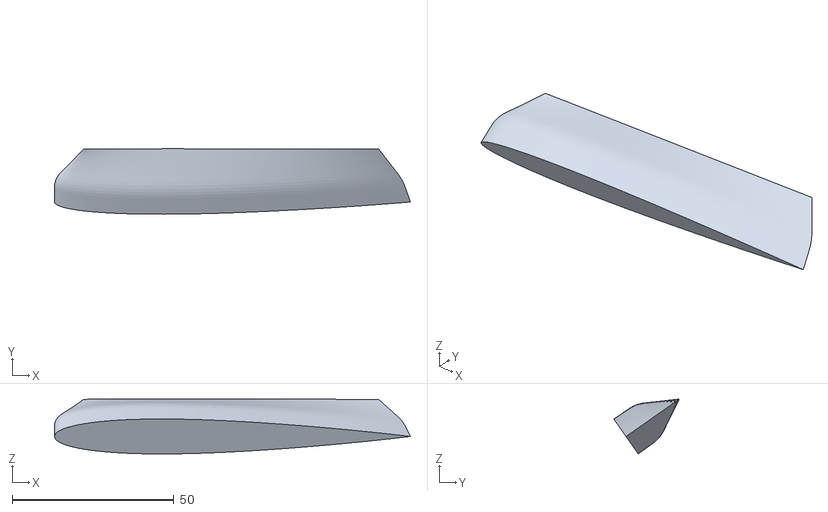
[picture p87: CAD file, 2026-11-02]
parts/assembly/vtail_tip_fairing_r.stl
110.0 x 20.2 x 17.0
