AjayaDahal/vtol-plane/parts/print_ready/rear_motor_mount.stl

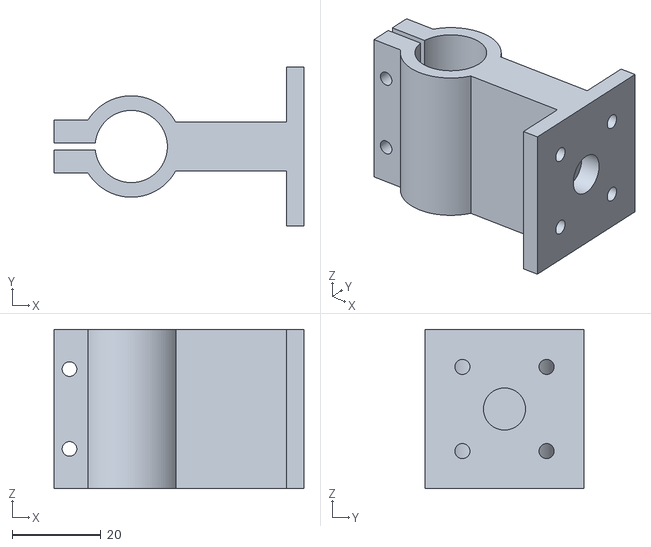
[picture p88: CAD file, 2026-11-02]
parts/print_ready/rear_motor_mount.stl
56.5 x 36.0 x 36.0
