AjayaDahal/vtol-plane/3mf/s1_petg/coupler_370.3mf

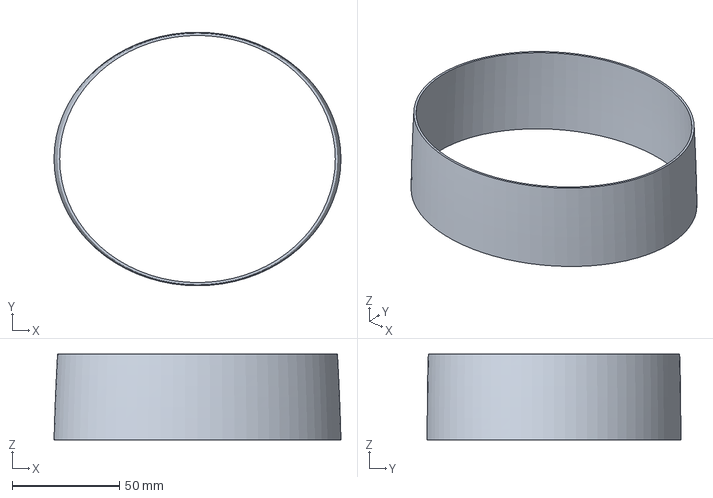
[picture p89: CAD file, 2026-11-04]
3mf/s1_petg/coupler_370.3mf
133.9 x 118.3 x 40.0 mm
