AjayaDahal/vtol-plane/3mf/s1_petg_plates/petg_7_pods_yokes.3mf

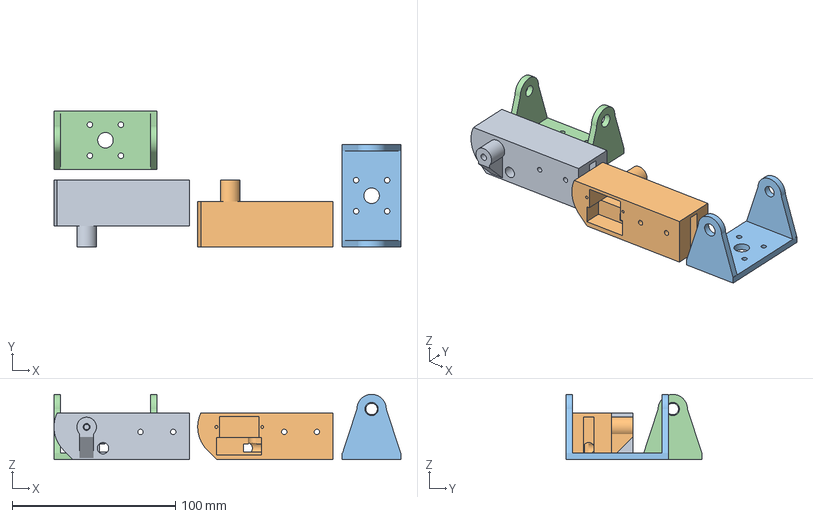
[picture p90: CAD file, 2026-11-04]
3mf/s1_petg_plates/petg_7_pods_yokes.3mf
212.5 x 83.5 x 40.0 mm
boom_pod_l.stl
boom_pod_r.stl
yoke_l.stl
yoke_r.stl
