AjayaDahal/vtol-plane/parts/print_ready/vtail_tip_cap.stl

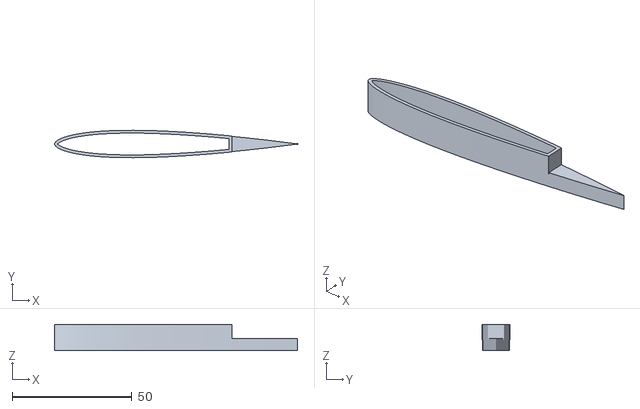
[picture p91: CAD file, 2026-11-02]
parts/print_ready/vtail_tip_cap.stl
101.6 x 11.5 x 11.0
