AjayaDahal/vtol-plane/sim/models/vtol_plane/meshes/base_link_petg.stl

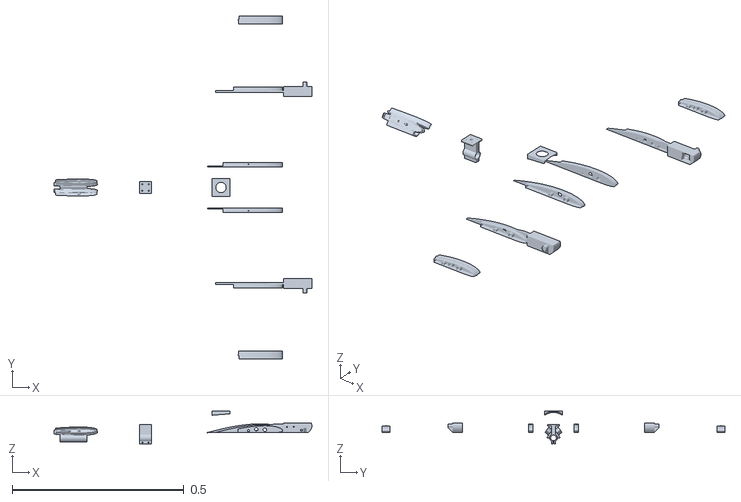
[picture p92: CAD file, 2026-11-05]
sim/models/vtol_plane/meshes/base_link_petg.stl
0.752 x 1.00 x 0.0953
