AjayaDahal/vtol-plane/3mf/s1_petg/fc_shelf.3mf

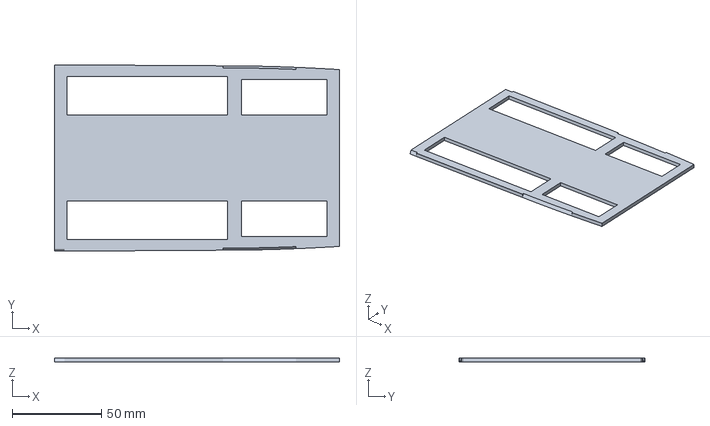
[picture p93: CAD file, 2026-11-04]
3mf/s1_petg/fc_shelf.3mf
160.0 x 104.4 x 2.50 mm
