AjayaDahal/vtol-plane/sim/models/vtol_plane/meshes/base_link_lwpla.stl

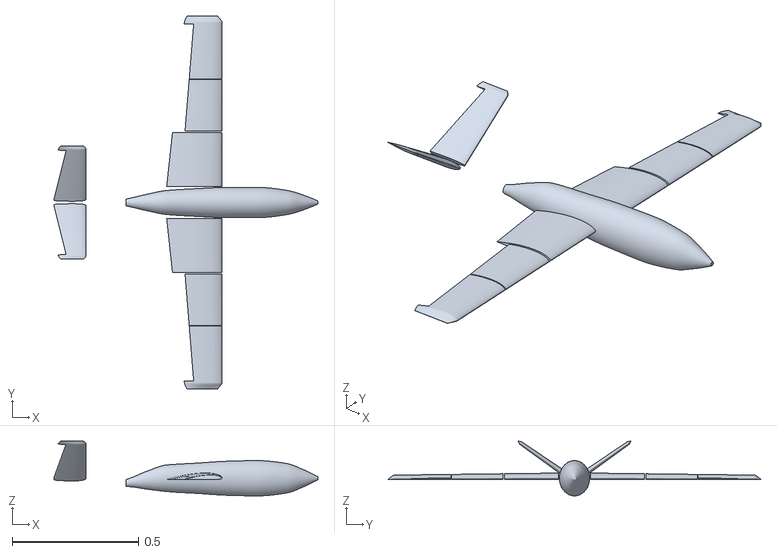
[picture p94: CAD file, 2026-11-05]
sim/models/vtol_plane/meshes/base_link_lwpla.stl
1.05 x 1.48 x 0.217
