AjayaDahal/vtol-plane/3mf/s1_petg/boom_rib_l.3mf

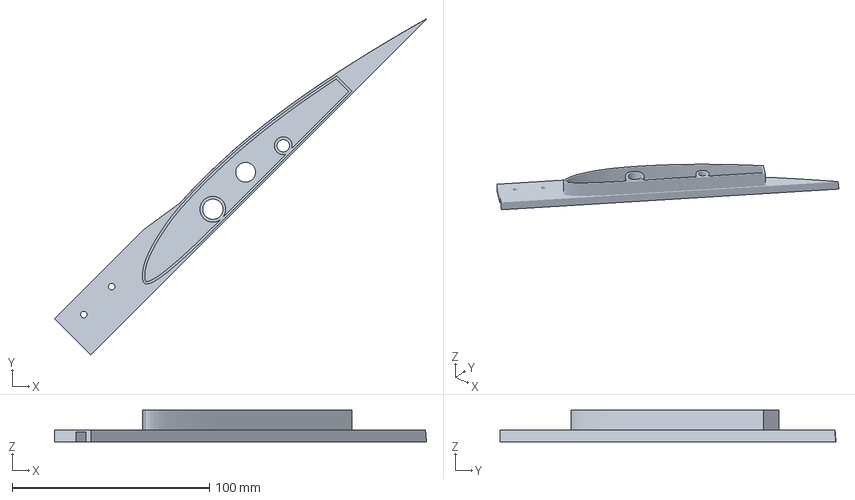
[picture p95: CAD file, 2026-11-04]
3mf/s1_petg/boom_rib_l.3mf
188.5 x 170.3 x 16.0 mm
