AjayaDahal/vtol-plane/3mf/x_lwpla/vtail_r.3mf

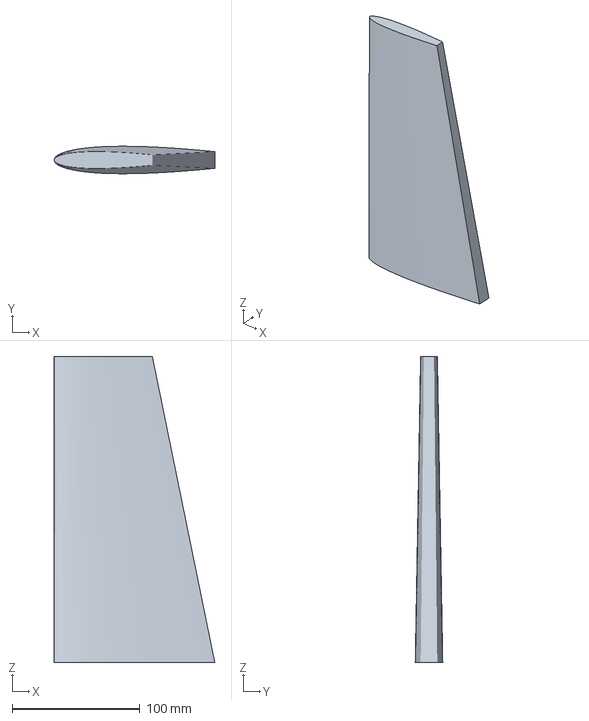
[picture p96: CAD file, 2026-11-04]
3mf/x_lwpla/vtail_r.3mf
126.0 x 21.6 x 240.0 mm
