AjayaDahal/vtol-plane/3mf/x_lwpla/wing_root_l.3mf

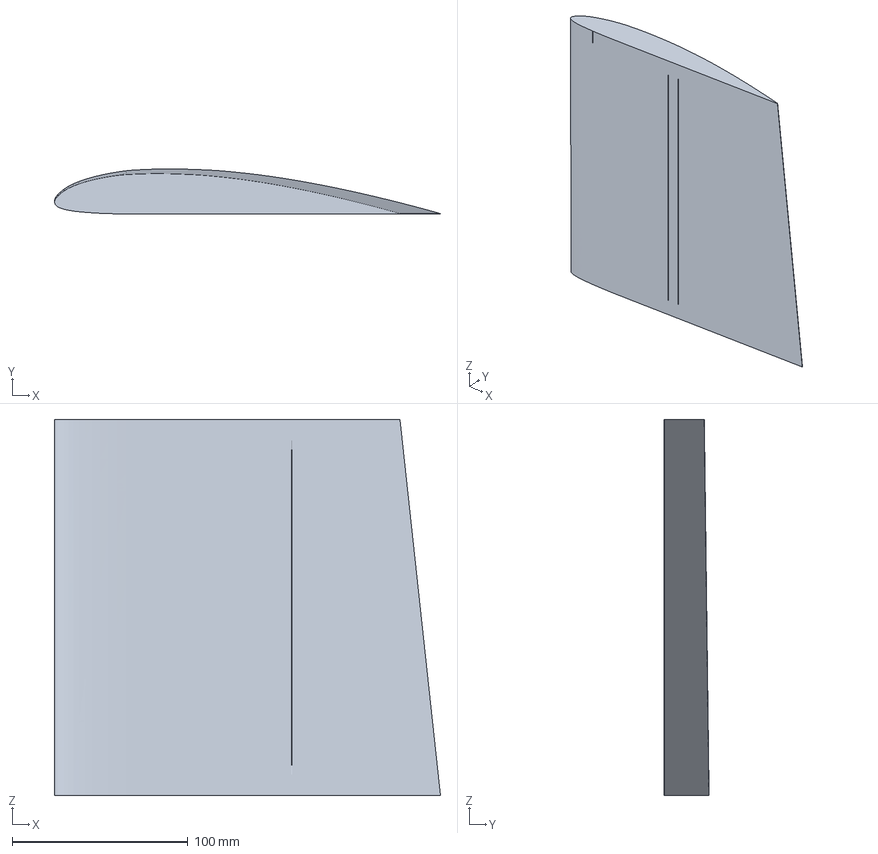
[picture p97: CAD file, 2026-11-04]
3mf/x_lwpla/wing_root_l.3mf
219.7 x 25.7 x 214.0 mm
