AjayaDahal/vtol-plane/parts/print_ready/vtail_tip_fairing.stl

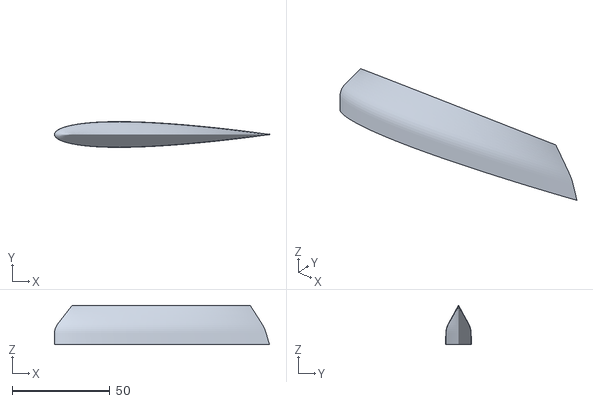
[picture p98: CAD file, 2026-11-02]
parts/print_ready/vtail_tip_fairing.stl
110.0 x 13.2 x 20.0
