AjayaDahal/vtol-plane/3mf/s1_petg/boom_pod_r.3mf

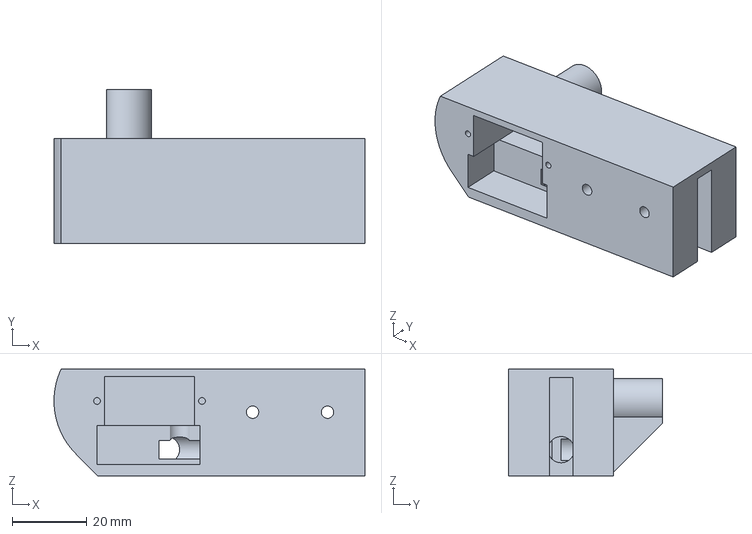
[picture p99: CAD file, 2026-11-04]
3mf/s1_petg/boom_pod_r.3mf
83.0 x 41.0 x 28.5 mm
