AjayaDahal/vtol-plane/3mf/x_lwpla/wing_tip_r.3mf

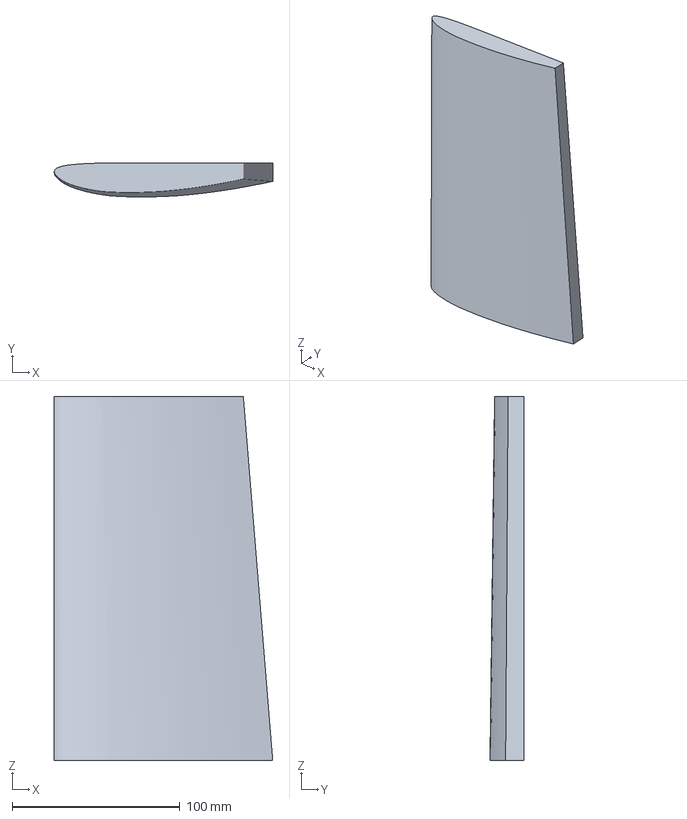
[picture p100: CAD file, 2026-11-04]
3mf/x_lwpla/wing_tip_r.3mf
130.3 x 20.3 x 217.0 mm
