AjayaDahal/vtol-plane/3mf/s1_petg/coupler_610.3mf

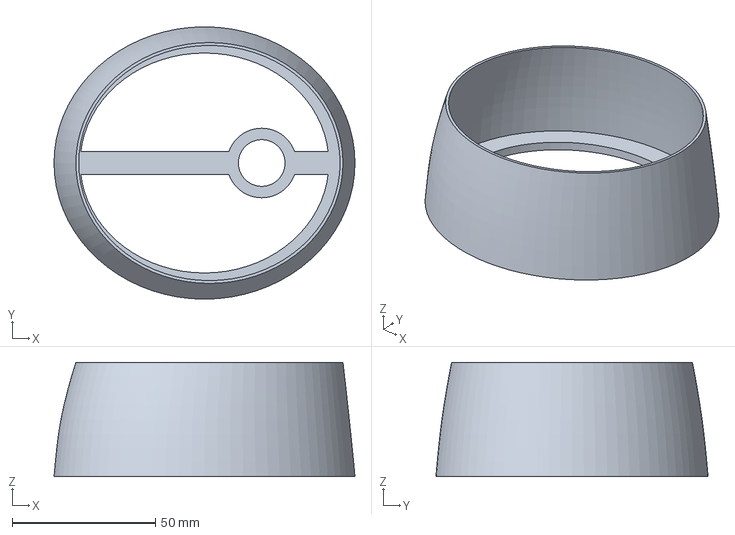
[picture p101: CAD file, 2026-11-04]
3mf/s1_petg/coupler_610.3mf
105.2 x 95.2 x 40.0 mm
