AjayaDahal/vtol-plane/3mf/x_lwpla/wing_mid_r.3mf

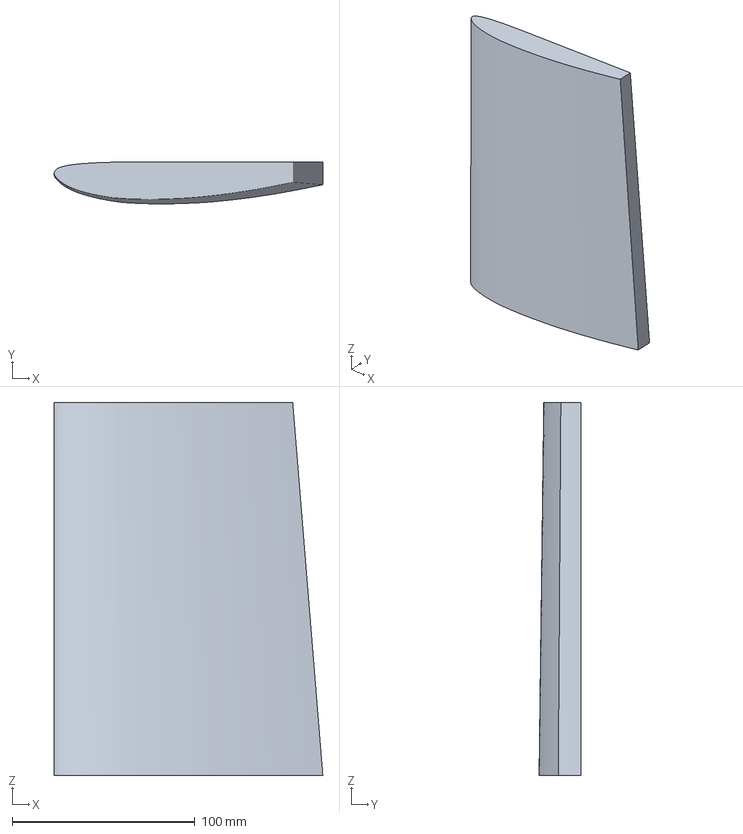
[picture p102: CAD file, 2026-11-04]
3mf/x_lwpla/wing_mid_r.3mf
147.0 x 22.9 x 204.0 mm
