AjayaDahal/vtol-plane/parts/print_ready/battery_tray.stl

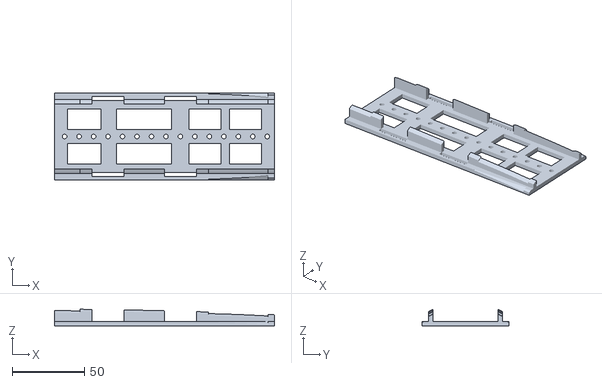
[picture p103: CAD file, 2026-11-02]
parts/print_ready/battery_tray.stl
152.0 x 60.0 x 11.5
