AjayaDahal/vtol-plane/sim/models/vtol_plane/meshes/aileron_mid_r_lwpla.stl

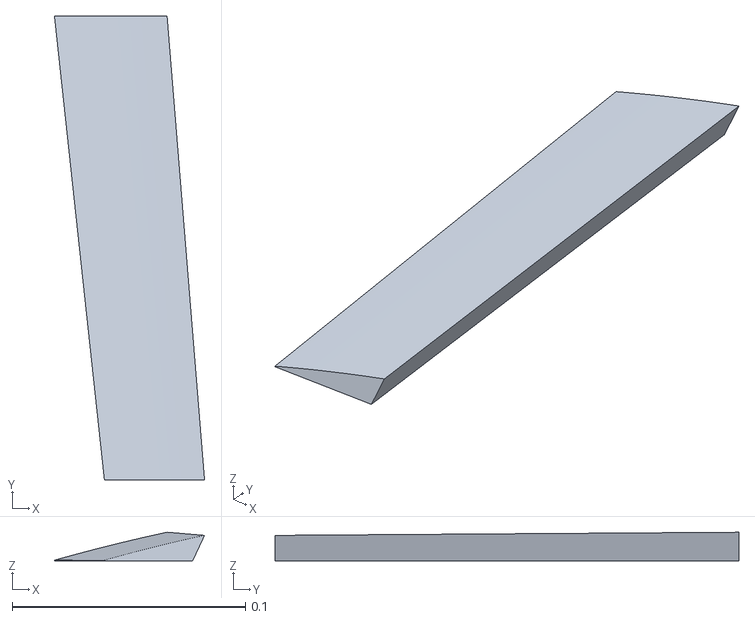
[picture p104: CAD file, 2026-11-05]
sim/models/vtol_plane/meshes/aileron_mid_r_lwpla.stl
0.0644 x 0.199 x 0.0122
