AjayaDahal/vtol-plane/3mf/s1_petg/boom_cup_r.3mf

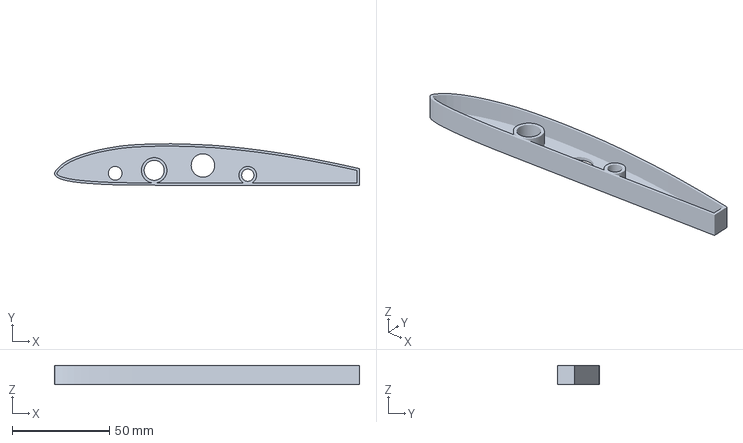
[picture p105: CAD file, 2026-11-04]
3mf/s1_petg/boom_cup_r.3mf
156.4 x 21.3 x 10.0 mm
