AjayaDahal/vtol-plane/parts/print_ready/servo_hatch.stl

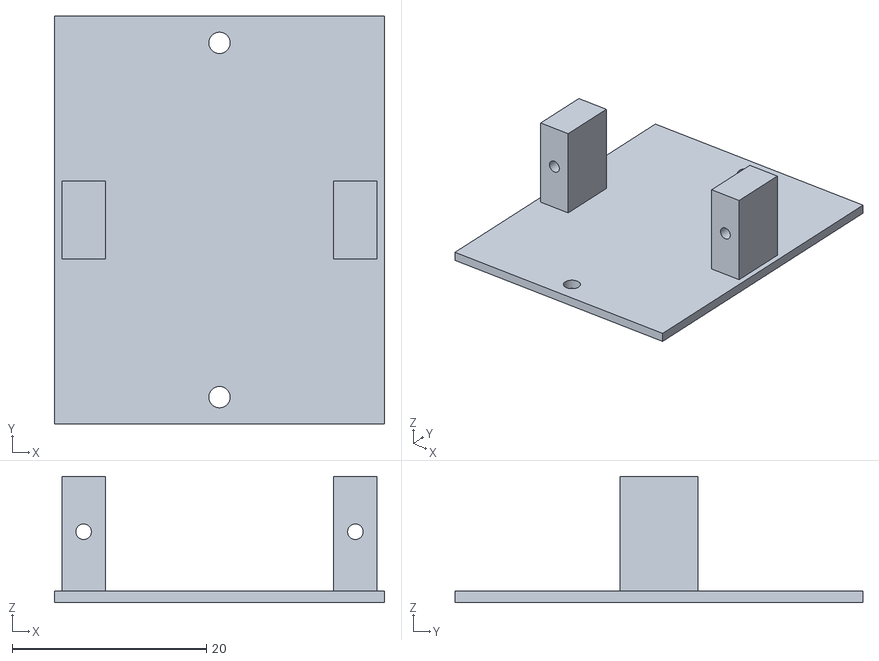
[picture p106: CAD file, 2026-11-02]
parts/print_ready/servo_hatch.stl
34.0 x 42.0 x 13.0
