AjayaDahal/vtol-plane/sim/models/vtol_plane/meshes/base_link_prop.stl

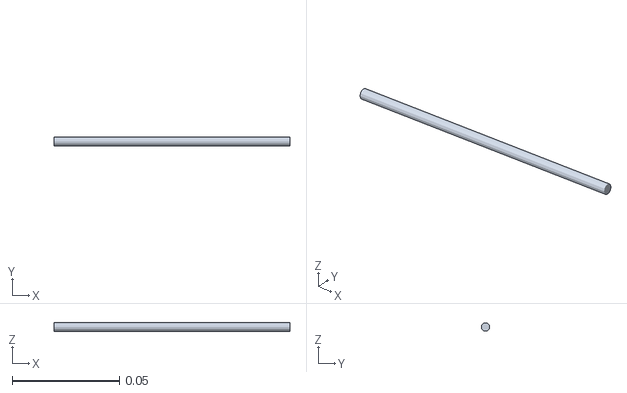
[picture p107: CAD file, 2026-11-05]
sim/models/vtol_plane/meshes/base_link_prop.stl
0.11 x 0.004 x 0.004
