AjayaDahal/vtol-plane/3mf/x_lwpla/fuse_1.3mf

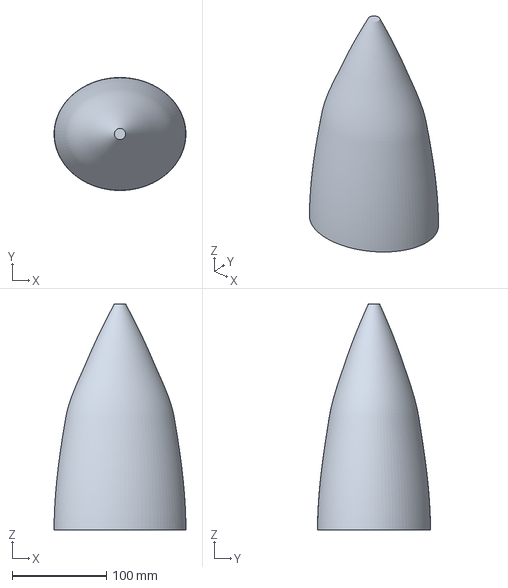
[picture p108: CAD file, 2026-11-04]
3mf/x_lwpla/fuse_1.3mf
140.0 x 120.0 x 240.0 mm
