AjayaDahal/vtol-plane/sim/models/vtol_plane/meshes/tilt_r_petg.stl

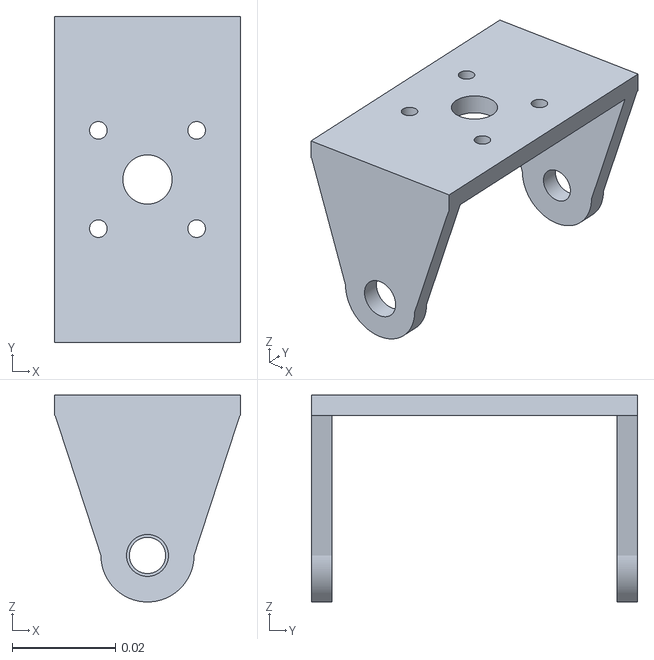
[picture p109: CAD file, 2026-11-05]
sim/models/vtol_plane/meshes/tilt_r_petg.stl
0.036 x 0.063 x 0.04
