AjayaDahal/vtol-plane/3mf/s1_petg/pod_collar.3mf

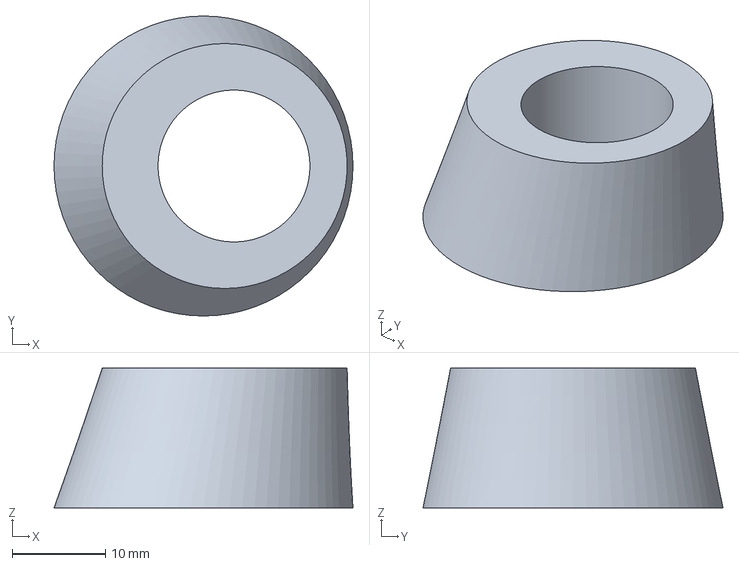
[picture p110: CAD file, 2026-11-04]
3mf/s1_petg/pod_collar.3mf
32.1 x 32.2 x 15.0 mm
