AjayaDahal/vtol-plane/3mf/s1_petg/tail_block.3mf

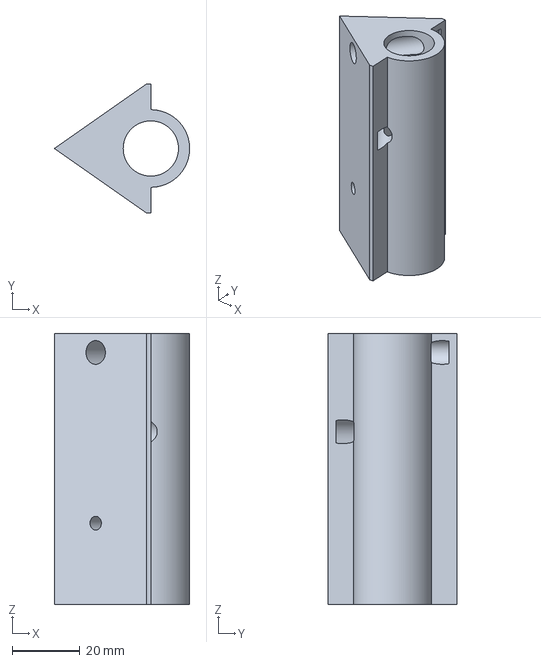
[picture p111: CAD file, 2026-11-04]
3mf/s1_petg/tail_block.3mf
39.9 x 38.0 x 80.0 mm
