AjayaDahal/vtol-plane/sim/models/vtol_plane/meshes/base_link_motor.stl

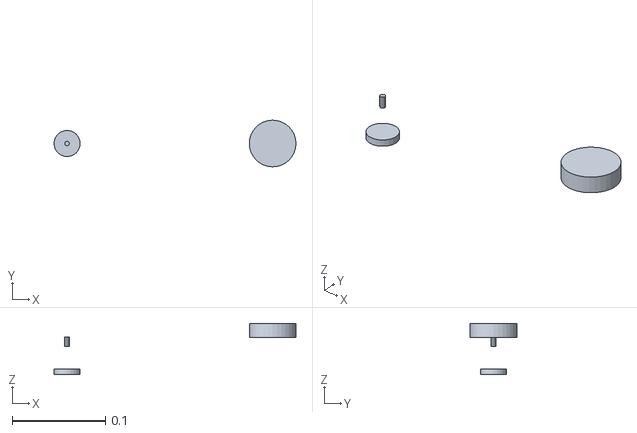
[picture p112: CAD file, 2026-11-05]
sim/models/vtol_plane/meshes/base_link_motor.stl
0.259 x 0.05 x 0.0549
