AjayaDahal/vtol-plane/parts/print_ready/gps_mount.stl

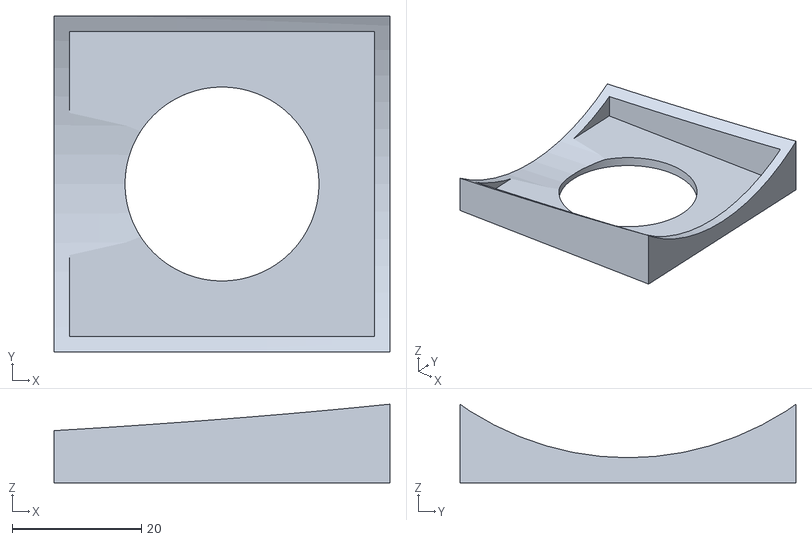
[picture p113: CAD file, 2026-11-02]
parts/print_ready/gps_mount.stl
52.0 x 52.0 x 12.2
