AjayaDahal/vtol-plane/3mf/s1_petg/coupler_240.3mf

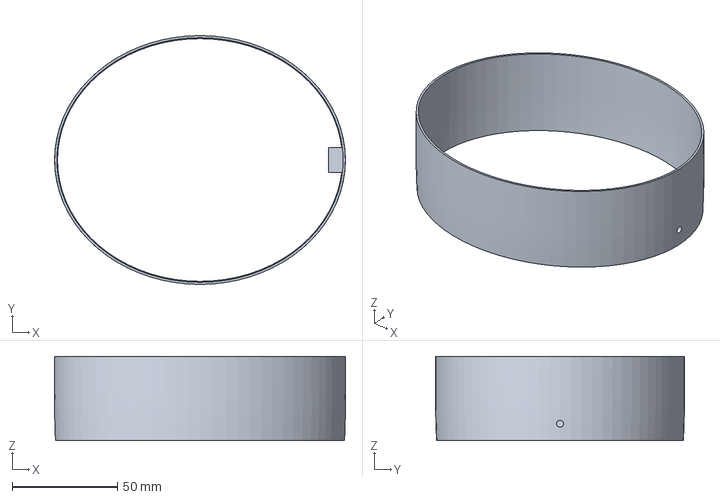
[picture p114: CAD file, 2026-11-04]
3mf/s1_petg/coupler_240.3mf
138.3 x 118.3 x 40.0 mm
