AjayaDahal/vtol-plane/3mf/x_lwpla/fuse_2.3mf

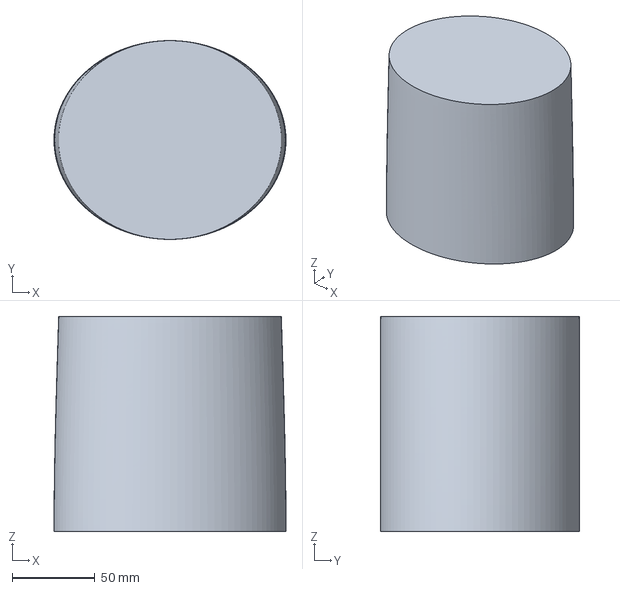
[picture p115: CAD file, 2026-11-04]
3mf/x_lwpla/fuse_2.3mf
140.0 x 120.0 x 130.0 mm
