AjayaDahal/vtol-plane/sim/models/vtol_plane/meshes/base_link_carbon.stl

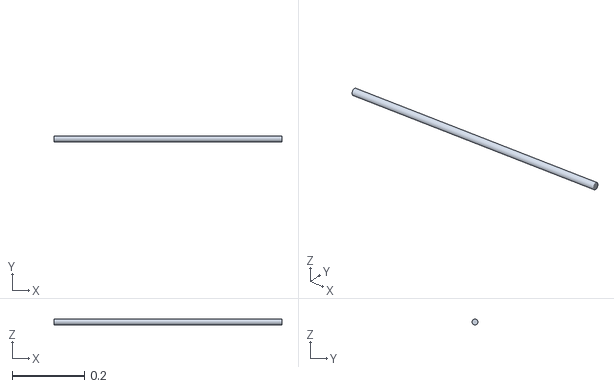
[picture p116: CAD file, 2026-11-05]
sim/models/vtol_plane/meshes/base_link_carbon.stl
0.63 x 0.016 x 0.016
