AjayaDahal/vtol-plane/3mf/s1_petg/control_horn.3mf

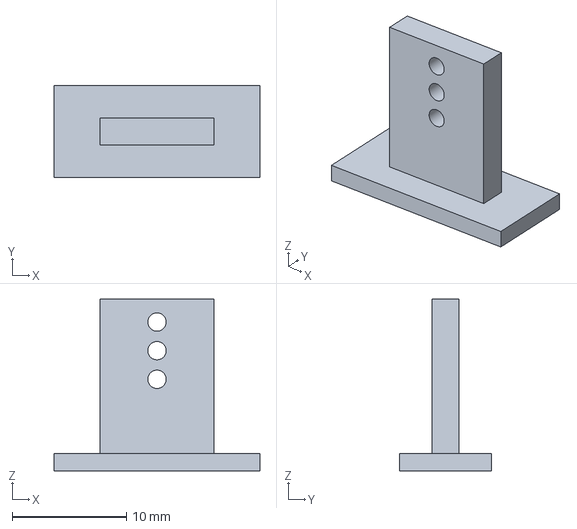
[picture p117: CAD file, 2026-11-04]
3mf/s1_petg/control_horn.3mf
18.0 x 8.00 x 15.0 mm
