AjayaDahal/vtol-plane/parts/assembly/boom_rib_r.stl

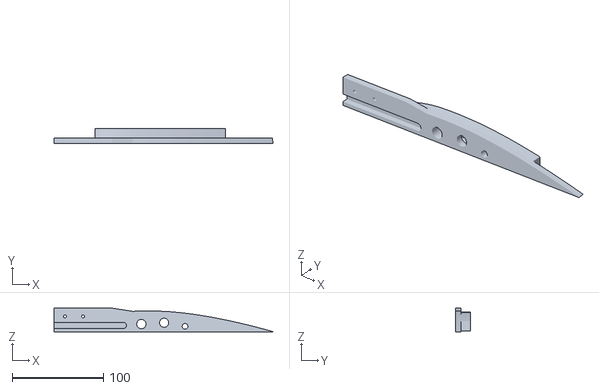
[picture p118: CAD file, 2026-11-02]
parts/assembly/boom_rib_r.stl
240.6 x 16.0 x 26.0
