AjayaDahal/vtol-plane/parts/assembly/vtail_root_rib_l.stl

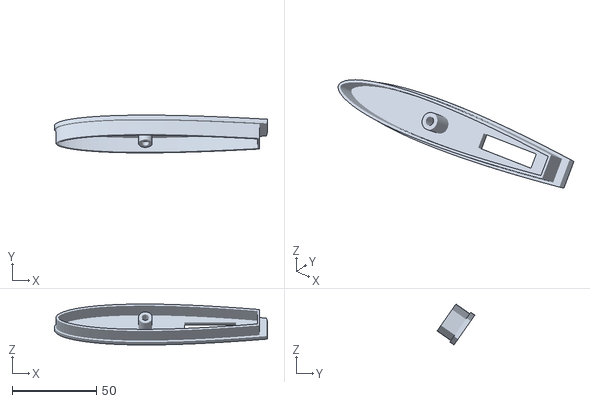
[picture p119: CAD file, 2026-11-02]
parts/assembly/vtail_root_rib_l.stl
126.6 x 22.5 x 24.4
