AjayaDahal/vtol-plane/(list of files, cad)

Other CAD files:
parts/assembly/frame_main.stl
parts/print_ready/frame_main.stl
parts/print_ready/rib_midtip_l.stl
parts/assembly/rib_midtip_l.stl
parts/print_ready/rib_midtip_r.stl
parts/print_ready/tip_fairing_r.stl
3mf/s1_petg/rib_midtip_r.3mf
3mf/x_lwpla/aileron_mid_l.3mf
parts/print_ready/rib_tip_r.stl
sim/models/vtol_plane/meshes/aileron_tip_l_lwpla.stl
3mf/x_lwpla/ruddervator_l.3mf
parts/assembly/ruddervator_r.stl
3mf/x_lwpla/tip_fairing_l.3mf
parts/assembly/vtail_tip_cap_r.stl
parts/print_ready/ruddervator_r.stl
parts/assembly/tip_fairing_l.stl
parts/print_ready/rib_tip_l.stl
3mf/s1_petg/rib_root_l.3mf
parts/assembly/rear_motor_mount.stl
parts/assembly/tip_fairing_r.stl
parts/print_ready/tip_fairing_l.stl
sim/models/vtol_plane/meshes/base_link_bell.stl
parts/assembly/rib_tip_l.stl
3mf/x_lwpla/aileron_tip_l.3mf
parts/assembly/vtail_tip_fairing_l.stl
parts/print_ready/boom_pod_r.stl
3mf/s1_petg/vtail_tip_cap.3mf
3mf/x_lwpla/wing_tip_l.3mf
parts/assembly/battery_tray.stl
3mf/s1_petg/rib_tip_r.3mf
parts/assembly/hatch_block.stl
parts/print_ready/boom_pod_l.stl
3mf/x_lwpla/vtail_l.3mf
parts/assembly/boom_pod_l.stl
parts/print_ready/hatch_block.stl
sim/models/vtol_plane/meshes/ruddervator_l_lwpla.stl
3mf/x_lwpla/wing_root_r.3mf
parts/assembly/servo_hatch.stl
parts/print_ready/wing_mid_l.stl
3mf/s1_petg/rib_tip_l.3mf
3mf/x_lwpla/ruddervator_r.3mf
parts/assembly/boom_pod_r.stl
sim/models/vtol_plane/meshes/tilt_l_petg.stl
3mf/x_lwpla/wing_mid_l.3mf
parts/assembly/wing_root_r.stl
parts/print_ready/wing_root_l.stl
sim/models/vtol_plane/meshes/rotor_2_prop.stl
3mf/s1_petg/rear_motor_mount.3mf
parts/assembly/wing_mid_r.stl
parts/print_ready/fc_shelf.stl
3mf/s1_petg/boom_pod_l.3mf
3mf/x_lwpla/vtail_tip_fairing.3mf
parts/assembly/fc_shelf.stl
parts/print_ready/wing_root_r.stl
sim/models/vtol_plane/meshes/aileron_mid_l_lwpla.stl
parts/assembly/gps_mount.stl
parts/print_ready/wing_mid_r.stl
3mf/s1_petg/yoke_r.3mf
parts/assembly/wing_mid_l.stl
parts/print_ready/rib_root_l.stl
parts/assembly/wing_root_l.stl
parts/print_ready/boom_rib_r.stl
3mf/s1_petg/battery_tray.3mf
parts/assembly/rib_root_r.stl
parts/print_ready/boom_rib_l.stl
3mf/s1_petg/rib_midtip_l.3mf
parts/assembly/rib_root_l.stl
parts/print_ready/rib_root_r.stl
3mf/s1_petg/gps_mount.3mf
parts/print_ready/vtail_root_rib.stl
3mf/s1_petg/boom_cup_l.3mf
parts/print_ready/coupler_240.stl
3mf/s1_petg/boom_rib_r.3mf
parts/assembly/vtail_root_rib_r.stl
parts/print_ready/boom_cup_r.stl
3mf/s1_petg/servo_hatch.3mf
parts/assembly/boom_rib_l.stl
parts/print_ready/boom_cup_l.stl
parts/assembly/boom_cup_r.stl
parts/print_ready/fuse_4.stl
parts/assembly/boom_cup_l.stl
parts/print_ready/fuse_3.stl
parts/assembly/coupler_240.stl
parts/print_ready/fuse_2.stl
parts/assembly/aileron_mid_l.stl
parts/assembly/aileron_mid_r.stl
parts/assembly/aileron_tip_l.stl
parts/assembly/aileron_tip_r.stl
parts/assembly/control_horn.stl
parts/assembly/coupler_370.stl
parts/assembly/coupler_610.stl
parts/assembly/frame_rear.stl
parts/assembly/fuse_1.stl
parts/assembly/fuse_2.stl
parts/assembly/fuse_3.stl
parts/assembly/fuse_4.stl
parts/assembly/pod_collar.stl
parts/assembly/tail_block.stl
parts/assembly/vtail_l.stl
parts/assembly/vtail_r.stl
parts/assembly/wing_tip_l.stl
parts/assembly/wing_tip_r.stl
parts/assembly/yoke_l.stl
parts/assembly/yoke_r.stl
parts/print_ready/aileron_mid_l.stl
parts/print_ready/aileron_mid_r.stl
parts/print_ready/aileron_tip_l.stl
parts/print_ready/aileron_tip_r.stl
parts/print_ready/control_horn.stl
parts/print_ready/coupler_370.stl
parts/print_ready/coupler_610.stl
parts/print_ready/frame_rear.stl
parts/print_ready/fuse_1.stl
parts/print_ready/pod_collar.stl
parts/print_ready/tail_block.stl
parts/print_ready/vtail_l.stl
parts/print_ready/vtail_r.stl
parts/print_ready/wing_tip_l.stl
parts/print_ready/wing_tip_r.stl
parts/print_ready/yoke_l.stl
parts/print_ready/yoke_r.stl
