AjayaDahal/vtol-plane/renders/11_wing_top_printed.png

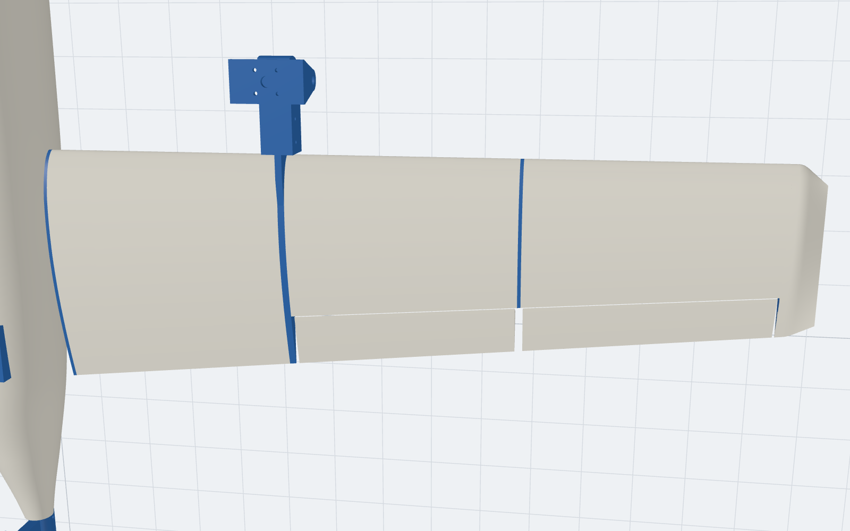
renders/11_wing_top_printed.png
