AjayaDahal/vtol-plane/renders/21_joint_boom_rib_printed.png

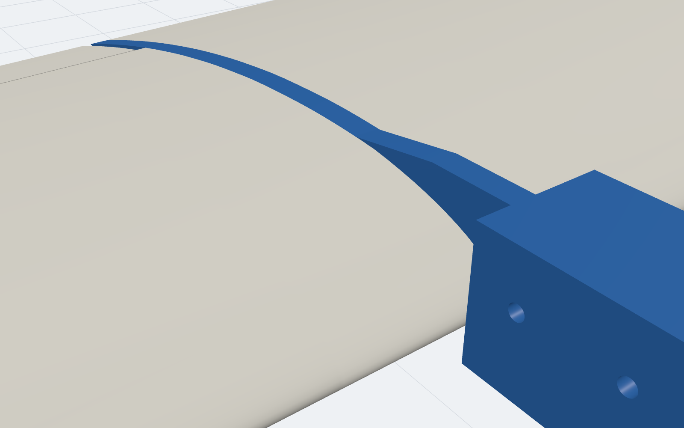
renders/21_joint_boom_rib_printed.png
