AjayaDahal/vtol-plane/renders/36_print_files_s1_petg.png

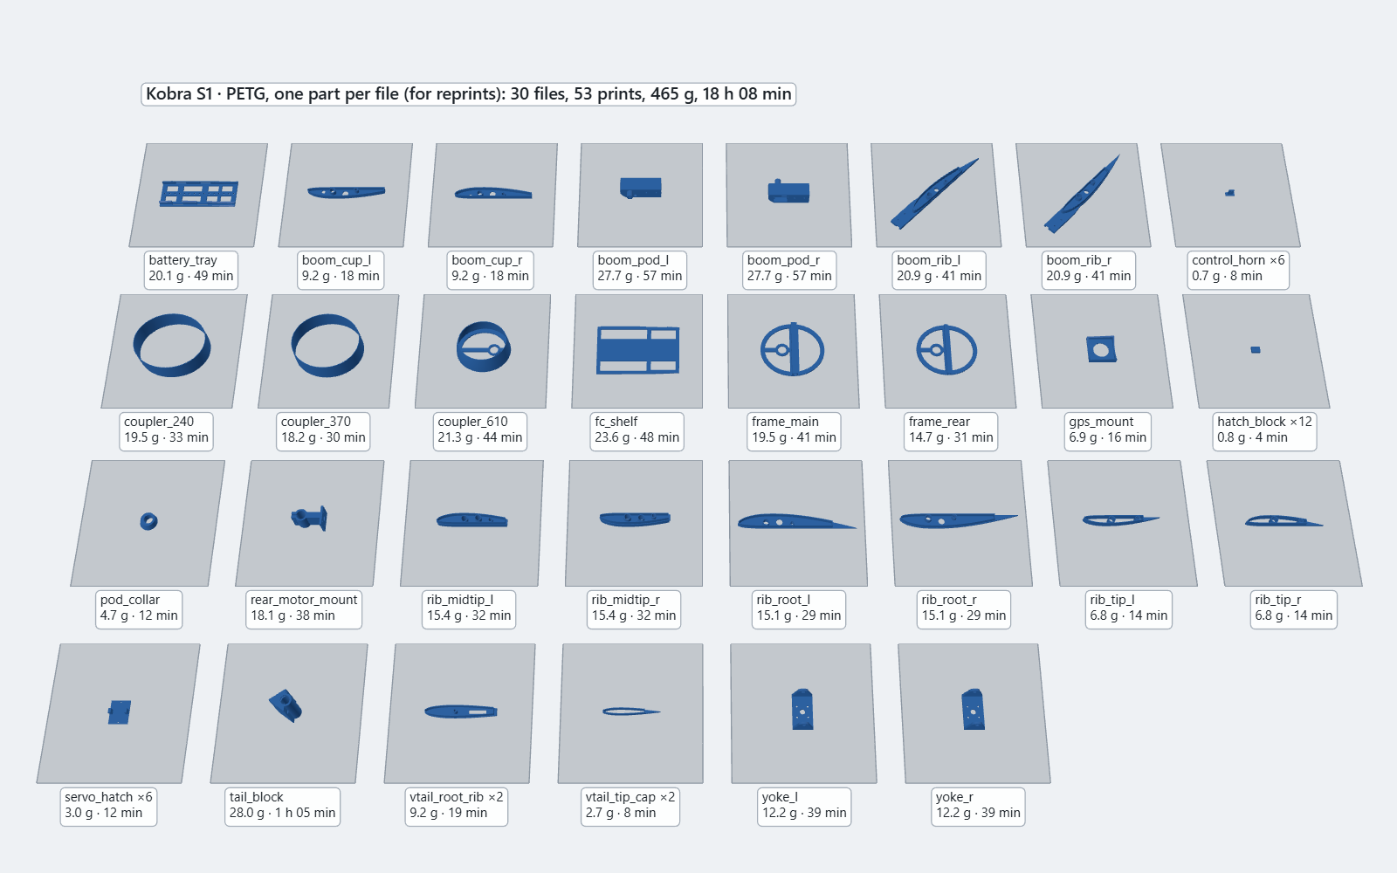
renders/36_print_files_s1_petg.png
