AjayaDahal/vtol-plane/renders/38_print_files_x_lwpla.png

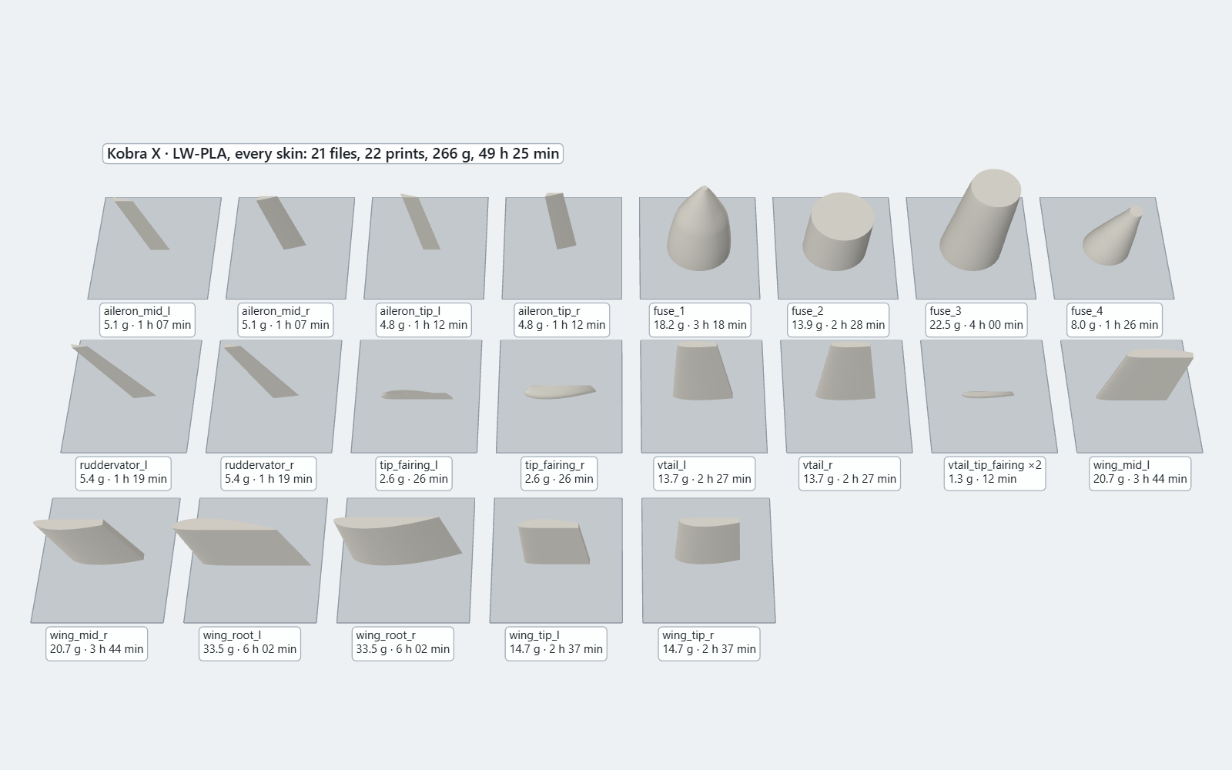
renders/38_print_files_x_lwpla.png
