AjayaDahal/vtol-plane/sim/models/vtol_plane/model.sdf

<?xml version='1.0'?>
<!-- Generated by scripts/make_sim.py from the design; do not edit. Meshes ac7251a37f20decf. -->
<sdf version='1.9'>
<model name='vtol_plane'>
<pose>0 0 0.08093 0 0 0</pose>
<link name='base_link'>
<inertial><pose>-0.00333 -0.00092 -0.00503 0 0 0</pose><mass>1.821185</mass><inertia><ixx>0.0895254</ixx><ixy>3.94179e-06</ixy><ixz>0.00395416</ixz><iyy>0.0698186</iyy><iyz>-2.53947e-06</iyz><izz>0.155938</izz></inertia></inertial>
<visual name='bell'><geometry><mesh><uri>model://vtol_plane/meshes/base_link_bell.stl</uri></mesh></geometry><material><ambient>0.69 0.19 0.19 1</ambient><diffuse>0.69 0.19 0.19 1</diffuse><specular>0.2 0.2 0.2 1</specular></material></visual>
<visual name='carbon'><geometry><mesh><uri>model://vtol_plane/meshes/base_link_carbon.stl</uri></mesh></geometry><material><ambient>0.11 0.11 0.11 1</ambient><diffuse>0.11 0.11 0.11 1</diffuse><specular>0.2 0.2 0.2 1</specular></material></visual>
<visual name='lwpla'><geometry><mesh><uri>model://vtol_plane/meshes/base_link_lwpla.stl</uri></mesh></geometry><material><ambient>0.92 0.90 0.85 1</ambient><diffuse>0.92 0.90 0.85 1</diffuse><specular>0.2 0.2 0.2 1</specular></material></visual>
<visual name='motor'><geometry><mesh><uri>model://vtol_plane/meshes/base_link_motor.stl</uri></mesh></geometry><material><ambient>0.23 0.23 0.23 1</ambient><diffuse>0.23 0.23 0.23 1</diffuse><specular>0.2 0.2 0.2 1</specular></material></visual>
<visual name='petg'><geometry><mesh><uri>model://vtol_plane/meshes/base_link_petg.stl</uri></mesh></geometry><material><ambient>0.18 0.43 0.71 1</ambient><diffuse>0.18 0.43 0.71 1</diffuse><specular>0.2 0.2 0.2 1</specular></material></visual>
<visual name='prop'><geometry><mesh><uri>model://vtol_plane/meshes/base_link_prop.stl</uri></mesh></geometry><material><ambient>0.60 0.64 0.68 1</ambient><diffuse>0.60 0.64 0.68 1</diffuse><specular>0.2 0.2 0.2 1</specular></material></visual>
<collision name='belly_pad'><pose>0.06268 0 -0.07293 0 0 0</pose><geometry><box><size>0.25 0.06 0.012</size></box></geometry></collision>
<sensor name='imu_sensor' type='imu'><always_on>1</always_on><update_rate>250</update_rate><imu><angular_velocity><x><noise type='gaussian'><mean>0</mean><stddev>0.0003394</stddev><dynamic_bias_stddev>3.8785e-05</dynamic_bias_stddev><dynamic_bias_correlation_time>1000</dynamic_bias_correlation_time></noise></x><y><noise type='gaussian'><mean>0</mean><stddev>0.0003394</stddev><dynamic_bias_stddev>3.8785e-05</dynamic_bias_stddev><dynamic_bias_correlation_time>1000</dynamic_bias_correlation_time></noise></y><z><noise type='gaussian'><mean>0</mean><stddev>0.0003394</stddev><dynamic_bias_stddev>3.8785e-05</dynamic_bias_stddev><dynamic_bias_correlation_time>1000</dynamic_bias_correlation_time></noise></z></angular_velocity><linear_acceleration><x><noise type='gaussian'><mean>0</mean><stddev>0.004</stddev><dynamic_bias_stddev>0.006</dynamic_bias_stddev><dynamic_bias_correlation_time>300</dynamic_bias_correlation_time></noise></x><y><noise type='gaussian'><mean>0</mean><stddev>0.004</stddev><dynamic_bias_stddev>0.006</dynamic_bias_stddev><dynamic_bias_correlation_time>300</dynamic_bias_correlation_time></noise></y><z><noise type='gaussian'><mean>0</mean><stddev>0.004</stddev><dynamic_bias_stddev>0.006</dynamic_bias_stddev><dynamic_bias_correlation_time>300</dynamic_bias_correlation_time></noise></z></linear_acceleration></imu></sensor>
<sensor name='air_pressure_sensor' type='air_pressure'><always_on>1</always_on><update_rate>50</update_rate><air_pressure><pressure><noise type='gaussian'><mean>0</mean><stddev>0.01</stddev></noise></pressure></air_pressure></sensor>
<sensor name='magnetometer_sensor' type='magnetometer'><always_on>1</always_on><update_rate>100</update_rate><magnetometer><x><noise type='gaussian'><stddev>3e-7</stddev></noise></x><y><noise type='gaussian'><stddev>3e-7</stddev></noise></y><z><noise type='gaussian'><stddev>3e-7</stddev></noise></z></magnetometer></sensor>
<sensor name='navsat_sensor' type='navsat'><always_on>1</always_on><update_rate>30</update_rate></sensor>
</link>
<link name='airspeed_link'><pose>0.12768 -0.4 -0.00054 0 0 0</pose><inertial><pose>0 0 0 0 0 0</pose><mass>0.0001</mass><inertia><ixx>1e-08</ixx><ixy>0</ixy><ixz>0</ixz><iyy>1e-08</iyy><iyz>0</iyz><izz>1e-08</izz></inertia></inertial>
<sensor name='air_speed' type='air_speed'><always_on>1</always_on><update_rate>10</update_rate></sensor></link>
<joint name='airspeed_joint' type='fixed'><parent>base_link</parent><child>airspeed_link</child></joint>
<link name='tilt_r'><pose>0.12268 -0.28 0.01304 0 0 0</pose><inertial><pose>0 0.00001 0.04193 0 0 0</pose><mass>0.06222</mass><inertia><ixx>2.24675e-05</ixx><ixy>2.32033e-22</ixy><ixz>-3.31919e-19</ixz><iyy>1.67233e-05</iyy><iyz>2.01061e-08</iyz><izz>1.55187e-05</izz></inertia></inertial>
<visual name='bell'><geometry><mesh><uri>model://vtol_plane/meshes/tilt_r_bell.stl</uri></mesh></geometry><material><ambient>0.69 0.19 0.19 1</ambient><diffuse>0.69 0.19 0.19 1</diffuse><specular>0.2 0.2 0.2 1</specular></material></visual>
<visual name='motor'><geometry><mesh><uri>model://vtol_plane/meshes/tilt_r_motor.stl</uri></mesh></geometry><material><ambient>0.23 0.23 0.23 1</ambient><diffuse>0.23 0.23 0.23 1</diffuse><specular>0.2 0.2 0.2 1</specular></material></visual>
<visual name='petg'><geometry><mesh><uri>model://vtol_plane/meshes/tilt_r_petg.stl</uri></mesh></geometry><material><ambient>0.18 0.43 0.71 1</ambient><diffuse>0.18 0.43 0.71 1</diffuse><specular>0.2 0.2 0.2 1</specular></material></visual>
</link>
<joint name='tilt_r_joint' type='revolute'><parent>base_link</parent><child>tilt_r</child><axis><xyz>0 1 0</xyz><limit><lower>-0.43633</lower><upper>1.65806</upper><effort>0.3</effort></limit><dynamics><damping>0.01</damping></dynamics></axis></joint>
<link name='tilt_l'><pose>0.12268 0.28 0.01304 0 0 0</pose><inertial><pose>0 -0.00001 0.04193 0 0 0</pose><mass>0.06222</mass><inertia><ixx>2.24675e-05</ixx><ixy>-1.12048e-22</ixy><ixz>-3.17466e-19</ixz><iyy>1.67233e-05</iyy><iyz>-2.01061e-08</iyz><izz>1.55187e-05</izz></inertia></inertial>
<visual name='bell'><geometry><mesh><uri>model://vtol_plane/meshes/tilt_l_bell.stl</uri></mesh></geometry><material><ambient>0.69 0.19 0.19 1</ambient><diffuse>0.69 0.19 0.19 1</diffuse><specular>0.2 0.2 0.2 1</specular></material></visual>
<visual name='motor'><geometry><mesh><uri>model://vtol_plane/meshes/tilt_l_motor.stl</uri></mesh></geometry><material><ambient>0.23 0.23 0.23 1</ambient><diffuse>0.23 0.23 0.23 1</diffuse><specular>0.2 0.2 0.2 1</specular></material></visual>
<visual name='petg'><geometry><mesh><uri>model://vtol_plane/meshes/tilt_l_petg.stl</uri></mesh></geometry><material><ambient>0.18 0.43 0.71 1</ambient><diffuse>0.18 0.43 0.71 1</diffuse><specular>0.2 0.2 0.2 1</specular></material></visual>
</link>
<joint name='tilt_l_joint' type='revolute'><parent>base_link</parent><child>tilt_l</child><axis><xyz>0 1 0</xyz><limit><lower>-0.43633</lower><upper>1.65806</upper><effort>0.3</effort></limit><dynamics><damping>0.01</damping></dynamics></axis></joint>
<link name='rotor_0'><pose>0.12268 -0.28 0.08104 0 0 0</pose><inertial><pose>0 0 0 0 0 0</pose><mass>0.008</mass><inertia><ixx>1.26736e-05</ixx><ixy>0</ixy><ixz>0</ixz><iyy>1.26736e-05</iyy><iyz>0</iyz><izz>2.11227e-05</izz></inertia></inertial>
<visual name='prop'><geometry><mesh><uri>model://vtol_plane/meshes/rotor_0_prop.stl</uri></mesh></geometry><material><ambient>0.60 0.64 0.68 1</ambient><diffuse>0.60 0.64 0.68 1</diffuse><specular>0.2 0.2 0.2 1</specular></material></visual>
</link>
<joint name='rotor_0_joint' type='revolute'><parent>tilt_r</parent><child>rotor_0</child><axis><xyz>0 0 1</xyz><limit><lower>-1e16</lower><upper>1e16</upper></limit></axis></joint>
<link name='rotor_1'><pose>0.12268 0.28 0.08104 0 0 0</pose><inertial><pose>0 0 0 0 0 0</pose><mass>0.008</mass><inertia><ixx>1.26736e-05</ixx><ixy>0</ixy><ixz>0</ixz><iyy>1.26736e-05</iyy><iyz>0</iyz><izz>2.11227e-05</izz></inertia></inertial>
<visual name='prop'><geometry><mesh><uri>model://vtol_plane/meshes/rotor_1_prop.stl</uri></mesh></geometry><material><ambient>0.60 0.64 0.68 1</ambient><diffuse>0.60 0.64 0.68 1</diffuse><specular>0.2 0.2 0.2 1</specular></material></visual>
</link>
<joint name='rotor_1_joint' type='revolute'><parent>tilt_l</parent><child>rotor_1</child><axis><xyz>0 0 1</xyz><limit><lower>-1e16</lower><upper>1e16</upper></limit></axis></joint>
<link name='rotor_2'><pose>-0.34232 0 0.05404 0 0 0</pose><inertial><pose>0 0 0 0 0 0</pose><mass>0.008</mass><inertia><ixx>1.26736e-05</ixx><ixy>0</ixy><ixz>0</ixz><iyy>1.26736e-05</iyy><iyz>0</iyz><izz>2.11227e-05</izz></inertia></inertial>
<visual name='prop'><geometry><mesh><uri>model://vtol_plane/meshes/rotor_2_prop.stl</uri></mesh></geometry><material><ambient>0.60 0.64 0.68 1</ambient><diffuse>0.60 0.64 0.68 1</diffuse><specular>0.2 0.2 0.2 1</specular></material></visual>
</link>
<joint name='rotor_2_joint' type='revolute'><parent>base_link</parent><child>rotor_2</child><axis><xyz>0 0 1</xyz><limit><lower>-1e16</lower><upper>1e16</upper></limit></axis></joint>
<link name='aileron_mid_r'><pose>-0.08907 -0.286 0.00541 0 0 0</pose><inertial><pose>-0.01408 -0.09732 -0.00875 0 0 0</pose><mass>0.00512</mass><inertia><ixx>1.77755e-05</ixx><ixy>1.6456e-06</ixy><ixz>-1.51643e-07</ixz><iyy>1.19681e-06</iyy><iyz>-3.83085e-08</iyz><izz>1.88168e-05</izz></inertia></inertial>
<visual name='lwpla'><geometry><mesh><uri>model://vtol_plane/meshes/aileron_mid_r_lwpla.stl</uri></mesh></geometry><material><ambient>0.92 0.90 0.85 1</ambient><diffuse>0.92 0.90 0.85 1</diffuse><specular>0.2 0.2 0.2 1</specular></material></visual>
</link>
<joint name='aileron_mid_r_joint' type='revolute'><parent>base_link</parent><child>aileron_mid_r</child><axis><xyz>-0.080505 0.996731 0.006788</xyz><limit><lower>-0.5236</lower><upper>0.5236</upper><effort>0.2</effort></limit><dynamics><damping>0.001</damping></dynamics></axis></joint>
<link name='aileron_tip_r'><pose>-0.07243 -0.492 0.00401 0 0 0</pose><inertial><pose>-0.01091 -0.1037 -0.0078 0 0 0</pose><mass>0.00476</mass><inertia><ixx>1.87374e-05</ixx><ixy>1.73843e-06</ixy><ixz>-1.06988e-07</ixz><iyy>9.06163e-07</iyy><iyz>-4.032e-08</iyz><izz>1.95325e-05</izz></inertia></inertial>
<visual name='lwpla'><geometry><mesh><uri>model://vtol_plane/meshes/aileron_tip_r_lwpla.stl</uri></mesh></geometry><material><ambient>0.92 0.90 0.85 1</ambient><diffuse>0.92 0.90 0.85 1</diffuse><specular>0.2 0.2 0.2 1</specular></material></visual>
</link>
<joint name='aileron_tip_r_joint' type='revolute'><parent>base_link</parent><child>aileron_tip_r</child><axis><xyz>-0.080505 0.996731 0.006788</xyz><limit><lower>-0.5236</lower><upper>0.5236</upper><effort>0.2</effort></limit><dynamics><damping>0.001</damping></dynamics></axis></joint>
<link name='aileron_mid_l'><pose>-0.08907 0.286 0.00541 0 0 0</pose><inertial><pose>-0.01408 0.09732 -0.00875 0 0 0</pose><mass>0.00512</mass><inertia><ixx>1.77755e-05</ixx><ixy>-1.6456e-06</ixy><ixz>-1.51643e-07</ixz><iyy>1.19681e-06</iyy><iyz>3.83085e-08</iyz><izz>1.88168e-05</izz></inertia></inertial>
<visual name='lwpla'><geometry><mesh><uri>model://vtol_plane/meshes/aileron_mid_l_lwpla.stl</uri></mesh></geometry><material><ambient>0.92 0.90 0.85 1</ambient><diffuse>0.92 0.90 0.85 1</diffuse><specular>0.2 0.2 0.2 1</specular></material></visual>
</link>
<joint name='aileron_mid_l_joint' type='revolute'><parent>base_link</parent><child>aileron_mid_l</child><axis><xyz>0.080505 0.996731 -0.006788</xyz><limit><lower>-0.5236</lower><upper>0.5236</upper><effort>0.2</effort></limit><dynamics><damping>0.001</damping></dynamics></axis></joint>
<link name='aileron_tip_l'><pose>-0.07243 0.492 0.00401 0 0 0</pose><inertial><pose>-0.01091 0.1037 -0.0078 0 0 0</pose><mass>0.00476</mass><inertia><ixx>1.87374e-05</ixx><ixy>-1.73843e-06</ixy><ixz>-1.06988e-07</ixz><iyy>9.06163e-07</iyy><iyz>4.032e-08</iyz><izz>1.95325e-05</izz></inertia></inertial>
<visual name='lwpla'><geometry><mesh><uri>model://vtol_plane/meshes/aileron_tip_l_lwpla.stl</uri></mesh></geometry><material><ambient>0.92 0.90 0.85 1</ambient><diffuse>0.92 0.90 0.85 1</diffuse><specular>0.2 0.2 0.2 1</specular></material></visual>
</link>
<joint name='aileron_tip_l_joint' type='revolute'><parent>base_link</parent><child>aileron_tip_l</child><axis><xyz>0.080505 0.996731 -0.006788</xyz><limit><lower>-0.5236</lower><upper>0.5236</upper><effort>0.2</effort></limit><dynamics><damping>0.001</damping></dynamics></axis></joint>
<link name='ruddervator_r'><pose>-0.6073 -0.01137 0.00422 0 0 0</pose><inertial><pose>0.00068 -0.09069 0.05594 0 0 0</pose><mass>0.00543</mass><inertia><ixx>2.50523e-05</ixx><ixy>4.98365e-06</ixy><ixz>-3.52441e-06</ixz><iyy>1.06795e-05</iyy><iyz>1.1719e-05</iyz><izz>1.924e-05</izz></inertia></inertial>
<visual name='lwpla'><geometry><mesh><uri>model://vtol_plane/meshes/ruddervator_r_lwpla.stl</uri></mesh></geometry><material><ambient>0.92 0.90 0.85 1</ambient><diffuse>0.92 0.90 0.85 1</diffuse><specular>0.2 0.2 0.2 1</specular></material></visual>
</link>
<joint name='ruddervator_r_joint' type='revolute'><parent>base_link</parent><child>ruddervator_r</child><axis><xyz>-0.200029 0.808508 -0.553447</xyz><limit><lower>-0.5236</lower><upper>0.5236</upper><effort>0.2</effort></limit><dynamics><damping>0.001</damping></dynamics></axis></joint>
<link name='ruddervator_l'><pose>-0.6073 0.01137 0.00422 0 0 0</pose><inertial><pose>0.00068 0.09069 0.05594 0 0 0</pose><mass>0.00543</mass><inertia><ixx>2.50523e-05</ixx><ixy>-4.98365e-06</ixy><ixz>-3.52441e-06</ixz><iyy>1.06795e-05</iyy><iyz>-1.1719e-05</iyz><izz>1.924e-05</izz></inertia></inertial>
<visual name='lwpla'><geometry><mesh><uri>model://vtol_plane/meshes/ruddervator_l_lwpla.stl</uri></mesh></geometry><material><ambient>0.92 0.90 0.85 1</ambient><diffuse>0.92 0.90 0.85 1</diffuse><specular>0.2 0.2 0.2 1</specular></material></visual>
</link>
<joint name='ruddervator_l_joint' type='revolute'><parent>base_link</parent><child>ruddervator_l</child><axis><xyz>0.200029 0.808508 0.553447</xyz><limit><lower>-0.5236</lower><upper>0.5236</upper><effort>0.2</effort></limit><dynamics><damping>0.001</damping></dynamics></axis></joint>
<plugin filename='gz-sim-lift-drag-system' name='gz::sim::systems::LiftDrag'><!-- wing_inner_r --><link_name>base_link</link_name><air_density>1.225</air_density><area>0.06017</area><a0>0.09611</a0><cla>4.83628</cla><cda>0.16556</cda><cma>0</cma><alpha_stall>0.22745</alpha_stall><cla_stall>-1.5</cla_stall><cda_stall>1</cda_stall><cma_stall>0</cma_stall><cp>0.00501 -0.13991 0.00528</cp><forward>1 0 0</forward><upward>0 0 1</upward></plugin>
<plugin filename='gz-sim-lift-drag-system' name='gz::sim::systems::LiftDrag'><!-- wing_mid_r --><link_name>base_link</link_name><air_density>1.225</air_density><area>0.037413</area><a0>0.09611</a0><cla>4.83628</cla><cda>0.16556</cda><cma>0</cma><alpha_stall>0.22745</alpha_stall><cla_stall>-1.5</cla_stall><cda_stall>1</cda_stall><cma_stall>0</cma_stall><cp>0.01144 -0.38526 0.00378</cp><forward>1 0 0</forward><upward>0 0 1</upward><control_joint_name>aileron_mid_r_joint</control_joint_name><control_joint_rad_to_cl>-2.31787</control_joint_rad_to_cl></plugin>
<plugin filename='gz-sim-lift-drag-system' name='gz::sim::systems::LiftDrag'><!-- wing_tip_r --><link_name>base_link</link_name><air_density>1.225</air_density><area>0.035867</area><a0>0.09611</a0><cla>4.83628</cla><cda>0.16556</cda><cma>0</cma><alpha_stall>0.22745</alpha_stall><cla_stall>-1.5</cla_stall><cda_stall>1</cda_stall><cma_stall>0</cma_stall><cp>0.01713 -0.59653 0.00246</cp><forward>1 0 0</forward><upward>0 0 1</upward><control_joint_name>aileron_tip_r_joint</control_joint_name><control_joint_rad_to_cl>-2.26694</control_joint_rad_to_cl></plugin>
<plugin filename='gz-sim-lift-drag-system' name='gz::sim::systems::LiftDrag'><!-- wing_inner_l --><link_name>base_link</link_name><air_density>1.225</air_density><area>0.06017</area><a0>0.09611</a0><cla>4.83628</cla><cda>0.16556</cda><cma>0</cma><alpha_stall>0.22745</alpha_stall><cla_stall>-1.5</cla_stall><cda_stall>1</cda_stall><cma_stall>0</cma_stall><cp>0.00501 0.13991 0.00528</cp><forward>1 0 0</forward><upward>0 0 1</upward></plugin>
<plugin filename='gz-sim-lift-drag-system' name='gz::sim::systems::LiftDrag'><!-- wing_mid_l --><link_name>base_link</link_name><air_density>1.225</air_density><area>0.037413</area><a0>0.09611</a0><cla>4.83628</cla><cda>0.16556</cda><cma>0</cma><alpha_stall>0.22745</alpha_stall><cla_stall>-1.5</cla_stall><cda_stall>1</cda_stall><cma_stall>0</cma_stall><cp>0.01144 0.38526 0.00378</cp><forward>1 0 0</forward><upward>0 0 1</upward><control_joint_name>aileron_mid_l_joint</control_joint_name><control_joint_rad_to_cl>-2.31787</control_joint_rad_to_cl></plugin>
<plugin filename='gz-sim-lift-drag-system' name='gz::sim::systems::LiftDrag'><!-- wing_tip_l --><link_name>base_link</link_name><air_density>1.225</air_density><area>0.035867</area><a0>0.09611</a0><cla>4.83628</cla><cda>0.16556</cda><cma>0</cma><alpha_stall>0.22745</alpha_stall><cla_stall>-1.5</cla_stall><cda_stall>1</cda_stall><cma_stall>0</cma_stall><cp>0.01713 0.59653 0.00246</cp><forward>1 0 0</forward><upward>0 0 1</upward><control_joint_name>aileron_tip_l_joint</control_joint_name><control_joint_rad_to_cl>-2.26694</control_joint_rad_to_cl></plugin>
<plugin filename='gz-sim-lift-drag-system' name='gz::sim::systems::LiftDrag'><!-- vtail_r_pitch --><link_name>base_link</link_name><air_density>1.225</air_density><area>0.023351</area><a0>0</a0><cla>2.10018</cla><cda>0.05</cda><cma>0</cma><alpha_stall>0.3</alpha_stall><cla_stall>-1</cla_stall><cda_stall>1</cda_stall><cma_stall>0</cma_stall><cp>-0.51927 -0.10139 0.05933</cp><forward>1 0 0</forward><upward>0 0 1</upward><control_joint_name>ruddervator_r_joint</control_joint_name><control_joint_rad_to_cl>-2.21403</control_joint_rad_to_cl></plugin>
<plugin filename='gz-sim-lift-drag-system' name='gz::sim::systems::LiftDrag'><!-- vtail_r_yaw --><link_name>base_link</link_name><air_density>1.225</air_density><area>0.011449</area><a0>0</a0><cla>3.5448</cla><cda>0.05</cda><cma>0</cma><alpha_stall>0.3</alpha_stall><cla_stall>-1</cla_stall><cda_stall>1</cda_stall><cma_stall>0</cma_stall><cp>-0.51927 -0.10139 0.05933</cp><forward>1 0 0</forward><upward>0 1 0</upward><control_joint_name>ruddervator_r_joint</control_joint_name><control_joint_rad_to_cl>-3.16197</control_joint_rad_to_cl></plugin>
<plugin filename='gz-sim-lift-drag-system' name='gz::sim::systems::LiftDrag'><!-- vtail_l_pitch --><link_name>base_link</link_name><air_density>1.225</air_density><area>0.023351</area><a0>0</a0><cla>2.10018</cla><cda>0.05</cda><cma>0</cma><alpha_stall>0.3</alpha_stall><cla_stall>-1</cla_stall><cda_stall>1</cda_stall><cma_stall>0</cma_stall><cp>-0.51927 0.10139 0.05933</cp><forward>1 0 0</forward><upward>0 0 1</upward><control_joint_name>ruddervator_l_joint</control_joint_name><control_joint_rad_to_cl>-2.21403</control_joint_rad_to_cl></plugin>
<plugin filename='gz-sim-lift-drag-system' name='gz::sim::systems::LiftDrag'><!-- vtail_l_yaw --><link_name>base_link</link_name><air_density>1.225</air_density><area>0.011449</area><a0>0</a0><cla>3.5448</cla><cda>0.05</cda><cma>0</cma><alpha_stall>0.3</alpha_stall><cla_stall>-1</cla_stall><cda_stall>1</cda_stall><cma_stall>0</cma_stall><cp>-0.51927 0.10139 0.05933</cp><forward>1 0 0</forward><upward>0 -1 0</upward><control_joint_name>ruddervator_l_joint</control_joint_name><control_joint_rad_to_cl>-3.16197</control_joint_rad_to_cl></plugin>
<plugin filename='gz-sim-lift-drag-system' name='gz::sim::systems::LiftDrag'><!-- body_drag --><link_name>base_link</link_name><air_density>1.225</air_density><area>0.2669</area><a0>0.35</a0><cla>0</cla><cda>0.11429</cda><cma>0</cma><alpha_stall>1.5708</alpha_stall><cla_stall>0</cla_stall><cda_stall>0</cda_stall><cma_stall>0</cma_stall><cp>0 0 -0.00196</cp><forward>1 0 0</forward><upward>0 0 1</upward><radial_symmetry>true</radial_symmetry></plugin>
<plugin filename='gz-sim-joint-position-controller-system' name='gz::sim::systems::JointPositionController'><joint_name>tilt_r_joint</joint_name><sub_topic>servo_0</sub_topic><use_velocity_commands>true</use_velocity_commands><cmd_max>10.472</cmd_max><cmd_min>-10.472</cmd_min><initial_position>0</initial_position></plugin>
<plugin filename='gz-sim-joint-position-controller-system' name='gz::sim::systems::JointPositionController'><joint_name>tilt_l_joint</joint_name><sub_topic>servo_1</sub_topic><use_velocity_commands>true</use_velocity_commands><cmd_max>10.472</cmd_max><cmd_min>-10.472</cmd_min><initial_position>0</initial_position></plugin>
<plugin filename='gz-sim-joint-position-controller-system' name='gz::sim::systems::JointPositionController'><joint_name>aileron_mid_r_joint</joint_name><sub_topic>servo_2</sub_topic><use_velocity_commands>true</use_velocity_commands><cmd_max>10.472</cmd_max><cmd_min>-10.472</cmd_min><initial_position>0</initial_position></plugin>
<plugin filename='gz-sim-joint-position-controller-system' name='gz::sim::systems::JointPositionController'><joint_name>aileron_tip_r_joint</joint_name><sub_topic>servo_3</sub_topic><use_velocity_commands>true</use_velocity_commands><cmd_max>10.472</cmd_max><cmd_min>-10.472</cmd_min><initial_position>0</initial_position></plugin>
<plugin filename='gz-sim-joint-position-controller-system' name='gz::sim::systems::JointPositionController'><joint_name>aileron_mid_l_joint</joint_name><sub_topic>servo_4</sub_topic><use_velocity_commands>true</use_velocity_commands><cmd_max>10.472</cmd_max><cmd_min>-10.472</cmd_min><initial_position>0</initial_position></plugin>
<plugin filename='gz-sim-joint-position-controller-system' name='gz::sim::systems::JointPositionController'><joint_name>aileron_tip_l_joint</joint_name><sub_topic>servo_5</sub_topic><use_velocity_commands>true</use_velocity_commands><cmd_max>10.472</cmd_max><cmd_min>-10.472</cmd_min><initial_position>0</initial_position></plugin>
<plugin filename='gz-sim-joint-position-controller-system' name='gz::sim::systems::JointPositionController'><joint_name>ruddervator_r_joint</joint_name><sub_topic>servo_6</sub_topic><use_velocity_commands>true</use_velocity_commands><cmd_max>10.472</cmd_max><cmd_min>-10.472</cmd_min><initial_position>0</initial_position></plugin>
<plugin filename='gz-sim-joint-position-controller-system' name='gz::sim::systems::JointPositionController'><joint_name>ruddervator_l_joint</joint_name><sub_topic>servo_7</sub_topic><use_velocity_commands>true</use_velocity_commands><cmd_max>10.472</cmd_max><cmd_min>-10.472</cmd_min><initial_position>0</initial_position></plugin>
<plugin filename='gz-sim-multicopter-motor-model-system' name='gz::sim::systems::MulticopterMotorModel'><jointName>rotor_0_joint</jointName><linkName>rotor_0</linkName><turningDirection>cw</turningDirection><timeConstantUp>0.025</timeConstantUp><timeConstantDown>0.035</timeConstantDown><maxRotVelocity>2200</maxRotVelocity><motorConstant>3.14163e-06</motorConstant><momentConstant>0.0127</momentConstant><commandSubTopic>command/motor_speed</commandSubTopic><actuator_number>0</actuator_number><rotorDragCoefficient>2e-05</rotorDragCoefficient><rollingMomentCoefficient>1e-06</rollingMomentCoefficient><rotorVelocitySlowdownSim>10</rotorVelocitySlowdownSim><motorType>velocity</motorType></plugin>
<plugin filename='gz-sim-multicopter-motor-model-system' name='gz::sim::systems::MulticopterMotorModel'><jointName>rotor_1_joint</jointName><linkName>rotor_1</linkName><turningDirection>ccw</turningDirection><timeConstantUp>0.025</timeConstantUp><timeConstantDown>0.035</timeConstantDown><maxRotVelocity>2200</maxRotVelocity><motorConstant>3.14163e-06</motorConstant><momentConstant>0.0127</momentConstant><commandSubTopic>command/motor_speed</commandSubTopic><actuator_number>1</actuator_number><rotorDragCoefficient>2e-05</rotorDragCoefficient><rollingMomentCoefficient>1e-06</rollingMomentCoefficient><rotorVelocitySlowdownSim>10</rotorVelocitySlowdownSim><motorType>velocity</motorType></plugin>
<plugin filename='gz-sim-multicopter-motor-model-system' name='gz::sim::systems::MulticopterMotorModel'><jointName>rotor_2_joint</jointName><linkName>rotor_2</linkName><turningDirection>ccw</turningDirection><timeConstantUp>0.025</timeConstantUp><timeConstantDown>0.035</timeConstantDown><maxRotVelocity>2200</maxRotVelocity><motorConstant>3.14163e-06</motorConstant><momentConstant>0.0127</momentConstant><commandSubTopic>command/motor_speed</commandSubTopic><actuator_number>2</actuator_number><rotorDragCoefficient>2e-05</rotorDragCoefficient><rollingMomentCoefficient>1e-06</rollingMomentCoefficient><rotorVelocitySlowdownSim>10</rotorVelocitySlowdownSim><motorType>velocity</motorType></plugin>
</model>
</sdf>
