AjayaDahal/vtol-plane/scripts/params.py

"""v0.2 airframe geometry: the single source of truth for every generator and check.

Units are mm and g. Datum: x aft from the nose tip, y toward the right wing tip,
z up, with z = 0 on the fuselage centreline. Left-hand parts are the y-mirror of
the right-hand parts.
"""

# --- print fits -----------------------------------------------------------
LWPLA_WALL = 0.6            # effective LW-PLA vase wall (0.42 mm line, foamed)
FIT = 0.25                  # slip gap per side, PETG insert inside an LW-PLA shell
INSET = LWPLA_WALL + FIT    # PETG insert outer surface sits this far inside the skin
RING_WALL = 1.2             # PETG spigot / coupler ring wall

# --- wing (Clark Y, straight LE, flat bottom parallel to the datum, 0 deg dihedral)
X_LE = 380.0
Z_WING = -5.0
ROOT_CHORD, TIP_CHORD = 220.0, 150.0
Y_ROOT, Y_TIP = 60.0, 710.0


def chord(y):
    """Local wing chord at span station y (either wing)."""
    return ROOT_CHORD + (TIP_CHORD - ROOT_CHORD) * (abs(y) - Y_ROOT) / (Y_TIP - Y_ROOT)


RIB_T = 3.0
SPIGOT_LEN = 10.0
SPIGOT_CUT = 0.80           # spigot rings stop at 80 % chord (HINGE_MARGIN ahead of a hinge)
HINGE_MARGIN = 2.0          # 8 mm left a 7.7 mm unsupported ledge on the mid/tip rib flange
BOOM_Y = 280.0
BOOM_W = 28.0               # pod width (servo bay + walls)
BOOM_RIB_T = 6.0            # boom rib between the root and mid sections
Y_ROOT_RIB = (60.0, 63.0)
Y_ROOT_SEC = (63.0, BOOM_Y - BOOM_RIB_T / 2)
Y_BOOM_RIB = (BOOM_Y - BOOM_RIB_T / 2, BOOM_Y + BOOM_RIB_T / 2)
Y_POD = (BOOM_Y - BOOM_W / 2, BOOM_Y + BOOM_W / 2)
Y_MID_SEC = (BOOM_Y + BOOM_RIB_T / 2, 487.0)
Y_MIDTIP_RIB = (487.0, 490.0)
Y_TIP_SEC = (490.0, 707.0)

MAIN_SPAR = dict(x=432.0, z=Z_WING + 8.5, od=10.0, id=8.0)
REAR_SPAR = dict(x=480.0, z=Z_WING + 6.0, od=6.0, id=4.0)
SPAR_HOLE_CLEAR = 0.25      # hole diameter = tube OD + this
SPAR_BOSS_WALL = 1.4
MAIN_JOINER = dict(od=8.0, length=420.0)   # carbon tube inside both main spars
REAR_JOINER = dict(od=4.0, length=320.0)   # carbon rod inside both rear spars
RIB_WIRE_X, RIB_WIRE_Z, RIB_WIRE_R = 457.0, 5.0, 5.0   # spanwise wire/pitot hole between the spars

AIL_HINGE = 0.75            # hinge line at 75 % local chord (straight, top-surface tape)
AIL_BEVEL_DEG = 25.0        # underside bevel lets a top hinge deflect both ways
AIL_GAP = 0.6
AILERONS = {"mid": (286.0, 485.0), "tip": (492.0, 705.0)}

# --- tip fairings --------------------------------------------------------------
# The wing and V-tail tips are closed by LW-PLA vase fairings. Each butts against its skin's end
# over a hidden PETG ring (rib_tip, vtail_tip_cap), the way the fuselage sections join, so no rib
# band shows at a tip and the spar ends are covered. A fairing runs straight on over the ring,
# then closes: its faces curve in tangentially for the first TIP_SHOULDER of the closing length,
# then run straight in at ~41 deg from vertical as printed (root down; the vase limit is 45),
# while the leading and trailing edges pull in to round the planform's corners. The wing's flat
# bottom runs on flat, so its upper surface comes down to meet it at a sharp edge (a Hoerner
# tip); the V-tail's two faces meet on its chord plane.
TIP_RING_OUT = 5.0          # hidden ring length inside a fairing
TIP_STRAIGHT = 6.0          # a fairing runs straight on over its ring
TIP_SHOULDER = 0.35
TIP_END = 0.02              # thickness left at the closed end, fraction of the root's
WING_TIP_CLOSE, WING_TIP_RAKE = 26.0, (18.0, 8.0)   # closing length; LE and TE pull-in (mm)
VT_TIP_CLOSE, VT_TIP_RAKE = 14.0, (9.0, 4.0)

# --- internal webs in the vase-mode wing skins (skins.py) --------------------
# The skins span ~210 mm between ribs; without support the flattish top skin would wrinkle at
# 1-2 g near the root. Spanwise webs (top skin to bottom skin) cut every panel of the root and
# mid sections to <= 37 mm.
# Each web is a slot cut up from the bottom surface: the vase path runs up one side and back
# down the other, so the slicer prints it as part of the single wall.
LINE_W = 0.42               # LW-PLA vase line width (process_lwpla_vase.json)
WEB_SLOT = 0.06             # slot width (the profile's slice_closing_radius must stay below half)
# Slot end to outer surface. The slicer's outer wall (classic generator, thin walls off) splits a
# section at any neck under one line width (0.42), and the web stops touching the skin above
# ~0.84; 0.6 sits mid-window. Verified in the slicer on both printers (REPORT 6.1).
WEB_NECK = 0.6
WEB_RAMP = 0.8              # web depth grows 0.8 mm per mm of span at each end (< 45 deg lean)
WEB_END_CLEAR = 12.0        # webs stop this far from a section end (spigot rings go 10 mm in)
WEB_SPAR_CLEAR = 1.2        # spar surface to the web's printed face: room to slide the skin on
_HALF_WEB = WEB_SLOT / 2 + LINE_W


def _flank(spar):
    off = spar["od"] / 2 + WEB_SPAR_CLEAR + _HALF_WEB
    return spar["x"] - off, spar["x"] + off


MAIN_FLANK, REAR_FLANK = _flank(MAIN_SPAR), _flank(REAR_SPAR)
# Root: the wire bundle runs between the spar webs. Mid: the aileron servo (36 mm cage) lies
# between the main spar's aft web and the rear spar, so the rear spar's front web is left out.
# The main spar's front web is not needed: 402/405 to its aft web is <= 37 mm. The tip section
# has none: its top skin sees ~0.25e-3 strain at 3 g, a fifth of what buckles it (REPORT 6.2).
WING_WEBS = {
    "root": (405.0, MAIN_FLANK[1], *REAR_FLANK, 515.0, 545.0),
    "mid": (402.0, MAIN_FLANK[1], REAR_FLANK[1], 505.0),
}
PITOT_Y = 400.0             # right wing mid section; webs ahead of the wire hole open around it
PITOT_GAP = (392.0, 408.0)

# --- tilt mechanism (Stallion-style boom, direct-drive servo, one bearing) --
X_PIVOT = 315.0             # tilt axis, 65 mm ahead of the LE
Z_PIVOT = Z_WING + 20.0
POD_TOP = Z_PIVOT + 8.5
NOSE_R = 20.0
POD_AFT_X = X_LE - 2.0      # wide pod stops just ahead of the wing LE
TONGUE_X0 = 336.0           # boom-rib tongue runs forward into a slot in the pod
TONGUE_TOP = Z_PIVOT + 6.0
TONGUE_FAIR_X = (400.0, 445.0)   # tongue top ramps down into the wing between these x
POD_BOLTS_X = (348.0, 368.0)     # M3 bolts through pod and tongue
YOKE_PLATE_Z0 = 27.0        # plate back face above the pivot (hover orientation)
YOKE_PLATE_T = 4.0
YOKE_PLATE_U = 36.0
YOKE_ARM_T = 4.0
YOKE_BOSS_R = 9.0
BEARING_OD = 8.1            # 3x8x4 flanged bearing pocket (ream to fit)
SERVO_BODY = (24.0, 13.0, 21.0)   # bay length (x), height (z), depth (y): 12 mm mini servo
SERVO_SHAFT_FROM_FRONT = 6.0
SERVO_TAB_PITCH = 28.0
SERVO_ABOVE_TAB = 11.0      # tab face to spline top
HORN_T = 2.5
YOKE_ARM_IN = BOOM_W / 2 + SERVO_ABOVE_TAB + HORN_T   # arm inner face from the boom centre plane
AXLE_BOSS_R = 6.0
AXLE_BOSS_LEN = YOKE_ARM_IN - BOOM_W / 2 - 0.5
INSERT_HOLE = (4.2, 6.0)    # M3 heat-set insert: hole dia, depth
WIRE_D = 7.0
TILT_MIN_DEG, TILT_MAX_DEG = -20.0, 90.0   # 0 = thrust up, 90 = thrust forward

MOTOR_HOLE_SQ = 19.0        # Emax ECOII 2807: 19x19 mm M3 pattern
MOTOR_HOLE_D = 3.4
MOTOR_CENTER_D = 9.5
MOTOR_BASE_TO_PROP = 37.0   # motor base to prop disc, 2807 class
PROP_D = 178.0              # 7 in props

# --- fuselage pod (LW-PLA vase) + carbon tail boom -------------------------
FUSE_STATIONS = [           # x, width, height, centre z
    (0, 12, 12, 0), (60, 60, 70, 0), (120, 95, 115, 0), (240, 120, 140, 0),
    (360, 120, 135, 0), (480, 110, 120, 0), (600, 95, 105, 0),
    (680, 64, 70, -8), (740, 36, 36, -16), (760, 28, 28, -19)]
FUSE_SPLITS = [0.0, 240.0, 370.0, 610.0, 760.0]
COUPLER_HALF = 20.0
COUPLER_WALL = 1.0
FRAME_T = 3.0
SLEEVE_WALL = 1.6
NOSE_SCREW_X = 228.0        # M3 nylon screw holding the removable nose

BOOM_OD, BOOM_ID = 16.0, 14.0
BOOM_HOLE = BOOM_OD + 0.3
BOOM_Z = -20.0
BOOM_X = (420.0, 1050.0)
POD_COLLAR_X = (745.0, 760.0)

FC_SHELF_X = (255.0, 415.0)  # Pixhawk on the front part; the ESC block hangs under the aft part
FC_SHELF_Z = 32.0           # top surface
ESC_BLOCK_X = (360.0, 410.0)  # three ESCs on edge, strapped as one block under the FC shelf
# Battery tray: the pack slides on it from the nose opening to a 3 mm stop pin.
TRAY_X = (243.0, 395.0)
TRAY_Z = -52.0              # top surface
TRAY_W = 60.0
TRAY_PIN_X = (250.0, 391.0, 10.0)   # battery stop-pin holes: start, stop (exclusive), pitch
TRAY_PIN_R = 1.6
# Two Velcro straps loop round the battery: down through a slot beside it, under the plate
# through a gap in each rail, up through the slot on the other side. Threaded before the tray
# is glued in; they stay there and open on top of the battery.
TRAY_STRAP_X = (280.0, 330.0)
TRAY_STRAP_W = 22.0         # slot and rail-gap length along x (20 mm strap)
TRAY_STRAP_Y = (25.0, 27.8)  # slot, |y|: outside the 48 mm battery
GPS_X = 560.0               # external GPS saddle on top of fuse_3
GPS_PAD = 52.0              # square pad for a 50 mm puck
GPS_PAD_T = 2.0
GPS_SKIRT_T = 2.4
GPS_PAD_HOLE = 30.0         # lightens the pad; the GPS cable goes down through it

# --- rear lift motor (vertical, on the boom) --------------------------------
# As far forward as the clamp allows (its front face 2 mm behind the fuselage's end): it takes
# more of the hover load off the front motors, and the prop disc clears the V-tail by more.
# Its leads enter the boom through a hole just behind the clamp (BOOM_LEAD_X).
X_REAR_MOTOR = 780.0
BOOM_LEAD_X = 803.0
REAR_PLATE_Z = 15.0         # plate underside; leaves ~25 mm under the screw heads for a hex key
REAR_MOUNT_LEN = 36.0       # clamp, web and plate share this length along the boom

# --- V-tail (fixed panels + ruddervators) ----------------------------------
VT_X_LE = 920.0
VT_ROOT_CHORD, VT_TIP_CHORD, VT_SPAN = 180.0, 110.0, 240.0
VT_DIHEDRAL = 35.0          # each panel from horizontal (110 deg included)
VT_HINGE = 0.70
VT_ROOT = (11.0, -2.0)      # (y, z) of the right panel root chord line, rib outer face
VT_RUDDERVATOR = (5.0, 238.0)    # its outboard end clears the tip fairing by 2 mm, as the ailerons do
TAIL_BLOCK_X = (950.0, 1030.0)
VT_PIN_D = 4.1

# --- removable servo hatches (4 ailerons, 2 ruddervators) -----------------------
# A 9 g servo lies on its side on a PETG cover with two posts (servo_hatch). The cover sits
# flush in an opening cut in the skin and is held by two M2 screws into two PETG blocks glued
# inside the skin at its span ends (hatch_block); each block's ledge overlaps the cover's end.
# Local frame: a chordwise, b along the span, n into the airfoil; n = 0 on the outer skin.
HATCH_A = 17.0              # cover half-length (chordwise): fits the 37.9 mm aileron bay
HATCH_B = 21.0              # cover half-width (spanwise)
HATCH_T = 1.2               # cover thickness
HATCH_CLEAR = 0.2           # opening = cover + this, all round
HATCH_MID = 15.5            # |b| < this is free for the servo, its spline and horn (to ~14.5); ledges beyond
HATCH_GLUE = 6.0            # block glue face beyond the opening
HATCH_BLOCK_A = 8.0         # block half-length (chordwise)
HATCH_BLOCK_TOP = 5.7       # block top, n (an M2x6 screw: 1.2 mm cover + 4.5 mm block)
HATCH_SCREW_B = 18.25       # M2 screw station, |b|: 1.95 mm of ledge each side of the pilot hole
SERVO9_TAB_PITCH = 28.0     # 9 g servo mounting-tab hole pitch
HATCH_POST = (4.5, 8.0, 13.0)   # tab posts: chordwise, spanwise, height (0.25 mm clear of a 23 mm body)
# Wing hatches sit on the Clark Y's flat bottom between the main spar's aft web and the rear
# spar. V-tail hatches sit on the lower surface (a flat cover on a gently curved skin).
HATCH_VT = (55.0, 45.0)     # V-tail hatch centre: (u aft of the LE, s from the root rib face)

# --- tilt-servo plug pocket in the boom pod ----------------------------------
# Open on the pod's inboard face under the servo bay: the servo plugs into its extension lead
# here, so a servo can be swapped without cutting wires. The pocket rises to the bay, so the
# servo's lead drops straight in and nothing roofs it but the bay's own bridge (prints upright).
POD_PLUG_X = (306.5, 334.0)  # 27.5 mm: a mated JR/Futaba plug pair is ~25 mm
POD_PLUG_Z = (-2.0, Z_PIVOT - SERVO_BODY[1] / 2)
POD_PLUG_DEPTH = 11.5       # from the inboard face; reaches the wire channel
