AjayaDahal/vtol-plane/(commit log)

2026-10-31 Baseline: v0.1 design as received (before design review fixes)
    [battery_tray.stl, fuse_1.stl, fuse_2.stl, fuse_3.stl, fuse_4.stl, machine_kobra_s1.json, machine_kobra_x.json, motor_mount_rear.stl]
2026-10-31 Rebuild design from parametric build123d scripts; remove stale v0.1 parts, scripts and gcode
    [aileron_mid_l.stl, aileron_mid_r.stl, aileron_tip_l.stl, aileron_tip_r.stl, battery_tray.stl, boom_pod_l.stl, boom_pod_r.stl, boom_rib_l.stl]
2026-11-01 Add regenerated print_ready STLs (fuselage restored) and sliced G-code for all 44 parts
    [fuse_1.stl, fuse_2.stl, fuse_3.stl, fuse_4.stl]
2026-11-01 Verify sliced G-code (bed fit, supports, time, mass) and sync docs to measured values
    Fix tracker rows for frame_main and rear_motor_mount, BOM filament totals,
    AUW/wing loading and battery trim range from the G-code-based mass balance,
    and rewrite the stale SLICING.md.
2026-11-01 Add print-time reminders to tracker and AGENTS.md
2026-11-01 Round 5 pre-print audit: remove all supports, fix assembly order and PX4 setup, true statuses
    Print fixes (G-code mapped back onto the parts showed supports filling functional cavities):
    - boom_pod: 45 deg gusset under the axle boss and 45 deg nose chamfer; prints upright, no
    supports (tongue slot, servo bay and holes bridge)
    - boom_rib: inboard spigot ring split off as boom_cup (ring + glue plate); rib prints flat;
    wire channel is a groove; new wire/pitot hole lines up with the other ribs
    - rear_motor_mount: constant 36 mm section printed on end, plate raised 15 mm so a hex key
    reaches the motor screws, two clamp bolts
    - spigot rings stop 2 mm (not 8) ahead of a hinge: no 7.7 mm ledge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
    [boom_cup_l.stl, boom_cup_r.stl, boom_pod_l.stl, boom_pod_r.stl, boom_rib_l.stl, boom_rib_r.stl, coupler_240.stl, rear_motor_mount.stl]
2026-11-01 Verify external review claims; gate shared-file symmetry and print height
    - V-tail root rib and tip cap: one file for both sides is correct. Both parts are
    mirror-symmetric about their chord plane (0.00 mm), so the mirrored left part is the right
    part turned over. New check: every part printed from one shared file must be
    mirror-symmetric (fails the boom pod and boom rib, ~12 mm).
    - 240 mm S1 parts: top layer 240.0, highest move 242.0 (end-of-print lift) against the S1's
    250 mm printable height. The 240 mm height-to-lid setting is OrcaSlicer's by-object collision
    value only. New check: every G-code move within the printer's height.
    - DESIGN.md / PX4_GUIDE.md were already v0.2 in 6d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
    [check_parts.py]
2026-11-02 Add 3-D viewer and renders; gate flush, crease-free glued joints
    Renders and viewer
    - viewer/index.html (three.js) with scripts/make_viewer.py and scripts/serve_viewer.py:
    - preset views; colours as printed, one colour, reflection stripes or by part
    - x-ray skins and a tilt slider
    - normals smoothed across parts, so glued seams shade as one surface
    - ?capture=1 re-renders renders/*.png and two contact sheets
    - The server serves only the viewer, its manifest and the assembly STLs, and checks Host and
    Origin.
    - renders/: every side, forward flight, x-ray, and wing and joint close-ups in one colour
    and with reflection stripes.
    Joint flushness
    - check_parts.py, new check "glued skin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
    [boom_rib_l.stl, boom_rib_r.stl, rib_midtip_l.stl, rib_midtip_r.stl, rib_root_l.stl, rib_root_r.stl, rib_tip_l.stl, rib_tip_r.stl]
2026-11-02 Round 6: wing webs, ESC block, GPS saddle, insert fixes, burst viewer
    - Wing root and mid skins get spanwise internal webs printed as part of the
    vase wall (0.06 mm slots, 0.6 mm neck); both vase profiles now use
    slice_closing_radius 0.01 and detect_thin_wall 0 so the webs print fused.
    - FC shelf (x 255-415) carries the Pixhawk and, underneath, the three ESCs as
    one block; the battery tray (x 243-395) and shelf are cut to the coupler
    rings, which they used to overlap by up to 1 mm.
    - New gps_mount saddle on top of fuse_3: the GPS lived in a bay sealed in
    step 3.7. Rear motor moved to x = 790 so the front motors stay under 60 %
    of their near-empty thrust (AUW 1974 g).
    - scripts/pa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
    [battery_tray.stl, fc_shelf.stl, gps_mount.stl, rear_motor_mount.stl, wing_mid_l.stl, wing_mid_r.stl, wing_root_l.stl, wing_root_r.stl]
2026-11-02 Round 7: serviceability - servo hatches, battery straps, tilt-servo plug pocket
    - Aileron and ruddervator servos sit on removable screwed hatches (servo_hatch x6,
    hatch_block x12) instead of glued cages; V-tail hatch plane is a minimax fit.
    - Battery tray: strap slots beside the battery and gaps in both rails, so the two
    Velcro straps can loop round it (they were blocked before).
    - Boom pod: plug pocket under the tilt servo, open on the inboard face, so a tilt
    servo can be changed without cutting wires.
    - Yoke fitting order corrected (horn on the spline first, yoke lowered on from above).
    - Mass list counts straps, M2 screws, pushrods; CG target 28.5 % MAC, stop pin in the
    hole neare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
    [battery_tray.stl, boom_pod_l.stl, boom_pod_r.stl, hatch_block.stl, servo_cage.stl, servo_hatch.stl]
2026-11-02 Round 8: wing and V-tail tip fairings; rear motor to x=780; generated tracker
    - Wing tips close in Hoerner-style LW-PLA vase fairings (tip_fairing_l/r) over a
    hidden PETG ring (rib_tip): no flat end, spar ends or notch behind the aileron.
    Span 1420 -> 1478 mm. V-tail gets a symmetric fairing (vtail_tip_fairing x2,
    one file) over its tip ring; ruddervators run to s = 238.
    - Hover margin: the tip parts flipped the stop pin to x = 370 (60.1 %), so the
    rear motor moves 790 -> 780 and its boom lead hole to x = 803 (BOOM_LEAD_X).
    Front motors 59.7 %, CG 432.1 mm, static margin 19 %.
    - build_all/slice_all write the viewer manifest after slicing (also when a part
    fails to slice); new mak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
    [rear_motor_mount.stl, rib_tip_l.stl, rib_tip_r.stl, ruddervator_l.stl, ruddervator_r.stl, tip_fairing_l.stl, tip_fairing_r.stl, vtail_tip_cap.stl]
2026-11-03 Round 9: PETG print plates, printer rebalance, brim margins, stable pin rule
    - PETG prints as 7 plates on the S1 (scripts/plates.py): 53 prints, 474 g,
    17.5 h instead of 22.6 h as single files. Deterministic layout (print
    orientation kept, turned about z only, 6 mm apart, 15 mm inside the bed for
    the widest auto brim, 13.6 mm); each placed copy sliced as its own object
    with --arrange 0, so it keeps its own brim and can be cancelled on the
    printer. Single-part files stay for reprints.
    - LW-PLA vase skins cannot share a bed (by-object only, gantry 48/30 mm).
    - fuse_1, fuse_3, vtail_r, ruddervator_r moved to the X: S1 33.0 h (right
    wing + PETG plates), X 35.4 h (left wing, fuselage,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
2026-11-03 Flow test on each printer: wing_tip_l on the X as well as wing_tip_r on the S1
    Since round 9 the X prints most of the LW-PLA (35 h); its extruder differs from the S1's, so it gets its own 2.7 h test print before the rest. filament_lwpla.json is shared, so a one-printer flow fix needs its own profile.
2026-11-03 README: overview with animations, live 3-D viewer, CI gate, print schedule
    - README.md: hero turntable, badges (live CI gate), key numbers, four
    animations (hover to cruise, burst view, battery change, servicing),
    three ways to explore in 3-D, gallery, how it is built, pipeline and
    wiring diagrams (Mermaid), print schedule, quick start, repo map, status.
    - Animations: the viewer's capture mode records frame sequences
    (?capture=1 with the stills, ?capture=gif alone); serve_viewer.py
    assembles them into renders/anim_*.gif with Pillow (one palette, frames
    cropped to what changed; grid hidden, 5.8 MB for all five). The server
    now keeps connections alive with a longer accept queue,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
    [vtol_plane.stl]
2026-11-03 3S build plan for the owner's parts: SunnySky X2814 900KV on 12 in props
    PLAN_3S.md adapts the design to the parts the owner already has: the Zeee 3S
    8000 and IPO 6200 packs, the Cube Black, the Power Brick Mini, the 3DR GPS and
    the Readytosky 40 A ESCs. Each option was run through the repo's own mass
    balance and the gate's balance, fit, strap and prop-clearance checks.
    - Motor: SunnySky X2814 900KV (~$30) on APC 12x6, instead of the ~$50 T-Motor
    AT2814. Front motors at 47.9 % of near-empty thrust (limit 60 %; ~50-51 %
    with the propwash on the wing), ~18 min pure hover, 22 A in hover. The
    $16 Racerstar BR3536 would exceed the 40 A ESCs on a full pack and leave
    no hover margin. One m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
2026-11-03 One material per printer, active-foaming LW-PLA only, and the 3S BOM (BOM_3S.csv)
    - Every LW-PLA skin prints on the Kobra X (22 jobs, 50.9 h, 266 g: one
    spool, one flow test on wing_tip_r); all the PETG on the S1 as seven
    plates (17.5 h, 474 g). The six right-wing skins were re-sliced on the X
    with unchanged masses; the S1's LW-PLA files and render 37 are gone.
    Viewer, tracker, schedule chart and renders 35/38 follow.
    - The LW-PLA profile (flow 0.55 at 235 C) is for active-foaming LW-PLA
    (colorFabb). Pre-foamed LW-PLA (Polymaker, SUNLU, Overture Air) gets about
    half the plastic it needs from these files, and is ~85 g heavier with a
    profile of its own: BOM.md "Filament", SLICING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
    [BOM_3S.csv]
2026-11-03 Flow test cannot be passed by a pre-foamed spool; light-coloured LW-PLA
    - REPORT 10.3: printed from these files, a pre-foamed spool's wing_tip_r
    weighs ~10.7 g instead of 14.7 g. DESIGN.md said to change the flow when the
    weight is off: raised to ~0.76, the part would weigh right with ~24 % of
    its plastic missing from every wall. The test now checks the wall as well
    as the weight, and ~27 % light means a pre-foamed spool (DESIGN.md step 3,
    tracker.md).
    - REPORT 10.1: the 4S effect, from the mass balance with the skins scaled to
    0.9 g/cm3 at full flow: skins 351 g, AUW 2096 g, front motors 62.0 %.
    - REPORT 10.4: LW-PLA softens at 55-60 C (Polymaker: HDT 54 C); dark skins
    in summ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
    [BOM_3S.csv]
2026-11-03 LW-PLA with free shipping: SainSmart LW-PLA; Bambu PLA Aero as the cheaper option
    - BOM_3S.csv: the LW-PLA is now SainSmart LW-PLA, white, 1 kg, $47.49 on
    Amazon with free delivery (no Prime needed); active foaming above 210 C,
    down to 0.54 g/cm3. colorFabb's Amazon listing adds $11 shipping. The
    priced total is now $211.28.
    - BOM.md "Filament": the active-foaming LW-PLAs checked against the profile,
    with US prices and shipping. Bambu Lab PLA Aero (1 kg, white or grey,
    $26.99; $6.99 shipping under $59) is the cheapest: Bambu's foaming table
    gives a minimum flow of ~0.53 at 235 C, against the profile's 0.55.
    Creality Lightweight PLA foams less (~0.8 g/cm3): not recommended.
    - SL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
    [BOM_3S.csv]
2026-11-04 Complete slicer projects, slicer 2.0 re-slice and print audit (round 11)
    - 3mf/complete_project_kobra_x_lwpla.3mf (22 plates) and
    3mf/complete_project_kobra_s1_petg.3mf (7 plates): one named plate per job,
    in print order, assembled by make_projects.py from the jobs' own 3MFs.
    build_all.py slices every plate again and checks it against its job's G-code.
    - Every job is also a 3MF project in 3mf/, and its G-code is sliced from it.
    - Re-sliced in Anycubic Slicer Next 2.0.0.3; the printer files now come from its
    presets (the S1 gains a purge line).
    - Bed temperature 55 C for LW-PLA and 75 C for PETG on all six plate types
    (the 1.3.3.3 CLI's cool plate gave 35 C and 60 C).
    - PETG brims s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
    [BOM_3S.csv, aileron_mid_l.3mf, aileron_mid_r.3mf, aileron_tip_l.3mf, aileron_tip_r.3mf, battery_tray.3mf, boom_cup_l.3mf, boom_cup_r.3mf]
2026-11-04 Slice previews, support-audit render, and hole edges printed in mid-air (round 11)
    - scripts/preview_slices.py draws every plate from its G-code the way the
    slicer's preview does: renders/48 (the X's 22 plates), 49 (the S1's 7) and
    50 (the PETG first layers). Each picture carries a hash of every plate's
    label and G-code, which the gate checks. build_all.py and slice_all.py
    redraw them.
    - audit_print.py --render draws renders/51: where the slicer would add
    supports (13 PETG parts, all inside holes or under bridged spans), with
    the reason for each.
    - Found by looking at the previews: hole edges in bridged ceilings printed
    in mid-air before the bridge (pods 12 mm out, rib_midtip 7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
    [BOM_3S.csv, aileron_mid_l.3mf, aileron_mid_r.3mf, aileron_tip_l.3mf, aileron_tip_r.3mf, battery_tray.3mf, boom_cup_l.3mf, boom_cup_r.3mf]
2026-11-05 PX4 SITL flight simulation with video, and a premortem (rounds 12 and 13)
    - scripts/make_sim.py writes a Gazebo Harmonic model, a world and a PX4
    v1.17 airframe into sim/ from the design: every mass_balance.py row
    placed in 3-D, PX4_GUIDE.md's rotor geometry and outputs, the wing and
    V-tail as lifting surfaces. build_all.py and slice_all.py run it.
    - sim/: install.sh (into a PX4 tree), fly_test.py (automated VTOL check
    mission, ten checks, log analysis and plot), chase_cam.py (films the
    flight), variant.py (stress variants of the installed model).
    - New gate checks (123 in total): sim/ matches make_sim.py's output, and
    the model's static margin is within 3 % MAC of mass_balance.p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
    [aileron_mid_l_lwpla.stl, aileron_mid_r_lwpla.stl, aileron_tip_l_lwpla.stl, aileron_tip_r_lwpla.stl, base_link_bell.stl, base_link_carbon.stl, base_link_lwpla.stl, base_link_motor.stl]
